MEGA65/mega65-r3-expansion-board/bridge-board-bom.md

Digikey cart for parts for 5 units

# 	PRODUCT DETAILS 	QUANTITY 	AVAILABILITY 	UNIT PRICE 	EXTENDED PRICE
1
	
‎450-1661-ND‎
‎2-1825027-0‎
SWITCH TACTILE SPST-NO 0.05A 24V
	5 	
Immediate
	0.40000 	AU$2.00
2
	
‎CF14JT10K0CT-ND‎
‎CF14JT10K0‎
RES 10K OHM 5% 1/4W AXIAL
	100 	
Immediate
	0.02570 	AU$2.57
3
	
‎4985-2044-2X06G00RA-ND‎
‎2044-2X06G00RA‎
PCB SOCKET, DOUBLE ROW, 12 PIN,
	10 	
Immediate
	1.29200 	AU$12.92
4
	
‎296-9137-1-ND‎
‎SN74CBTLV3257DR‎
IC MUX/DEMUX 4 X 1:2 16-SOIC
	10 	
Immediate
	0.64100 	AU$6.41
5
	
‎4985-2044-2X17G00SA-ND‎
‎2044-2X17G00SA‎
PCB SOCKET, DOUBLE ROW, 24 PIN,
	10 	
Immediate
	1.85600 	AU$18.56
6
	
‎2223-SSK02-FPH-254-A4-ND‎
‎SSK02-FPH-254-A4‎
2.54MM FEMALE HEADER 1X4PIN, Y T
	10 	
Immediate
	0.40000 	AU$4.00
7
	
‎2223-SSK02-FPH-254-A8-ND‎
‎SSK02-FPH-254-A8‎
2.54MM FEMALE HEADER 1X8PIN, Y T
	10 	
Immediate
	0.50700 	AU$5.07
8
	
‎4985-2047-2X05G00S3U-ND‎
‎2047-2X05G00S3U‎
PCB SOCKET, DOUBLE ROW, 10 PIN,
	5 	
Immediate
	2.16000 	AU$10.80
9
	
‎2057-PH1RB-20-UA-ND‎
‎PH1RB-20-UA‎
CONN HEADER R/A 20POS 2.54MM
	10 	
Immediate
	0.66800 	AU$6.68
10
	
‎2648-SC0918CT-ND‎
‎SC0918‎
RASPBERRY PI PICO W RP2040
	5 	
Immediate
	8.86000 	AU$44.30
11
	
‎732-3818-1-ND‎
‎693063020911‎
CONN SD CARD R/A SMD
	5 	
Immediate
	5.18000 	AU$25.90
