MEGA65/mega65-r3-expansion-board/expansion_connector_board/footprints/2-1825027-0.step

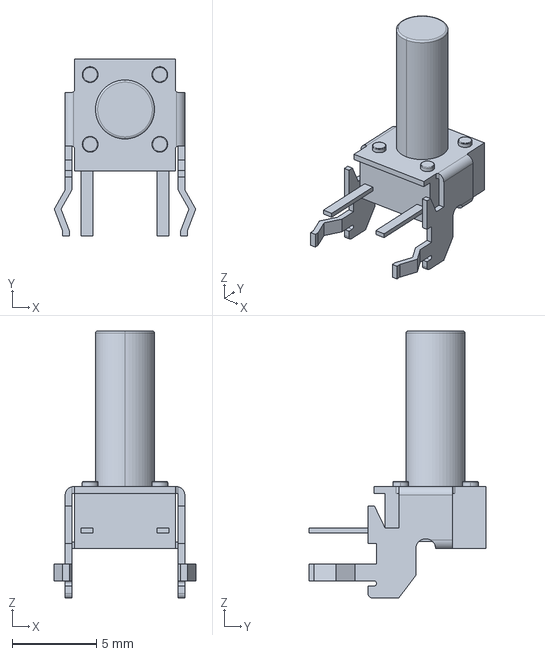
[picture p1: CAD file, 2026-07-13]
expansion_connector_board/footprints/2-1825027-0.step
8.41 x 10.5 x 15.9 mm
