MEGA65/mega65-r3-expansion-board/expansion_connector_board/footprints/10067847-001RLF.step

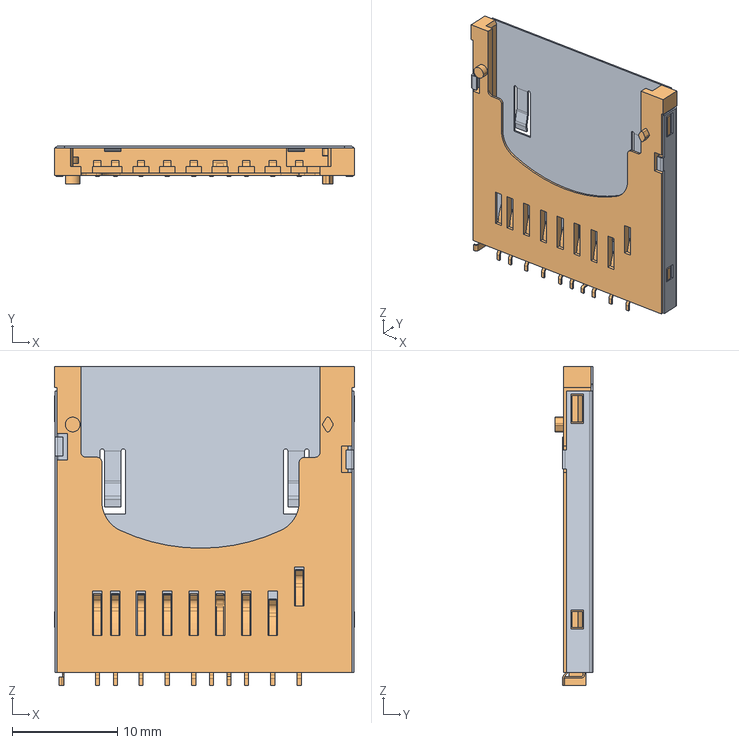
[picture p2: CAD file, 2026-07-13]
expansion_connector_board/footprints/10067847-001RLF.step
28.4 x 3.60 x 30.3 mm
PRT0003
PRT0005
