MEGA65/mega65-r3-expansion-board/(threads)

Thread 10 (2023-12-15):

Corrections to revC layout

gardners, 2023-12-15:
Move H10 10mm right.
Move H7 1mm right.
Move H9 0.25mm up and right.

Closed 2024-03-03.

Thread 11 (2023-12-15):

74LS595s are missing 5V marking on silkscreen

gardners, 2023-12-15:

Closed 2024-03-03.

Thread 12 (2024-03-03):

J6 is next to wrong power connector on expansion board

gardners, 2024-03-03:
... probably easier to move it on the bridge board. Whichever board requires a respin can have the correction.

Thread 14 (2024-03-09):

PMOD connector board is still a bit tight on revE

gardners, 2024-03-09:
Confirm estimated difference and fix. Probably another 0.5mm further apart between the two PMOD pairs. But that's just an estimate.
The boards _do_ fit together, it's just hard to put it all together.
