MEGA65/mega65-r3-expansion-board/jtag_base_board/jtag_base_board.kicad_pcb

## KiCad design jtag_base_board/jtag_base_board.kicad_pcb (2026-10-13)

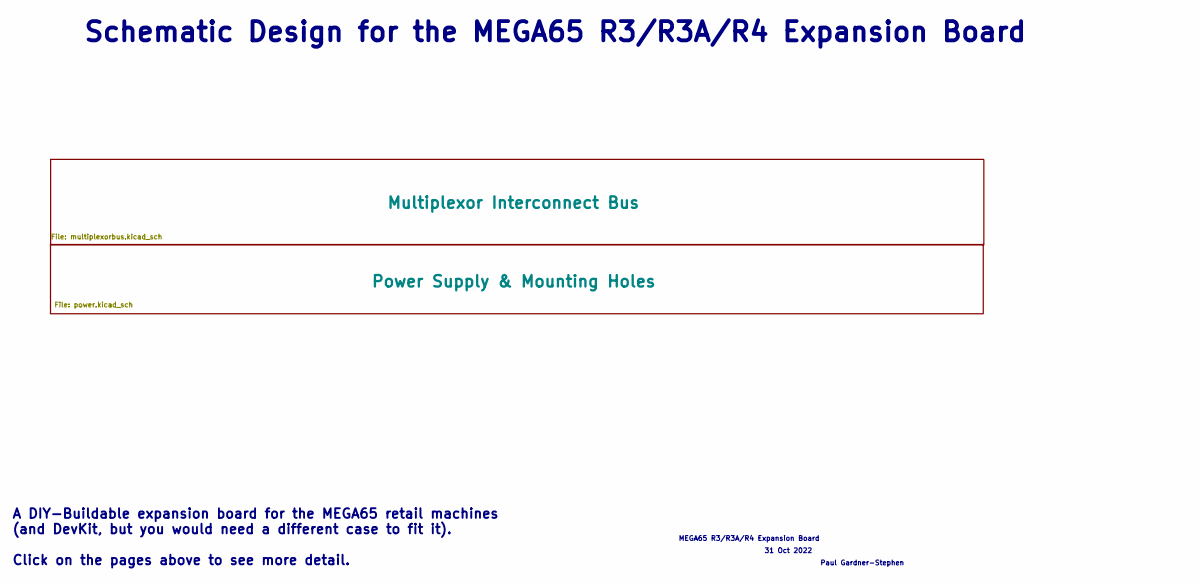
[picture p3: schematic jtag_base_board.kicad_sch]

Notes on the sheet:
Paul Gardner-Stephen
A DIY-Buildable expansion board for the MEGA65 retail machines (and DevKit, but you would need a different case to fit it). Click on the pages above to see more detail.
31 Oct 2022
MEGA65 R3/R3A/R4 Expansion Board
Schematic Design for the MEGA65 R3/R3A/R4 Expansion Board

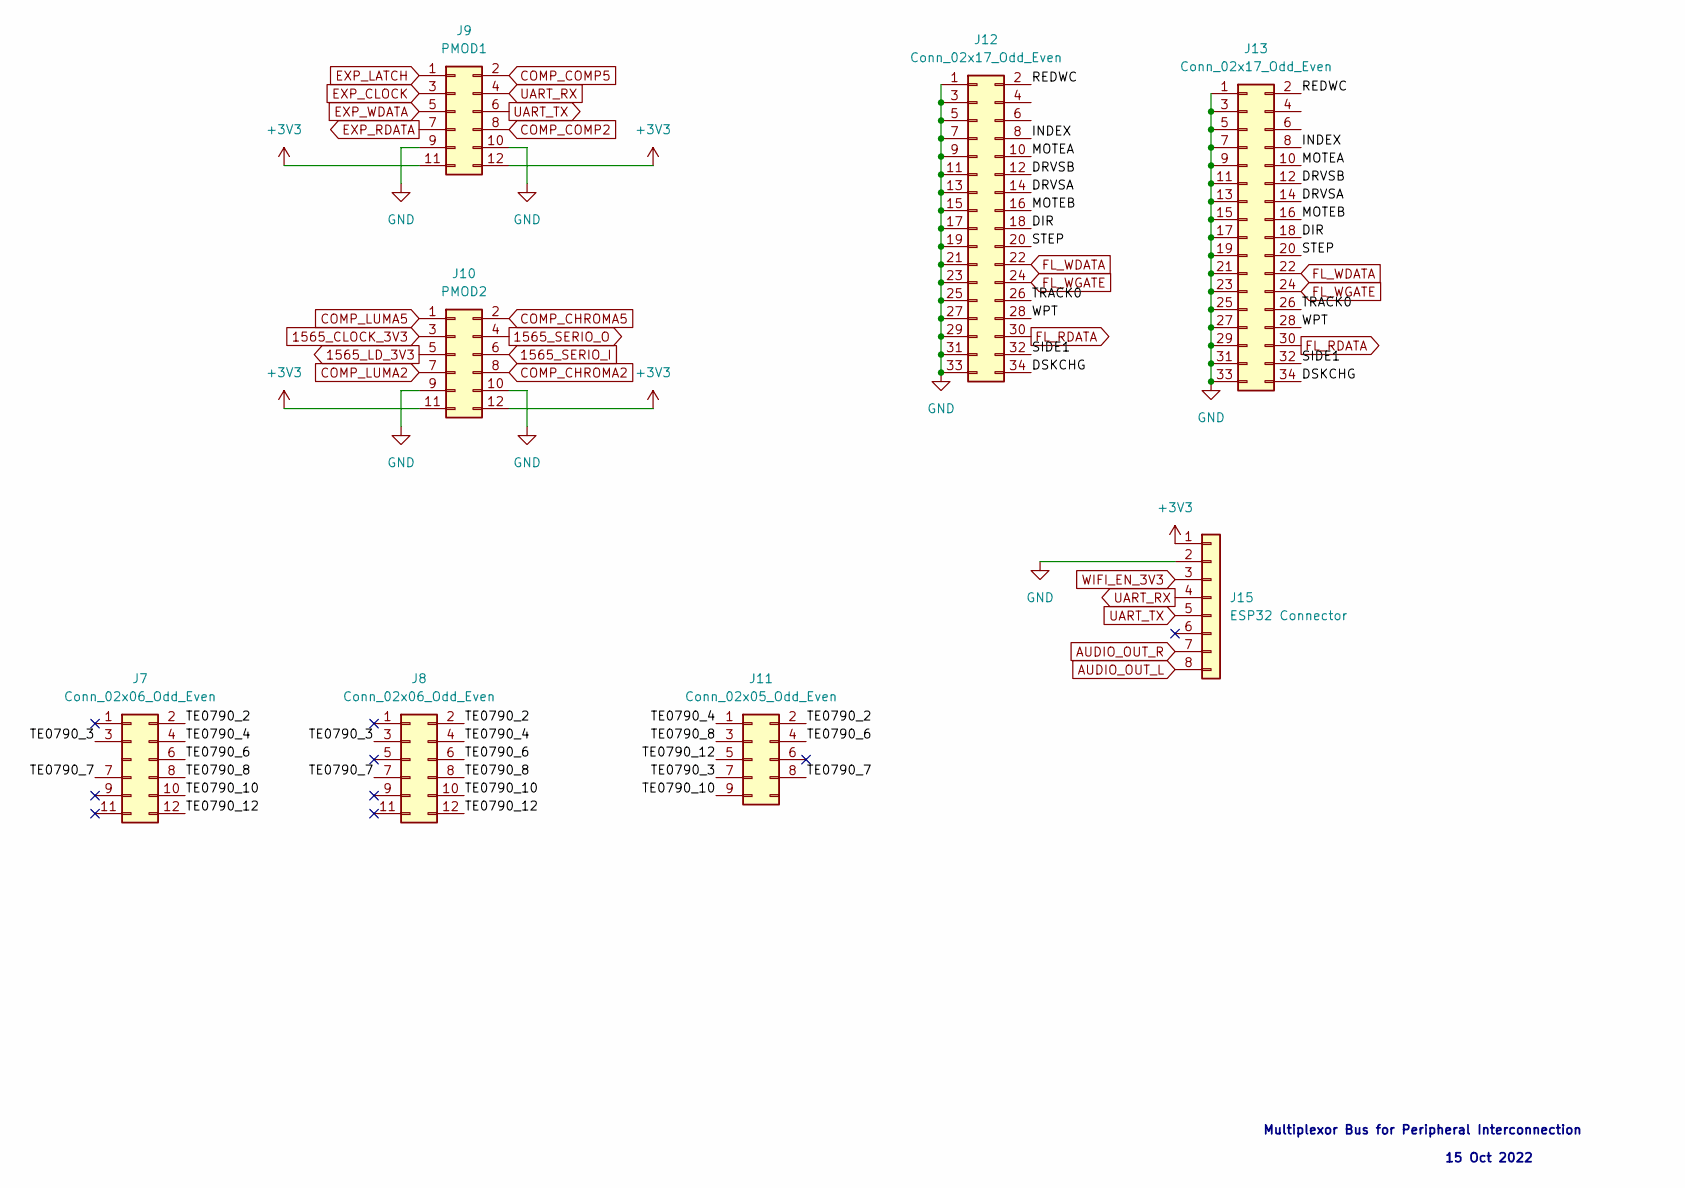
[picture p4: schematic multiplexorbus.kicad_sch]

Parts:
J7, J8: Conn_02x06_Odd_Even; PinHeader_2x06_P2.54mm_Vertical
J9: PMOD1; PinHeader_2x06_P2.54mm_Vertical
J10: PMOD2; PinHeader_2x06_P2.54mm_Vertical
J11: Conn_02x05_Odd_Even; PinHeader_2x05_P2.54mm_Vertical
J12, J13: Conn_02x17_Odd_Even; PinHeader_2x17_P2.54mm_Vertical
J15: ESP32 Connector; PinHeader_1x08_P2.54mm_Vertical

Connections:
1565_CLOCK_3V3: J10.3
1565_LD_3V3: J10.5
1565_SERIO_I: J10.6
1565_SERIO_O: J10.4
+3V3: J9.11, J9.12, J10.11, J10.12, J15.1
/Multiplexor Interconnect Bus/DIR: J12.18, J13.18
/Multiplexor Interconnect Bus/DRVSA: J12.14, J13.14
/Multiplexor Interconnect Bus/DRVSB: J12.12, J13.12
/Multiplexor Interconnect Bus/DSKCHG: J12.34, J13.34
/Multiplexor Interconnect Bus/INDEX: J12.8, J13.8
/Multiplexor Interconnect Bus/MOTEA: J12.10, J13.10
/Multiplexor Interconnect Bus/MOTEB: J12.16, J13.16
/Multiplexor Interconnect Bus/REDWC: J12.2, J13.2
/Multiplexor Interconnect Bus/SIDE1: J12.32, J13.32
/Multiplexor Interconnect Bus/STEP: J12.20, J13.20
/Multiplexor Interconnect Bus/TE0790_2: J7.2, J8.2, J11.2
/Multiplexor Interconnect Bus/TE0790_3: J7.3, J8.3, J11.7
/Multiplexor Interconnect Bus/TE0790_4: J7.4, J8.4, J11.1
/Multiplexor Interconnect Bus/TE0790_6: J7.6, J8.6, J11.4
/Multiplexor Interconnect Bus/TE0790_7: J7.7, J8.7, J11.8
/Multiplexor Interconnect Bus/TE0790_8: J7.8, J8.8, J11.3
/Multiplexor Interconnect Bus/TE0790_10: J7.10, J8.10, J11.9
/Multiplexor Interconnect Bus/TE0790_12: J7.12, J8.12, J11.5
/Multiplexor Interconnect Bus/TRACK0: J12.26, J13.26
/Multiplexor Interconnect Bus/WPT: J12.28, J13.28
AUDIO_OUT_L: J15.8
AUDIO_OUT_R: J15.7
COMP_CHROMA2: J10.8
COMP_CHROMA5: J10.2
COMP_COMP2: J9.8
COMP_COMP5: J9.2
COMP_LUMA2: J10.7
COMP_LUMA5: J10.1
EXP_CLOCK: J9.3
EXP_LATCH: J9.1
EXP_RDATA: J9.7
EXP_WDATA: J9.5
FL_RDATA: J12.30, J13.30
FL_WDATA: J12.22, J13.22
FL_WGATE: J12.24, J13.24
GND: J9.9, J9.10, J10.9, J10.10, J12.1, J12.3, J12.5, J12.7, J12.9, J12.11, J12.13, J12.15, J12.17, J12.19, J12.21, J12.23, J12.25, J12.27, J12.29, J12.31, J12.33, J13.1, J13.3, J13.5, J13.7, J13.9, J13.11, J13.13, J13.15, J13.17, J13.19, J13.21, J13.23, J13.25, J13.27, J13.29, J13.31, J13.33, J15.2; also elsewhere on the board
UART_RX: J9.4, J15.4
UART_TX: J9.6, J15.5
WIFI_EN_3V3: J15.3

Notes on the sheet:
Multiplexor Bus for Peripheral Interconnection
15 Oct 2022

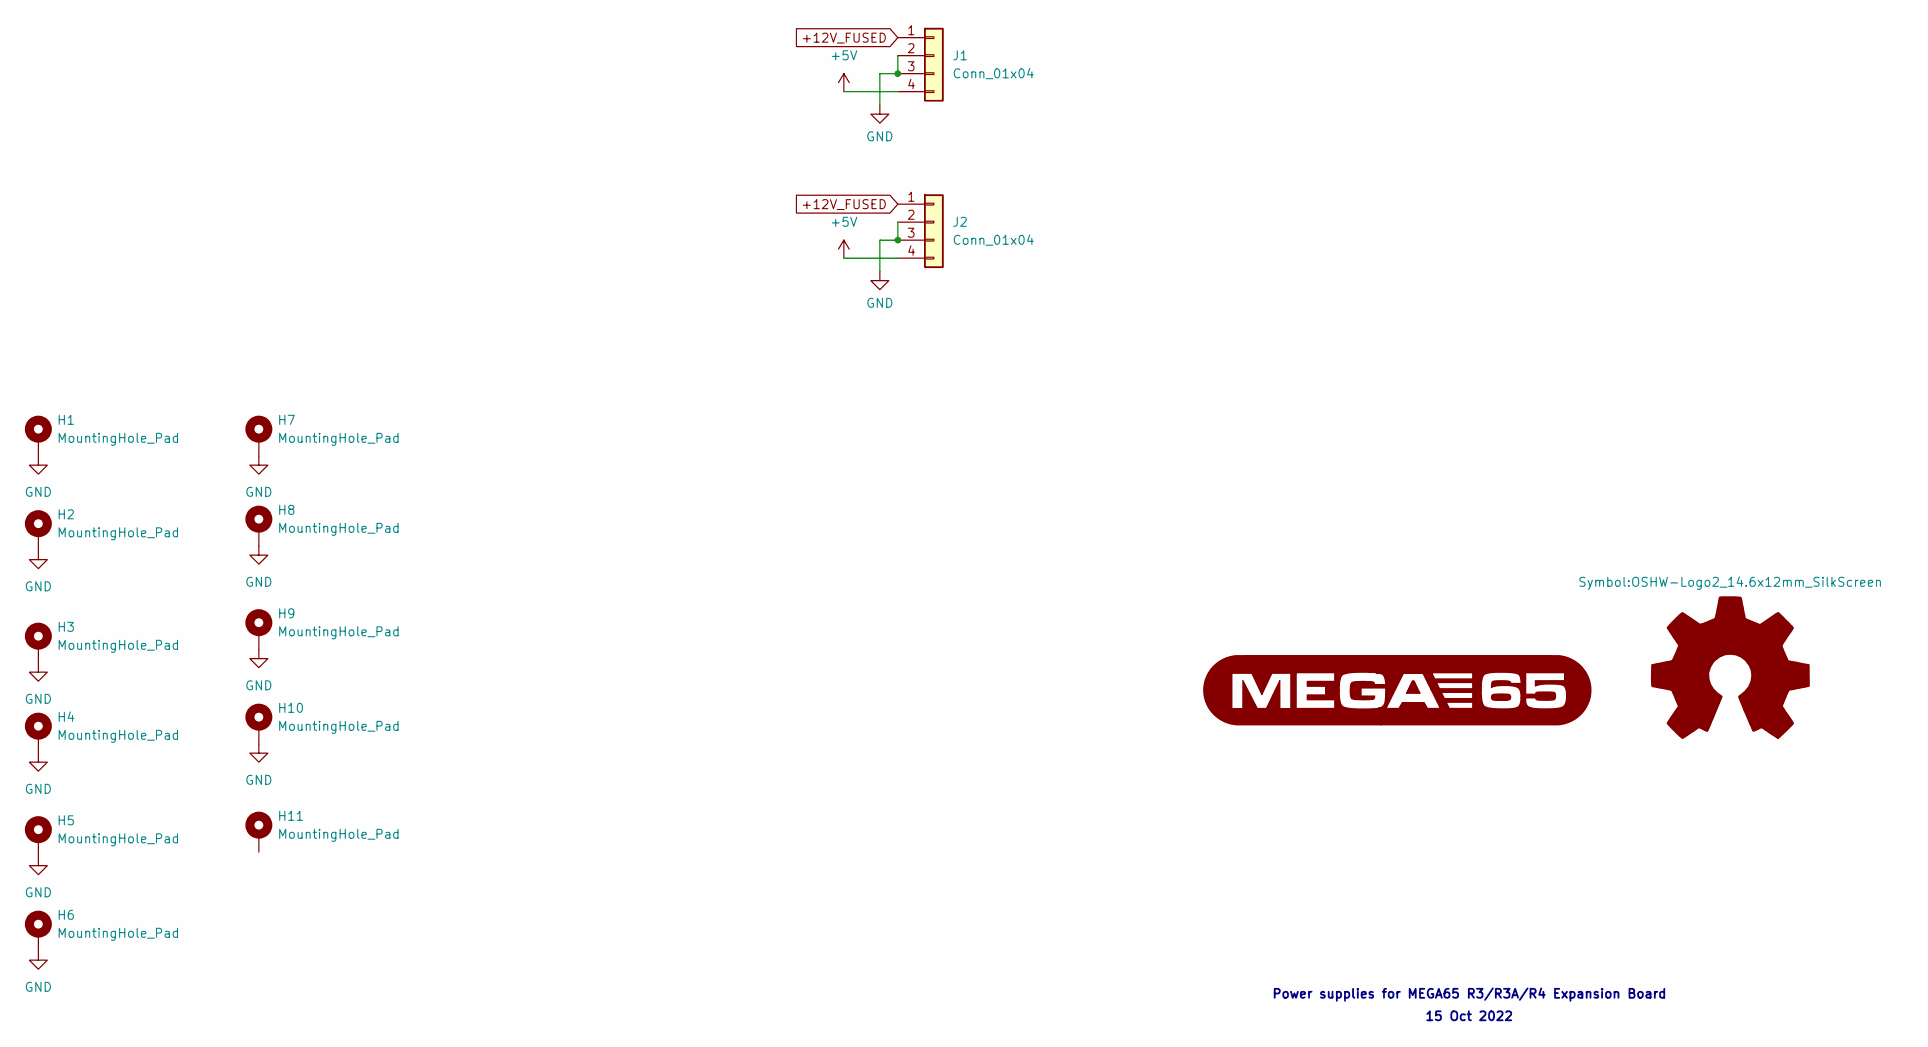
[picture p5: schematic power.kicad_sch]

Parts:
H1, H2, H3, H4, H5, H6, H7, H8, H9, H10, H11: MountingHole_Pad; MountingHole_3.2mm_M3_DIN965_Pad
J1, J2: Conn_01x04; FloppyPower
LOGO1: Logo_Open_Hardware_Large; OSHW-Logo2_14.6x12mm_SilkScreen

Connections:
+5V: J1.4, J2.4
+12V_FUSED: J1.1, J2.1
GND: H1.1 (1_1), H2.1 (1_1), H3.1 (1_1), H4.1 (1_1), H5.1 (1_1), H6.1 (1_1), H7.1 (1_1), H8.1 (1_1), H9.1 (1_1), H10.1 (1_1), J1.2, J1.3, J2.2, J2.3; also elsewhere on the board

Notes on the sheet:
Power supplies for MEGA65 R3/R3A/R4 Expansion Board
15 Oct 2022

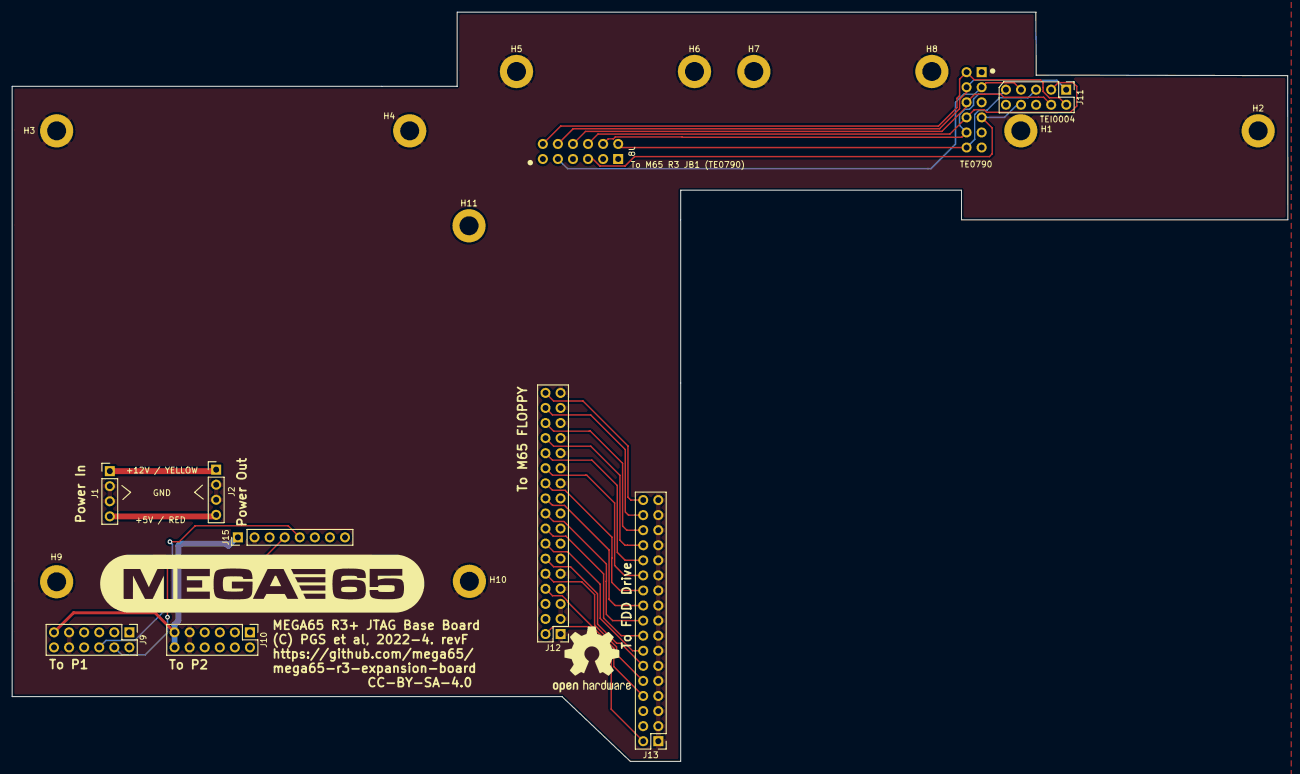
[picture p6: board jtag_base_board.kicad_pcb from above]

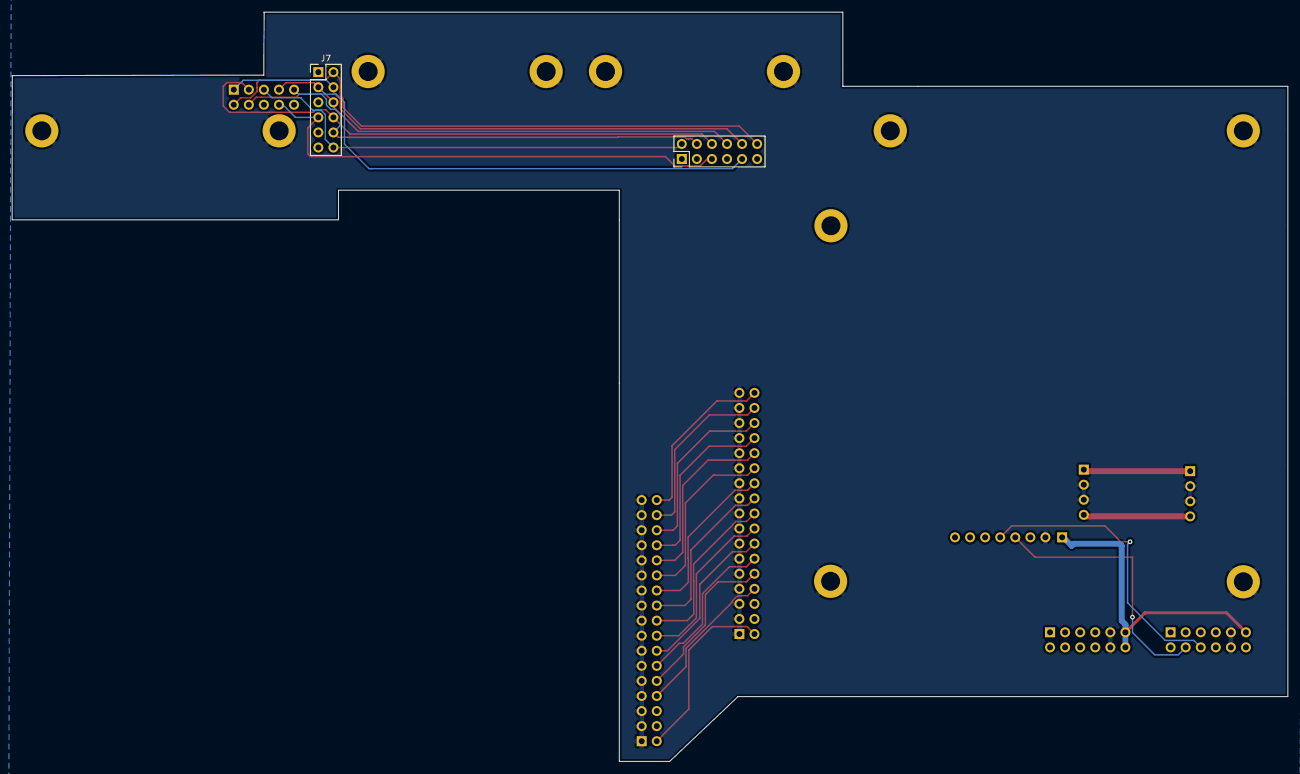
[picture p7: board jtag_base_board.kicad_pcb from below]

Board: 2 copper layers, 215.0 x 126.3 mm, 22 parts (2 on the bottom side), 29 nets.
