MEGA65/mega65-r3-expansion-board/expansion_connector_board/expansion_connector_board.kicad_pcb

## KiCad design expansion_connector_board/expansion_connector_board.kicad_pcb (2026-07-16)

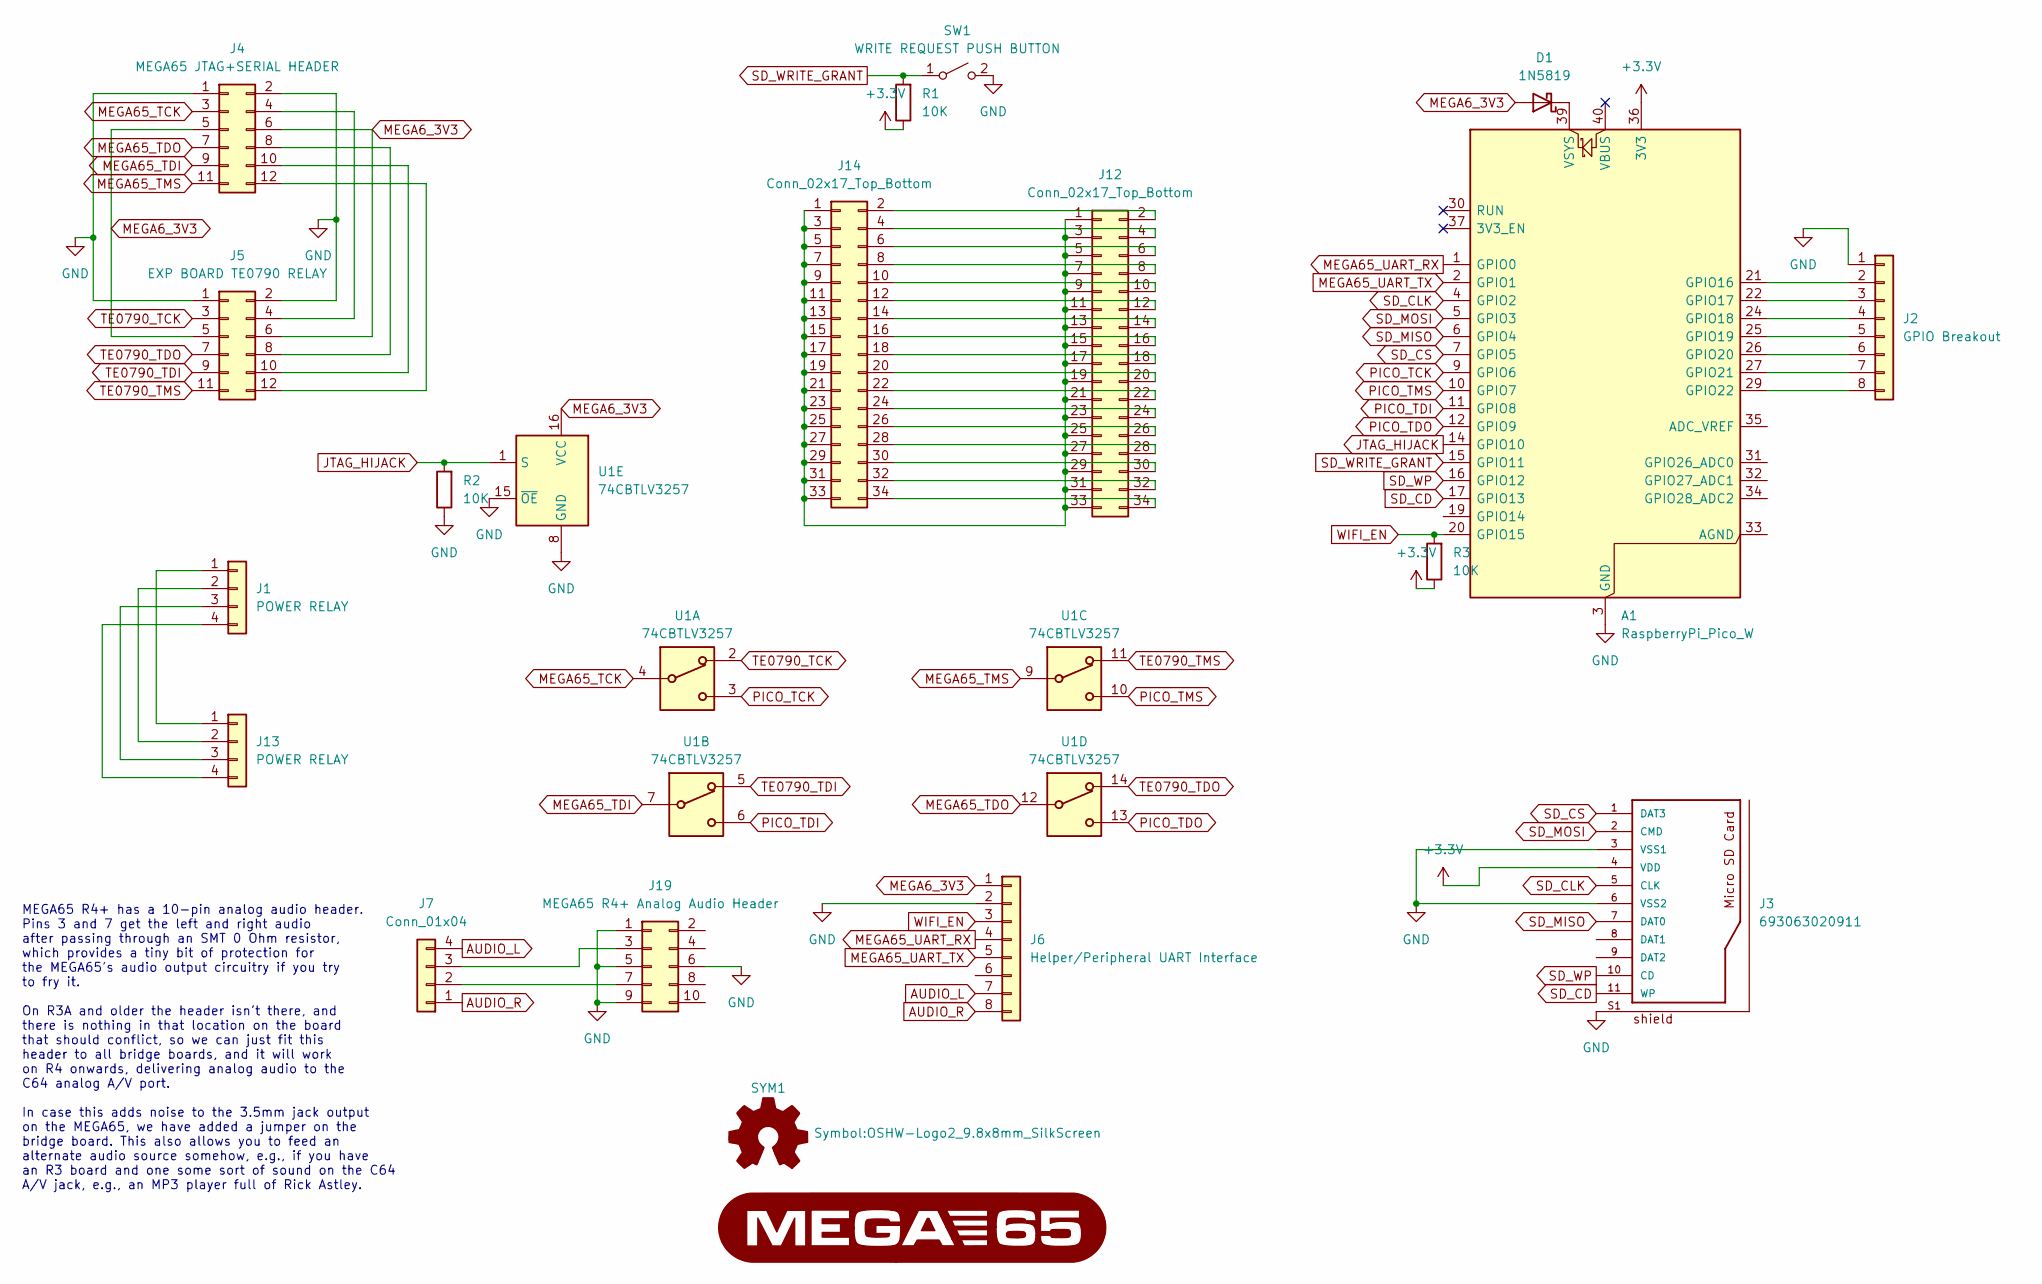
[picture p8: schematic expansion_connector_board.kicad_sch]

Parts:
A1: RaspberryPi_Pico_W; RaspberryPi_Pico_W_SMD_HandSolder
D1: 1N5819; D_DO-41_SOD81_P10.16mm_Horizontal
G1: LOGO; MEGA65-logo
J1, J13: POWER RELAY; PinHeader_1x04_P2.54mm_Vertical
J2: GPIO Breakout; PinHeader_1x08_P2.54mm_Vertical
J3: 693063020911
J4: MEGA65 JTAG+SERIAL HEADER; PinHeader_2x06_P2.54mm_Vertical
J5: EXP BOARD TE0790 RELAY; PinHeader_2x06_P2.54mm_Vertical
J6: Helper/Peripheral UART Interface; PinHeader_1x08_P2.54mm_Vertical
J7: Conn_01x04; PinHeader_1x04_P2.54mm_Vertical
J12, J14: Conn_02x17_Top_Bottom; PinHeader_2x17_P2.54mm_Vertical
J19: MEGA65 R4+ Analog Audio Header; PinHeader_2x05_P2.54mm_Vertical
R1, R2, R3: 10K; R_Axial_DIN0207_L6.3mm_D2.5mm_P10.16mm_Horizontal
SW1: WRITE REQUEST PUSH BUTTON; TE_2-1825027-0
SYM1: Logo_Open_Hardware_Small; OSHW-Logo2_9.8x8mm_SilkScreen
U1: 74CBTLV3257; SOIC-16_3.9x9.9mm_P1.27mm

Connections:
+3.3V: A1.36 (3V3), J3.4 (VDD), R1.1, R3.1
AUDIO_L: J6.7, J7.4
AUDIO_R: J6.8, J7.1
GND: A1.3 (GND), A1.8 (GND), A1.13 (GND), A1.18 (GND), A1.23 (GND), A1.28 (GND), A1.38 (GND), J2.1, J3.3 (VSS1), J3.6 (VSS2), J3.S1, J3.S2, J3.S3, J3.S4, J4.1, J4.2, J5.1, J5.2, J6.2, J19.1, J19.5, J19.6, J19.9, R2.1, SW1.2 (B), U1.8 (GND), U1.15 (~OE)
JTAG_HIJACK: A1.14 (GPIO10), R2.2, U1.1 (S)
MEGA6_3V3: D1.2 (A), J4.5, J4.6, J5.5, J5.6, J6.1, U1.16 (VCC)
MEGA65_TCK: J4.3, U1.4
MEGA65_TDI: J4.9, U1.7
MEGA65_TDO: J4.7, U1.12
MEGA65_TMS: J4.11, U1.9
MEGA65_UART_RX: A1.1 (GPIO0), J6.4
MEGA65_UART_TX: A1.2 (GPIO1), J6.5
unnamed: A1.21 (GPIO16), J2.2
unnamed: A1.22 (GPIO17), J2.3
unnamed: A1.24 (GPIO18), J2.4
unnamed: A1.25 (GPIO19), J2.5
unnamed: A1.26 (GPIO20), J2.6
unnamed: A1.27 (GPIO21), J2.7
unnamed: A1.29 (GPIO22), J2.8
unnamed: A1.39 (VSYS), D1.1 (K)
unnamed: J1.1, J13.1
unnamed: J1.2, J13.2
unnamed: J1.3, J13.3
unnamed: J1.4, J13.4
unnamed: J4.4, J5.4
unnamed: J4.8, J5.8
unnamed: J4.10, J5.10
unnamed: J4.12, J5.12
unnamed: J12.1, J12.3, J12.5, J12.7, J12.9, J12.11, J12.13, J12.15, J12.17, J12.19, J12.21, J12.23, J12.25, J12.27, J12.29, J12.31, J12.33, J14.1, J14.3, J14.5, J14.7, J14.9, J14.11, J14.13, J14.15, J14.17, J14.19, J14.21, J14.23, J14.25, J14.27, J14.29, J14.31, J14.33
unnamed: J12.2, J14.2
unnamed: J12.4, J14.4
unnamed: J12.6, J14.6
unnamed: J12.8, J14.8
unnamed: J12.10, J14.10
unnamed: J12.12, J14.12
unnamed: J12.14, J14.14
unnamed: J12.16, J14.16
unnamed: J12.18, J14.18
unnamed: J12.20, J14.20
unnamed: J12.22, J14.22
unnamed: J12.24, J14.24
unnamed: J12.26, J14.26
unnamed: J12.28, J14.28
unnamed: J12.30, J14.30
unnamed: J12.32, J14.32
unnamed: J12.34, J14.34
unnamed: J7.3, J19.3
unnamed: J7.2, J19.7
PICO_TCK: A1.9 (GPIO6), U1.3
PICO_TDI: A1.11 (GPIO8), U1.6
PICO_TDO: A1.12 (GPIO9), U1.13
PICO_TMS: A1.10 (GPIO7), U1.10
SD_CD: A1.17 (GPIO13), J3.11 (WP)
SD_CLK: A1.4 (GPIO2), J3.5 (CLK)
SD_CS: A1.7 (GPIO5), J3.1 (DAT3)
SD_MISO: A1.6 (GPIO4), J3.7 (DAT0)
SD_MOSI: A1.5 (GPIO3), J3.2 (CMD)
SD_WP: A1.16 (GPIO12), J3.10 (CD)
SD_WRITE_GRANT: A1.15 (GPIO11), R1.2, SW1.1 (A)
TE0790_TCK: J5.3, U1.2
TE0790_TDI: J5.9, U1.5
TE0790_TDO: J5.7, U1.14
TE0790_TMS: J5.11, U1.11
WIFI_EN: A1.20 (GPIO15), J6.3, R3.2

Notes on the sheet:
MEGA65 R4+ has a 10-pin analog audio header. Pins 3 and 7 get the left and right audio after passing through an SMT 0 Ohm resistor, which provides a tiny bit of protection for the MEGA65's audio output circuitry if you try to fry it. On R3A and older the header isn't there, and there is nothing in 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

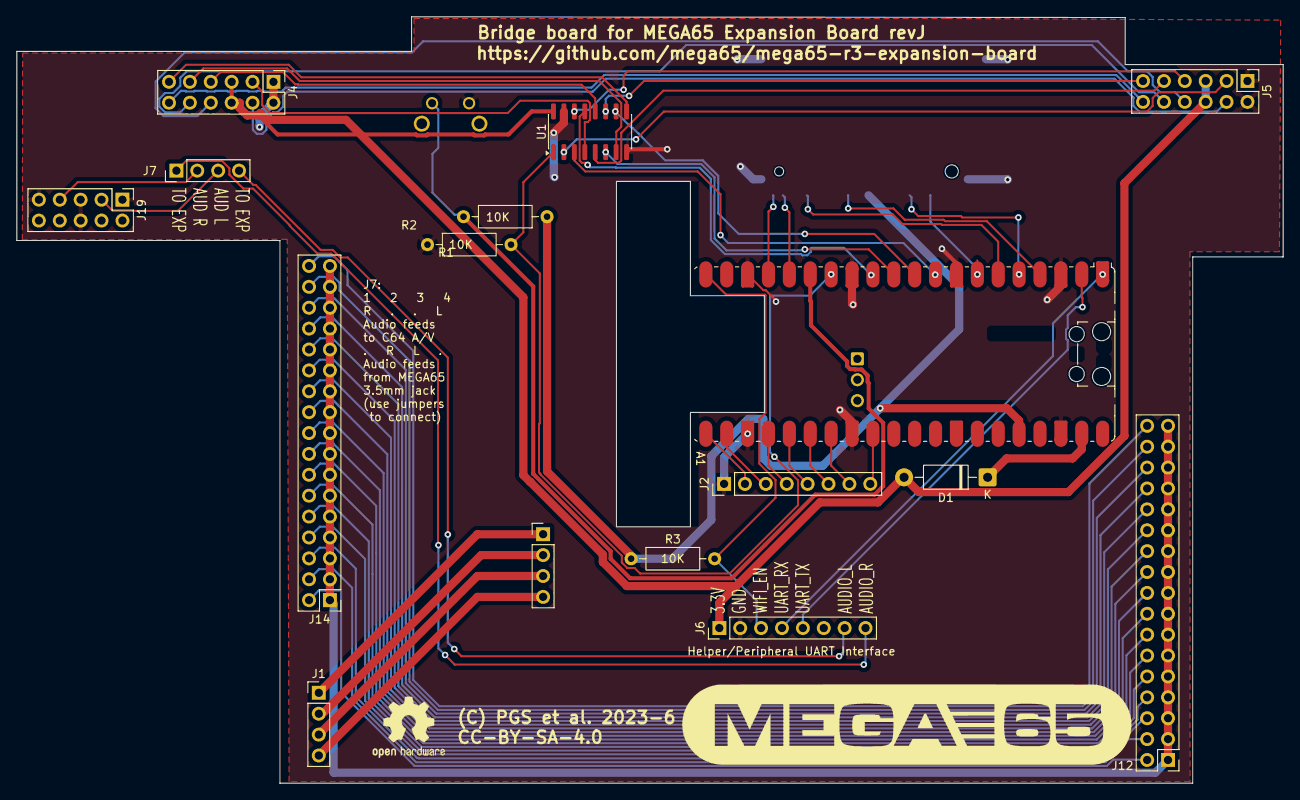
[picture p9: board expansion_connector_board.kicad_pcb from above]

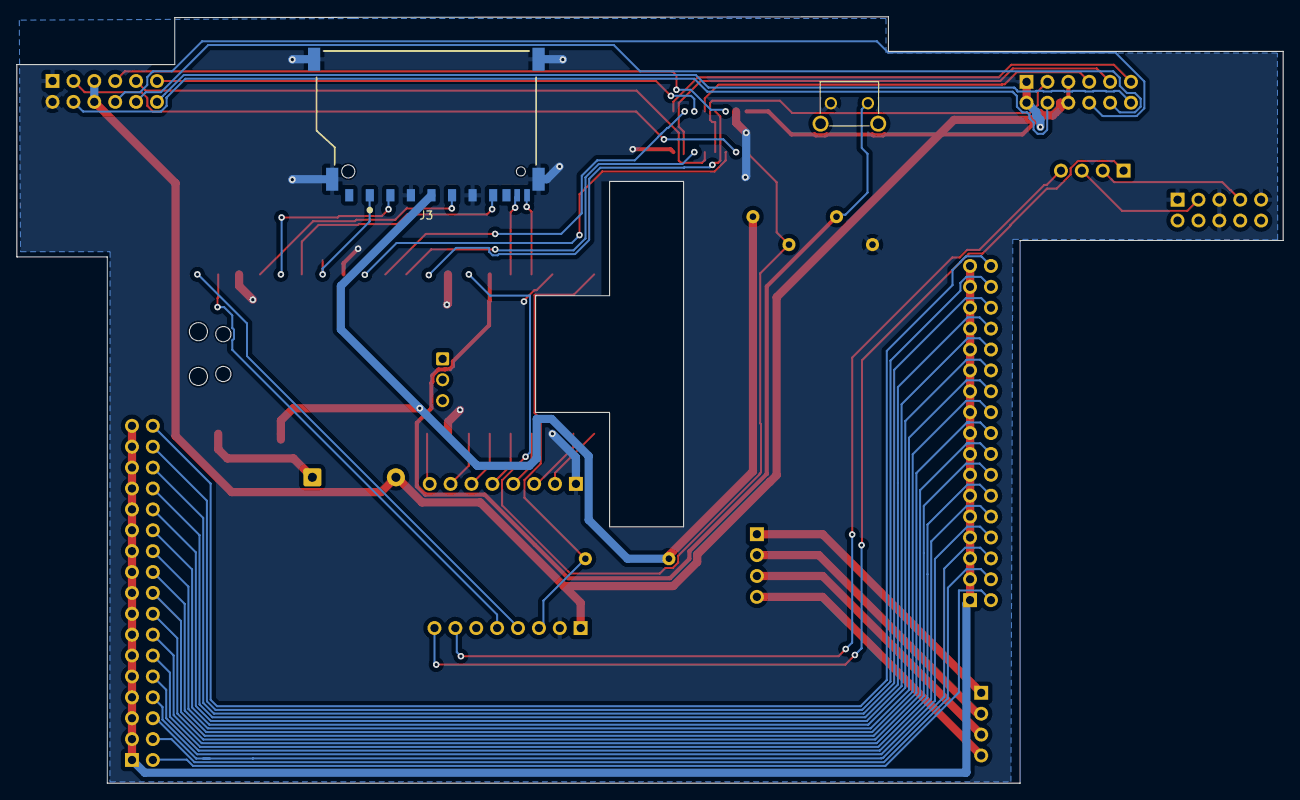
[picture p10: board expansion_connector_board.kicad_pcb from below]

Board: 2 copper layers, 154.0 x 93.2 mm, 20 parts (2 on the bottom side), 64 nets.
