MEGA65/mega65-r3-expansion-board/mega65-r3-expansion-board.kicad.kicad_pcb

## KiCad design mega65-r3-expansion-board.kicad.kicad_pcb (2026-07-13)

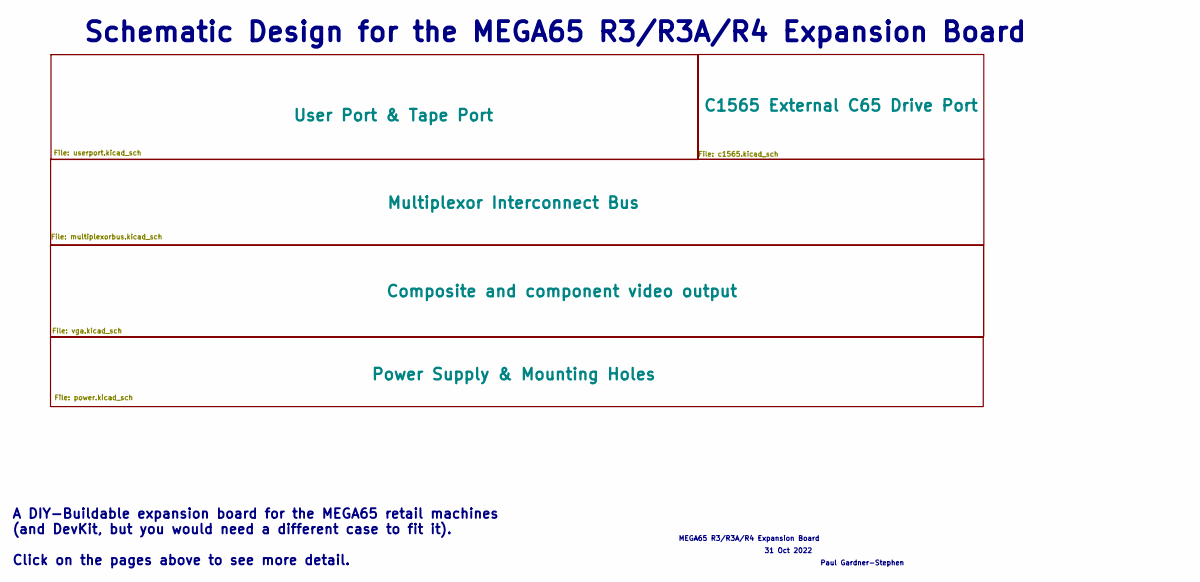
[picture p11: schematic mega65-r3-expansion-board.kicad.kicad_sch]

Notes on the sheet:
Paul Gardner-Stephen
A DIY-Buildable expansion board for the MEGA65 retail machines (and DevKit, but you would need a different case to fit it). Click on the pages above to see more detail.
31 Oct 2022
MEGA65 R3/R3A/R4 Expansion Board
Schematic Design for the MEGA65 R3/R3A/R4 Expansion Board

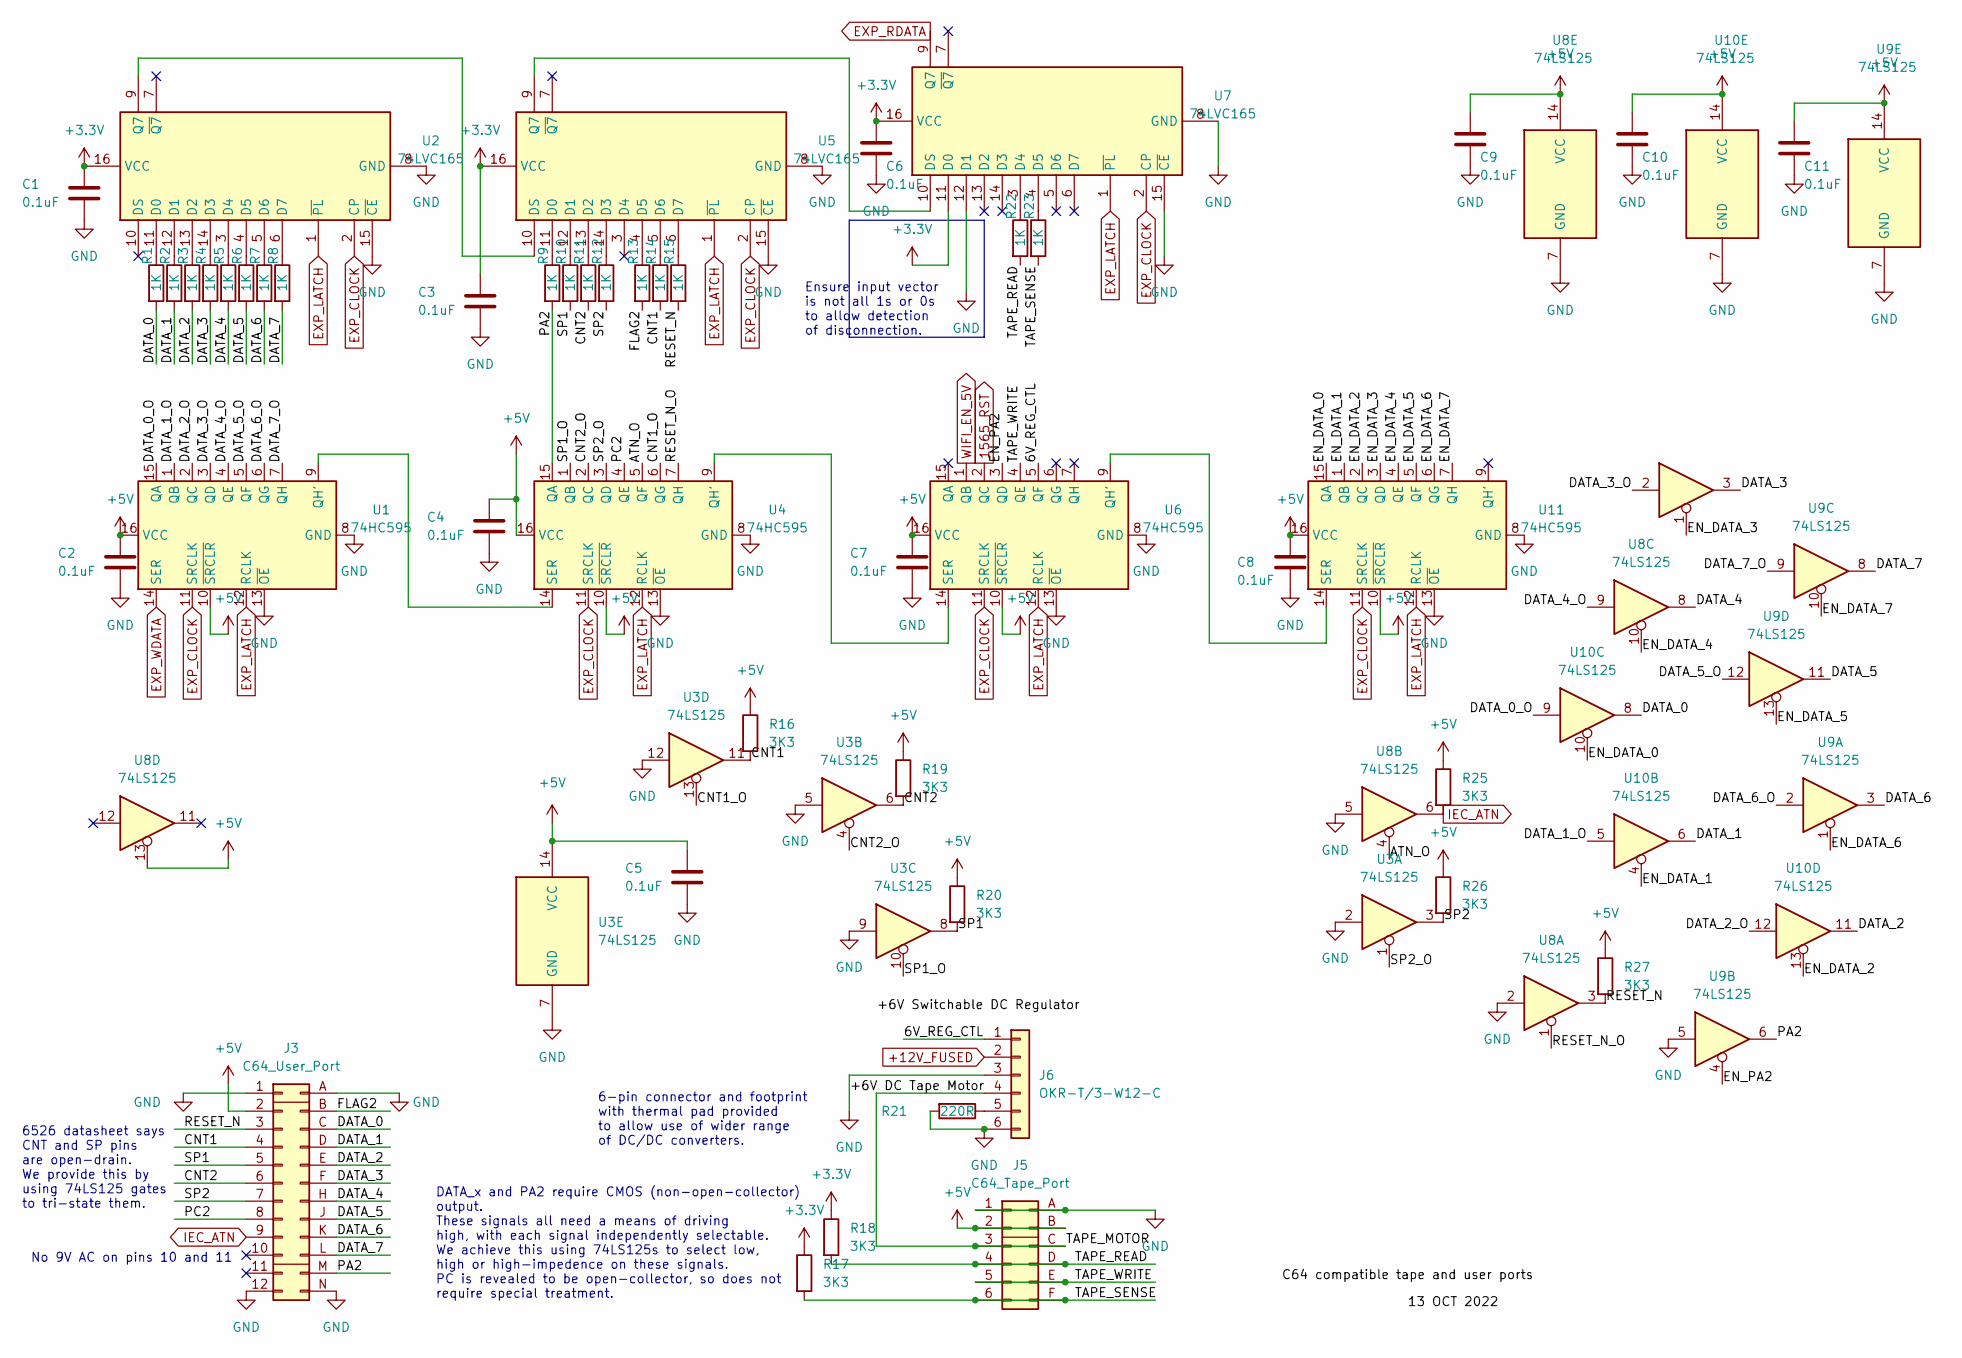
[picture p12: schematic userport.kicad_sch]

Parts:
C1, C2, C3, C4, C5, C6, C7, C8, C9, C10, C11: 0.1uF; C_Disc_D5.0mm_W2.5mm_P5.00mm
J3: C64_User_Port; C64-User-Port-Male
J5: C64_Tape_Port; C64-Cassette-Port-Male
J6: OKR-T/3-W12-C; TO-220-FP-5
R1, R2, R3, R4, R5, R6, R7, R8, R9, R10, R11, R12, R13, R14, R15, R22, R23: 1K; Labeled Resistor
R16, R17, R18, R19, R20, R25, R26, R27: 3K3; Labeled Resistor
R21: 220R; Labeled Resistor
U1, U4, U6, U11: 74HC595; DIP-16_LS_Family
U2, U5, U7: 74LVC165; DIP-16_LVC_Family
U3, U8, U9, U10: 74LS125; DIP-14_74LS06

Connections:
1565_RST: U6.2 (QC); also elsewhere on the board
+3V3: C1.1, C3.1, C6.1, R17.1, R18.1, U2.16 (VCC), U5.16 (VCC), U7.11 (D0), U7.16 (VCC); also elsewhere on the board
+5V: C2.1, C4.1, C5.1, C7.1, C8.1, C9.1, C10.1, C11.1, J3.2, J5.2, J5.B, R16.1, R19.1, R20.1, R25.1, R26.1, R27.1, U1.10 (~SRCLR), U1.16 (VCC), U3.14 (VCC), U4.10 (~SRCLR), U4.16 (VCC), U6.10 (~SRCLR), U6.16 (VCC), U8.13, U8.14 (VCC), U9.14 (VCC), U10.14 (VCC), U11.10 (~SRCLR), U11.16 (VCC); also elsewhere on the board
+12V_FUSED: J6.2; also elsewhere on the board
/User Port & Tape Port/6V_REG_CTL: J6.1, U6.5 (QF)
/User Port & Tape Port/ATN_O: U4.5 (QF), U8.4
/User Port & Tape Port/CNT1: J3.4, R14.2, R16.2, U3.11
/User Port & Tape Port/CNT1_O: U3.13, U4.6 (QG)
/User Port & Tape Port/CNT2: J3.6, R11.2, R19.2, U3.6
/User Port & Tape Port/CNT2_O: U3.4, U4.2 (QC)
/User Port & Tape Port/DATA_0: J3.C, R1.2, U10.8
/User Port & Tape Port/DATA_0_O: U1.15 (QA), U10.9
/User Port & Tape Port/DATA_1: J3.D, R2.2, U10.6
/User Port & Tape Port/DATA_1_O: U1.1 (QB), U10.5
/User Port & Tape Port/DATA_2: J3.E, R3.2, U10.11
/User Port & Tape Port/DATA_2_O: U1.2 (QC), U10.12
/User Port & Tape Port/DATA_3: J3.F, R4.2, U10.3
/User Port & Tape Port/DATA_3_O: U1.3 (QD), U10.2
/User Port & Tape Port/DATA_4: J3.H, R5.2, U8.8
/User Port & Tape Port/DATA_4_O: U1.4 (QE), U8.9
/User Port & Tape Port/DATA_5: J3.J, R6.2, U9.11
/User Port & Tape Port/DATA_5_O: U1.5 (QF), U9.12
/User Port & Tape Port/DATA_6: J3.K, R7.2, U9.3
/User Port & Tape Port/DATA_6_O: U1.6 (QG), U9.2
/User Port & Tape Port/DATA_7: J3.L, R8.2, U9.8
/User Port & Tape Port/DATA_7_O: U1.7 (QH), U9.9
/User Port & Tape Port/EN_DATA_0: U10.10, U11.15 (QA)
/User Port & Tape Port/EN_DATA_1: U10.4, U11.1 (QB)
/User Port & Tape Port/EN_DATA_2: U10.13, U11.2 (QC)
/User Port & Tape Port/EN_DATA_3: U10.1, U11.3 (QD)
/User Port & Tape Port/EN_DATA_4: U8.10, U11.4 (QE)
/User Port & Tape Port/EN_DATA_5: U9.13, U11.5 (QF)
/User Port & Tape Port/EN_DATA_6: U9.1, U11.6 (QG)
/User Port & Tape Port/EN_DATA_7: U9.10, U11.7 (QH)
/User Port & Tape Port/EN_PA2: U6.3 (QD), U9.4
/User Port & Tape Port/FLAG2: J3.B, R13.2
/User Port & Tape Port/PA2: J3.M, R9.2, U4.15 (QA), U9.6
/User Port & Tape Port/PC2: J3.8, U4.4 (QE)
/User Port & Tape Port/RESET_N: J3.3, R15.2, R27.2, U8.3
/User Port & Tape Port/RESET_N_O: U4.7 (QH), U8.1
/User Port & Tape Port/SP1: J3.5, R10.2, R20.2, U3.8
/User Port & Tape Port/SP1_O: U3.10, U4.1 (QB)
/User Port & Tape Port/SP2: J3.7, R12.2, R26.2, U3.3
/User Port & Tape Port/SP2_O: U3.1, U4.3 (QD)
/User Port & Tape Port/TAPE_MOTOR: J5.3, J5.C, J6.4
/User Port & Tape Port/TAPE_READ: J5.4, J5.D, R18.2, R22.2
/User Port & Tape Port/TAPE_SENSE: J5.6, J5.F, R17.2, R23.2
/User Port & Tape Port/TAPE_WRITE: J5.5, J5.E, U6.4 (QE)
EXP_CLOCK: U1.11 (SRCLK), U2.2 (CP), U4.11 (SRCLK), U5.2 (CP), U6.11 (SRCLK), U7.2 (CP), U11.11 (SRCLK); also elsewhere on the board
EXP_LATCH: U1.12 (RCLK), U2.1 (~PL), U4.12 (RCLK), U5.1 (~PL), U6.12 (RCLK), U7.1 (~PL), U11.12 (RCLK); also elsewhere on the board
EXP_RDATA: U7.9 (Q7); also elsewhere on the board
EXP_WDATA: U1.14 (SER); also elsewhere on the board
GND: C1.2, C2.2, C3.2, C4.2, C5.2, C6.2, C7.2, C8.2, C9.2, C10.2, C11.2, J3.1, J3.12, J3.A, J3.N, J5.1, J5.A, J6.3, J6.6, R21.2, U1.8 (GND), U1.13 (~OE), U2.8 (GND), U2.15 (~CE), U3.2, U3.5, U3.7 (GND), U3.9, U3.12, U4.8 (GND), U4.13 (~OE), U5.8 (GND), U5.15 (~CE), U6.8 (GND), U6.13 (~OE), U7.8 (GND), U7.12 (D1), U7.15 (~CE), U8.2, U8.5, U8.7 (GND), U9.5, U9.7 (GND), U10.7 (GND), U11.8 (GND), U11.13 (~OE); also elsewhere on the board
IEC_ATN: J3.9, R25.2, U8.6
unnamed: J6.5, R21.1
unnamed: U1.9 (QH'), U4.14 (SER)
unnamed: R1.1, U2.11 (D0)
unnamed: R2.1, U2.12 (D1)
unnamed: R3.1, U2.13 (D2)
unnamed: R4.1, U2.14 (D3)
unnamed: R5.1, U2.3 (D4)
unnamed: R6.1, U2.4 (D5)
unnamed: R7.1, U2.5 (D6)
unnamed: R8.1, U2.6 (D7)
unnamed: U2.9 (Q7), U5.10 (DS)
unnamed: U4.9 (QH'), U6.14 (SER)
unnamed: R9.1, U5.11 (D0)
unnamed: R10.1, U5.12 (D1)
unnamed: R11.1, U5.13 (D2)
unnamed: R12.1, U5.14 (D3)
unnamed: R13.1, U5.4 (D5)
unnamed: R14.1, U5.5 (D6)
unnamed: R15.1, U5.6 (D7)
unnamed: U5.9 (Q7), U7.10 (DS)
unnamed: R22.1, U7.3 (D4)
unnamed: R23.1, U7.4 (D5)
unnamed: U6.9 (QH'), U11.14 (SER)
WIFI_EN_5V: U6.1 (QB); also elsewhere on the board

Notes on the sheet:
No 9V AC on pins 10 and 11
6526 datasheet says CNT and SP pins are open-drain. We provide this by using 74LS125 gates to tri-state them.
Ensure input vector is not all 1s or 0s to allow detection of disconnection.
6-pin connector and footprint with thermal pad provided to allow use of wider range of DC/DC converters.
DATA_x and PA2 require CMOS (non-open-collector) output. These signals all need a means of driving high, with each signal independently selectable. We achieve this using 74LS125s to select low, high or high-impedence on these signals. PC is revealed to be open-collector, so does not require special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
