MEGA65/mega65-r3-expansion-board/mega65-r3-expansion-board.kicad.kicad_pcb

## KiCad design mega65-r3-expansion-board.kicad.kicad_pcb (continued)

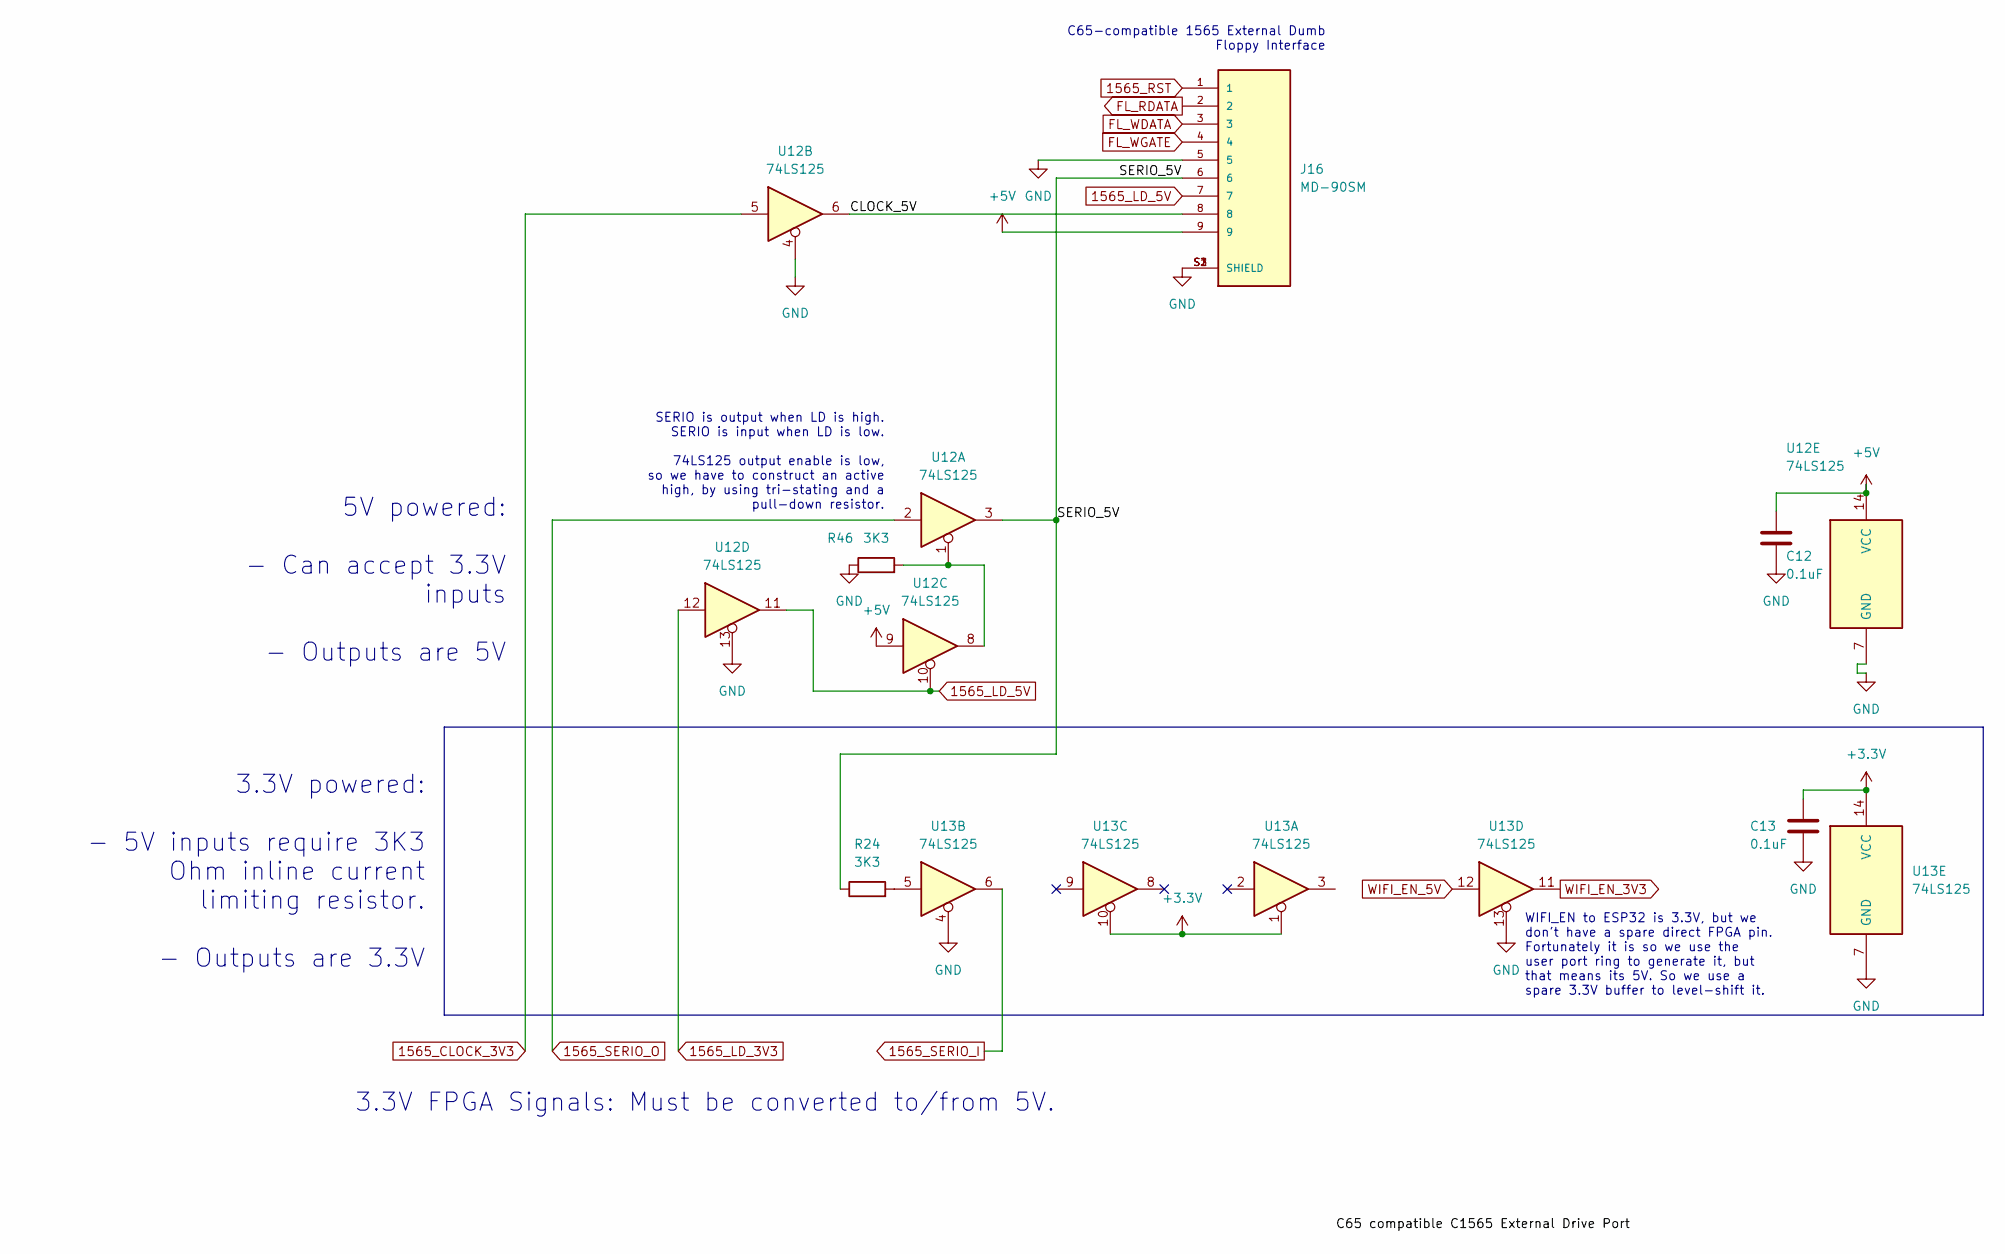
[picture p13: schematic c1565.kicad_sch]

Parts:
C12, C13: 0.1uF; C_Disc_D5.0mm_W2.5mm_P5.00mm
J16: MD-90SM; CUI_MD-90SM; PARTREV 02/18/2022
R24, R46: 3K3; Labeled Resistor
U12: 74LS125; DIP-14_W7.62mm
U13: 74LS125; DIP-14_74LS06

Connections:
1565_CLOCK_3V3: U12.5; also elsewhere on the board
1565_LD_3V3: U12.12; also elsewhere on the board
1565_LD_5V: J16.7, U12.10, U12.11
1565_RST: J16.1; also elsewhere on the board
1565_SERIO_I: U13.6; also elsewhere on the board
1565_SERIO_O: U12.2; also elsewhere on the board
+3V3: C13.1, U13.1, U13.10, U13.14 (VCC); also elsewhere on the board
+5V: C12.1, J16.9, U12.9, U12.14 (VCC); also elsewhere on the board
/C1565 External C65 Drive Port/CLOCK_5V: J16.8, U12.6
/C1565 External C65 Drive Port/SERIO_5V: J16.6, R24.1, U12.3
FL_RDATA: J16.2; also elsewhere on the board
FL_WDATA: J16.3; also elsewhere on the board
FL_WGATE: J16.4; also elsewhere on the board
GND: C12.2, C13.2, J16.5, J16.S1 (SHIELD), J16.S2 (SHIELD), J16.S3 (SHIELD), R46.1, U12.4, U12.7 (GND), U12.13, U13.4, U13.7 (GND), U13.13; also elsewhere on the board
unnamed: R24.2, U13.5
unnamed: R46.2, U12.1, U12.8
WIFI_EN_3V3: U13.11; also elsewhere on the board
WIFI_EN_5V: U13.12; also elsewhere on the board

Notes on the sheet:
5V powered: - Can accept 3.3V inputs - Outputs are 5V
3.3V powered: - 5V inputs require 3K3 Ohm inline current limiting resistor. - Outputs are 3.3V
C65-compatible 1565 External Dumb Floppy Interface
SERIO is output when LD is high. SERIO is input when LD is low. 74LS125 output enable is low, so we have to construct an active high, by using tri-stating and a pull-down resistor.
3.3V FPGA Signals: Must be converted to/from 5V.
WIFI_EN to ESP32 is 3.3V, but we don't have a spare direct FPGA pin. Fortunately it is so we use the user port ring to generate it, but that means its 5V. So we use a spare 3.3V buffer to level-shift it.

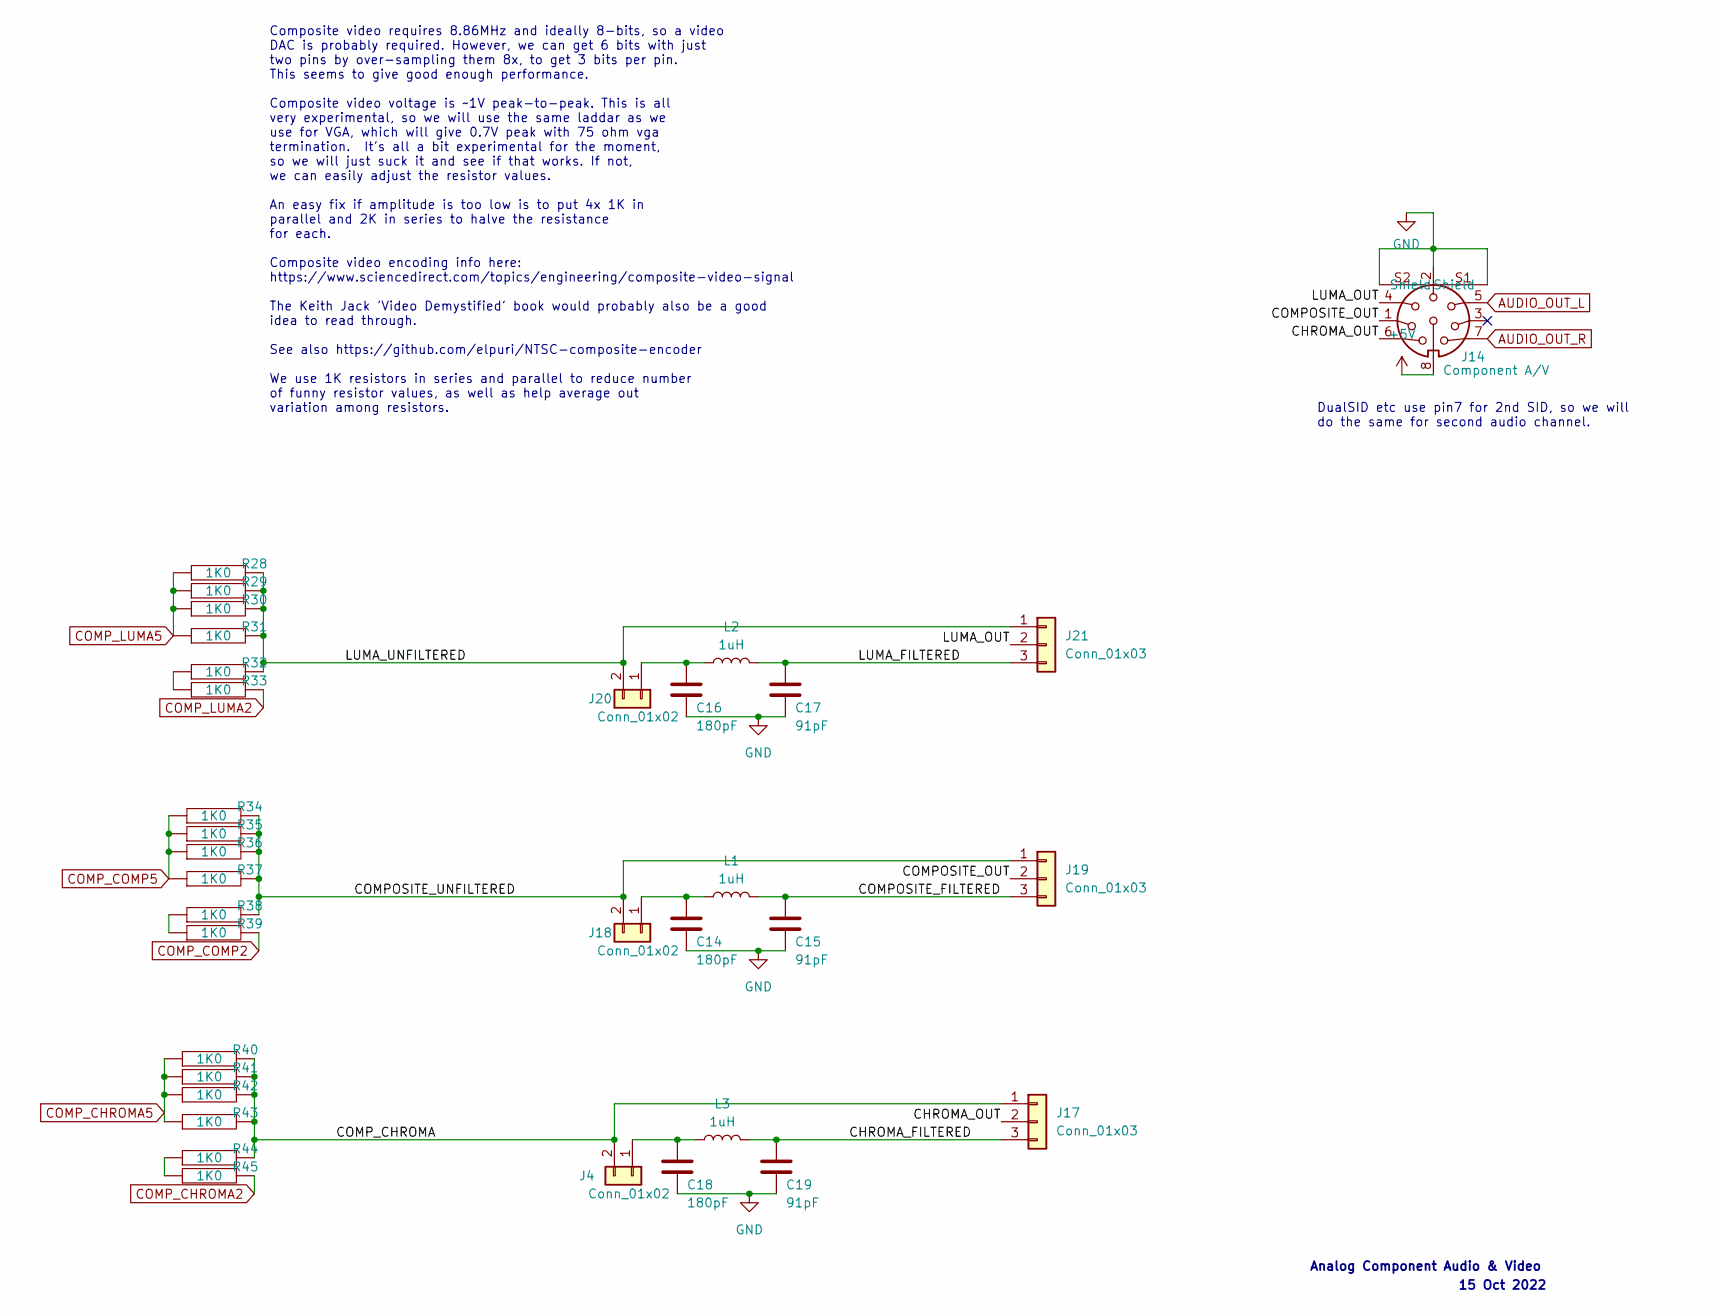
[picture p14: schematic vga.kicad_sch]

Parts:
C14, C16, C18: 180pF; C_Disc_D5.0mm_W2.5mm_P5.00mm
C15, C17, C19: 91pF; C_Disc_D5.0mm_W2.5mm_P5.00mm
J4, J18, J20: Conn_01x02; PinSocket_1x02_P2.54mm_Vertical
J14: Component A/V; CUI_SDF-80J
J17, J19, J21: Conn_01x03; PinSocket_1x03_P2.54mm_Vertical
L1, L2, L3: 1uH; L_Axial_L6.6mm_D2.7mm_P2.54mm_Vertical_Vishay_IM-2
R28, R29, R30, R31, R32, R33, R34, R35, R36, R37, R38, R39, R40, R41, R42, R43, R44, R45: 1K0; Labeled Resistor

Connections:
+5V: J14.8; also elsewhere on the board
/Composite and component video output/CHROMA_FILTERED: C19.1, J17.3, L3.2
/Composite and component video output/CHROMA_OUT: J14.6, J17.2
/Composite and component video output/COMPOSITE_FILTERED: C15.1, J19.3, L1.2
/Composite and component video output/COMPOSITE_OUT: J14.1, J19.2
/Composite and component video output/COMPOSITE_UNFILTERED: J18.2, J19.1, R34.2, R35.2, R36.2, R37.2, R38.2
/Composite and component video output/COMP_CHROMA: J4.2, J17.1, R40.2, R41.2, R42.2, R43.2, R44.2
/Composite and component video output/LUMA_FILTERED: C17.1, J21.3, L2.2
/Composite and component video output/LUMA_OUT: J14.4, J21.2
/Composite and component video output/LUMA_UNFILTERED: J20.2, J21.1, R28.2, R29.2, R30.2, R31.2, R32.2
AUDIO_OUT_L: J14.5; also elsewhere on the board
AUDIO_OUT_R: J14.3; also elsewhere on the board
COMP_CHROMA2: R45.2; also elsewhere on the board
COMP_CHROMA5: R40.1, R41.1, R42.1, R43.1; also elsewhere on the board
COMP_COMP2: R39.2; also elsewhere on the board
COMP_COMP5: R34.1, R35.1, R36.1, R37.1; also elsewhere on the board
COMP_LUMA2: R33.2; also elsewhere on the board
COMP_LUMA5: R28.1, R29.1, R30.1, R31.1; also elsewhere on the board
GND: C14.2, C15.2, C16.2, C17.2, C18.2, C19.2, J14.2, J14.S1 (Shield), J14.S2 (Shield); also elsewhere on the board
unnamed: C18.1, J4.1, L3.1
unnamed: C14.1, J18.1, L1.1
unnamed: C16.1, J20.1, L2.1
unnamed: R32.1, R33.1
unnamed: R38.1, R39.1
unnamed: R44.1, R45.1

Notes on the sheet:
15 Oct 2022
Composite video requires 8.86MHz and ideally 8-bits, so a video DAC is probably required. However, we can get 6 bits with just two pins by over-sampling them 8x, to get 3 bits per pin. This seems to give good enough performance. Composite video voltage is ~1V peak-to-peak. This is all very experime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
DualSID etc use pin7 for 2nd SID, so we will do the same for second audio channel.
Analog Component Audio & Video

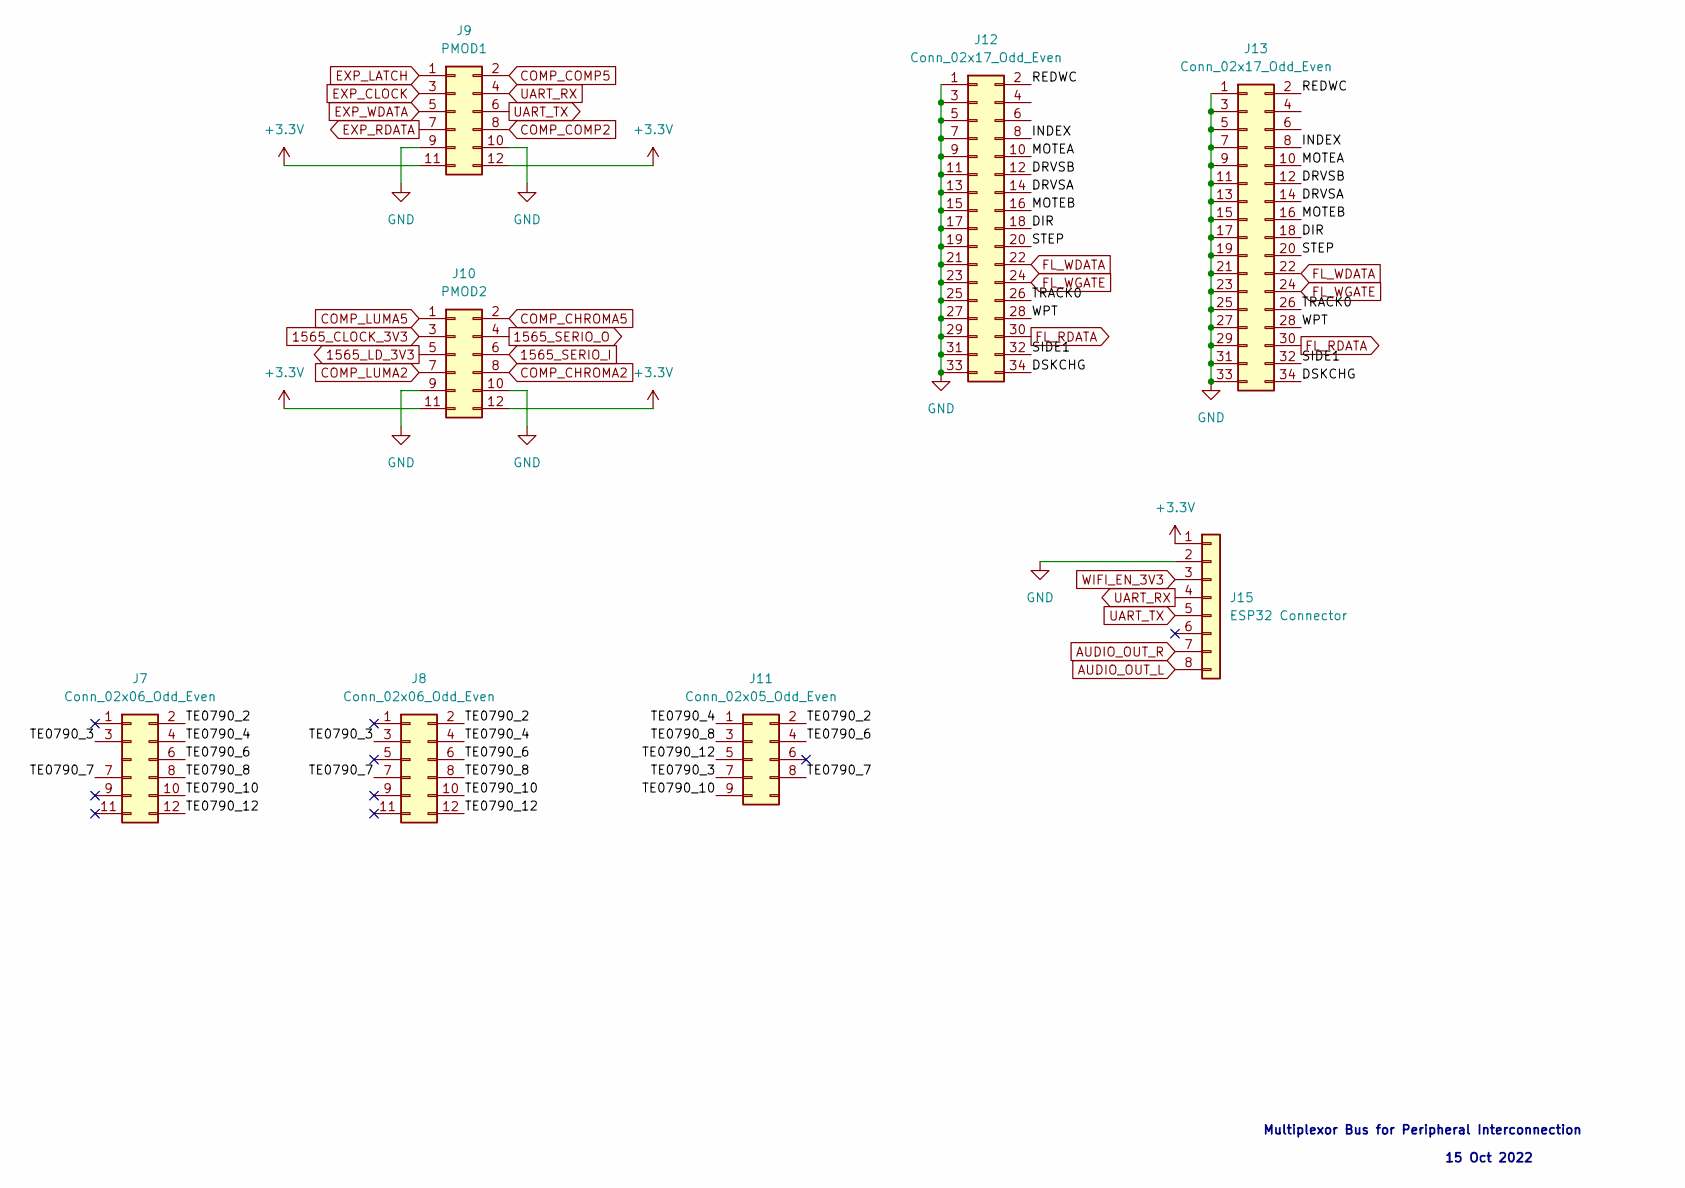
[picture p15: schematic multiplexorbus.kicad_sch]

Parts:
J7, J8: Conn_02x06_Odd_Even; PinHeader_2x06_P2.54mm_Vertical
J9: PMOD1; PinHeader_2x06_P2.54mm_Vertical
J10: PMOD2; PinHeader_2x06_P2.54mm_Vertical
J11: Conn_02x05_Odd_Even; PinHeader_2x05_P2.54mm_Vertical
J12, J13: Conn_02x17_Odd_Even; PinHeader_2x17_P2.54mm_Vertical
J15: ESP32 Connector; PinHeader_1x08_P2.54mm_Vertical

Connections:
1565_CLOCK_3V3: J10.3; also elsewhere on the board
1565_LD_3V3: J10.5; also elsewhere on the board
1565_SERIO_I: J10.6; also elsewhere on the board
1565_SERIO_O: J10.4; also elsewhere on the board
+3V3: J9.11, J9.12, J10.11, J10.12, J15.1; also elsewhere on the board
/Multiplexor Interconnect Bus/DIR: J12.18, J13.18
/Multiplexor Interconnect Bus/DRVSA: J12.14, J13.14
/Multiplexor Interconnect Bus/DRVSB: J12.12, J13.12
/Multiplexor Interconnect Bus/DSKCHG: J12.34, J13.34
/Multiplexor Interconnect Bus/INDEX: J12.8, J13.8
/Multiplexor Interconnect Bus/MOTEA: J12.10, J13.10
/Multiplexor Interconnect Bus/MOTEB: J12.16, J13.16
/Multiplexor Interconnect Bus/REDWC: J12.2, J13.2
/Multiplexor Interconnect Bus/SIDE1: J12.32, J13.32
/Multiplexor Interconnect Bus/STEP: J12.20, J13.20
/Multiplexor Interconnect Bus/TE0790_2: J7.2, J8.2, J11.2
/Multiplexor Interconnect Bus/TE0790_3: J7.3, J8.3, J11.7
/Multiplexor Interconnect Bus/TE0790_4: J7.4, J8.4, J11.1
/Multiplexor Interconnect Bus/TE0790_6: J7.6, J8.6, J11.4
/Multiplexor Interconnect Bus/TE0790_7: J7.7, J8.7, J11.8
/Multiplexor Interconnect Bus/TE0790_8: J7.8, J8.8, J11.3
/Multiplexor Interconnect Bus/TE0790_10: J7.10, J8.10, J11.9
/Multiplexor Interconnect Bus/TE0790_12: J7.12, J8.12, J11.5
/Multiplexor Interconnect Bus/TRACK0: J12.26, J13.26
/Multiplexor Interconnect Bus/WPT: J12.28, J13.28
AUDIO_OUT_L: J15.8; also elsewhere on the board
AUDIO_OUT_R: J15.7; also elsewhere on the board
COMP_CHROMA2: J10.8; also elsewhere on the board
COMP_CHROMA5: J10.2; also elsewhere on the board
COMP_COMP2: J9.8; also elsewhere on the board
COMP_COMP5: J9.2; also elsewhere on the board
COMP_LUMA2: J10.7; also elsewhere on the board
COMP_LUMA5: J10.1; also elsewhere on the board
EXP_CLOCK: J9.3; also elsewhere on the board
EXP_LATCH: J9.1; also elsewhere on the board
EXP_RDATA: J9.7; also elsewhere on the board
EXP_WDATA: J9.5; also elsewhere on the board
FL_RDATA: J12.30, J13.30; also elsewhere on the board
FL_WDATA: J12.22, J13.22; also elsewhere on the board
FL_WGATE: J12.24, J13.24; also elsewhere on the board
GND: J9.9, J9.10, J10.9, J10.10, J12.1, J12.3, J12.5, J12.7, J12.9, J12.11, J12.13, J12.15, J12.17, J12.19, J12.21, J12.23, J12.25, J12.27, J12.29, J12.31, J12.33, J13.1, J13.3, J13.5, J13.7, J13.9, J13.11, J13.13, J13.15, J13.17, J13.19, J13.21, J13.23, J13.25, J13.27, J13.29, J13.31, J13.33, J15.2; also elsewhere on the board
UART_RX: J9.4, J15.4
UART_TX: J9.6, J15.5
WIFI_EN_3V3: J15.3; also elsewhere on the board

Notes on the sheet:
Multiplexor Bus for Peripheral Interconnection
15 Oct 2022


Parts:
H1, H2, H3, H4, H5, H6, H7, H8, H9, H10, H11: MountingHole_Pad; MountingHole_3.2mm_M3_DIN965_Pad
J1, J2: Conn_01x04; FloppyPower
LOGO1: Logo_Open_Hardware_Large; OSHW-Logo2_14.6x12mm_SilkScreen

Connections:
+5V: J1.4, J2.4; also elsewhere on the board
+12V_FUSED: J1.1, J2.1; also elsewhere on the board
GND: H1.1, H2.1, H3.1, H4.1, H5.1, H6.1, H7.1, H8.1, H9.1, H10.1, J1.2, J1.3, J2.2, J2.3; also elsewhere on the board

Notes on the sheet:
Power supplies for MEGA65 R3/R3A/R4 Expansion Board
15 Oct 2022

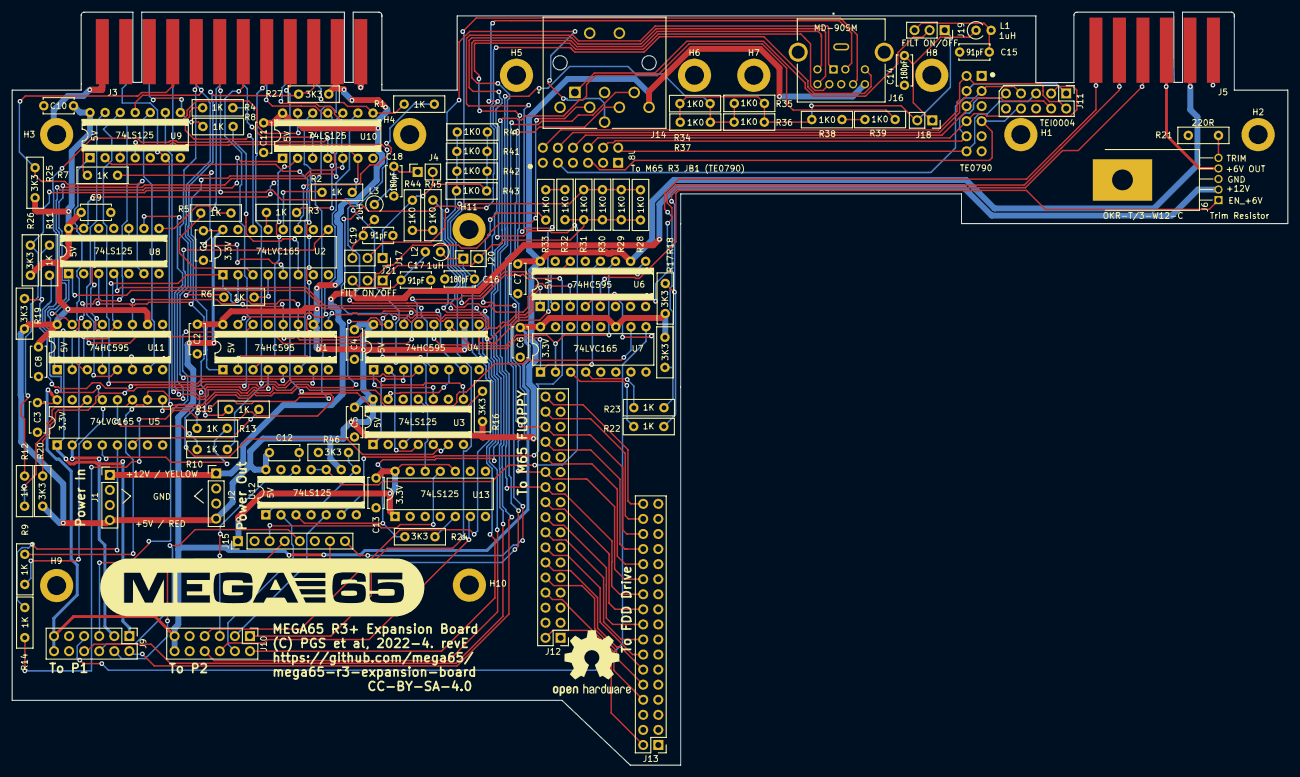
[picture p16: board mega65-r3-expansion-board.kicad.kicad_pcb from above]

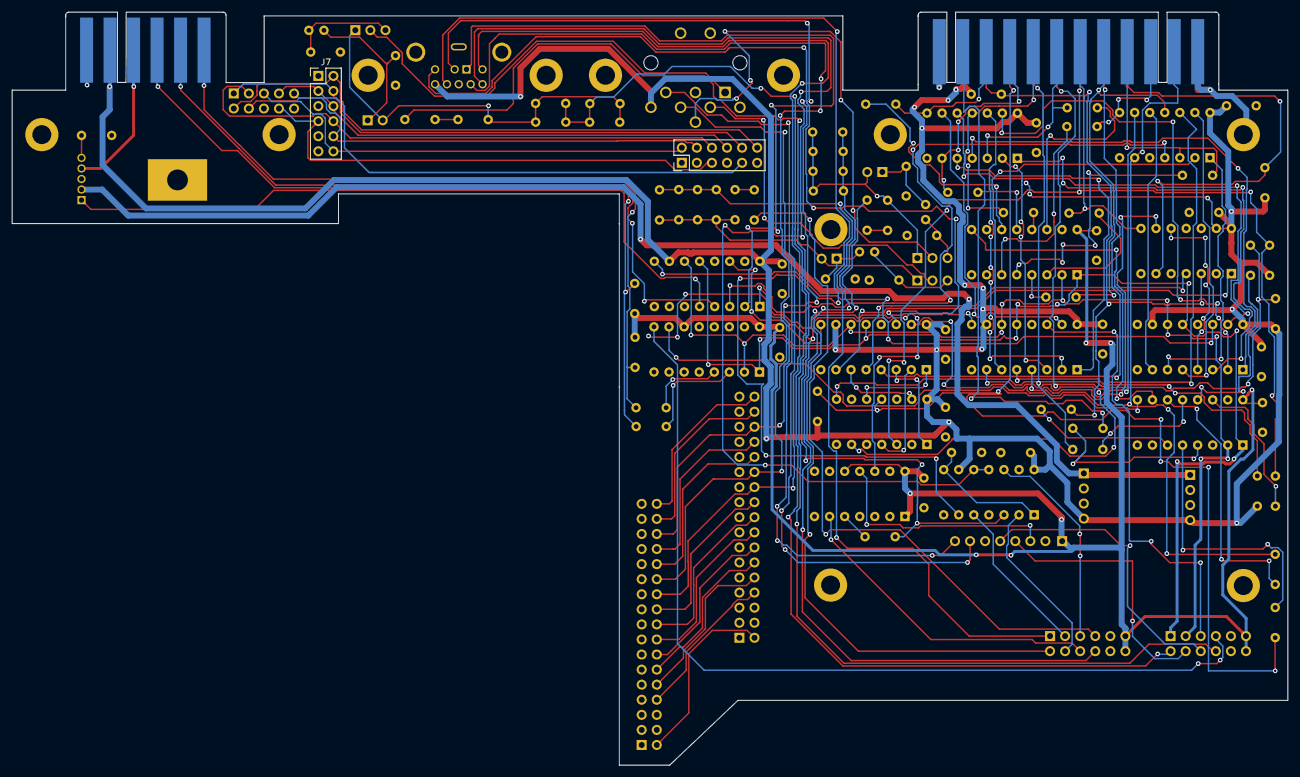
[picture p17: board mega65-r3-expansion-board.kicad.kicad_pcb from below]

Board: 4 copper layers, 215.0 x 126.9 mm, 114 parts (2 on the bottom side), 136 nets.
