MEGA65/mega65-r3-expansion-board/external_drive_board/external_drive_board.kicad_pcb

## KiCad design external_drive_board/external_drive_board.kicad_pcb (2024-03-29)

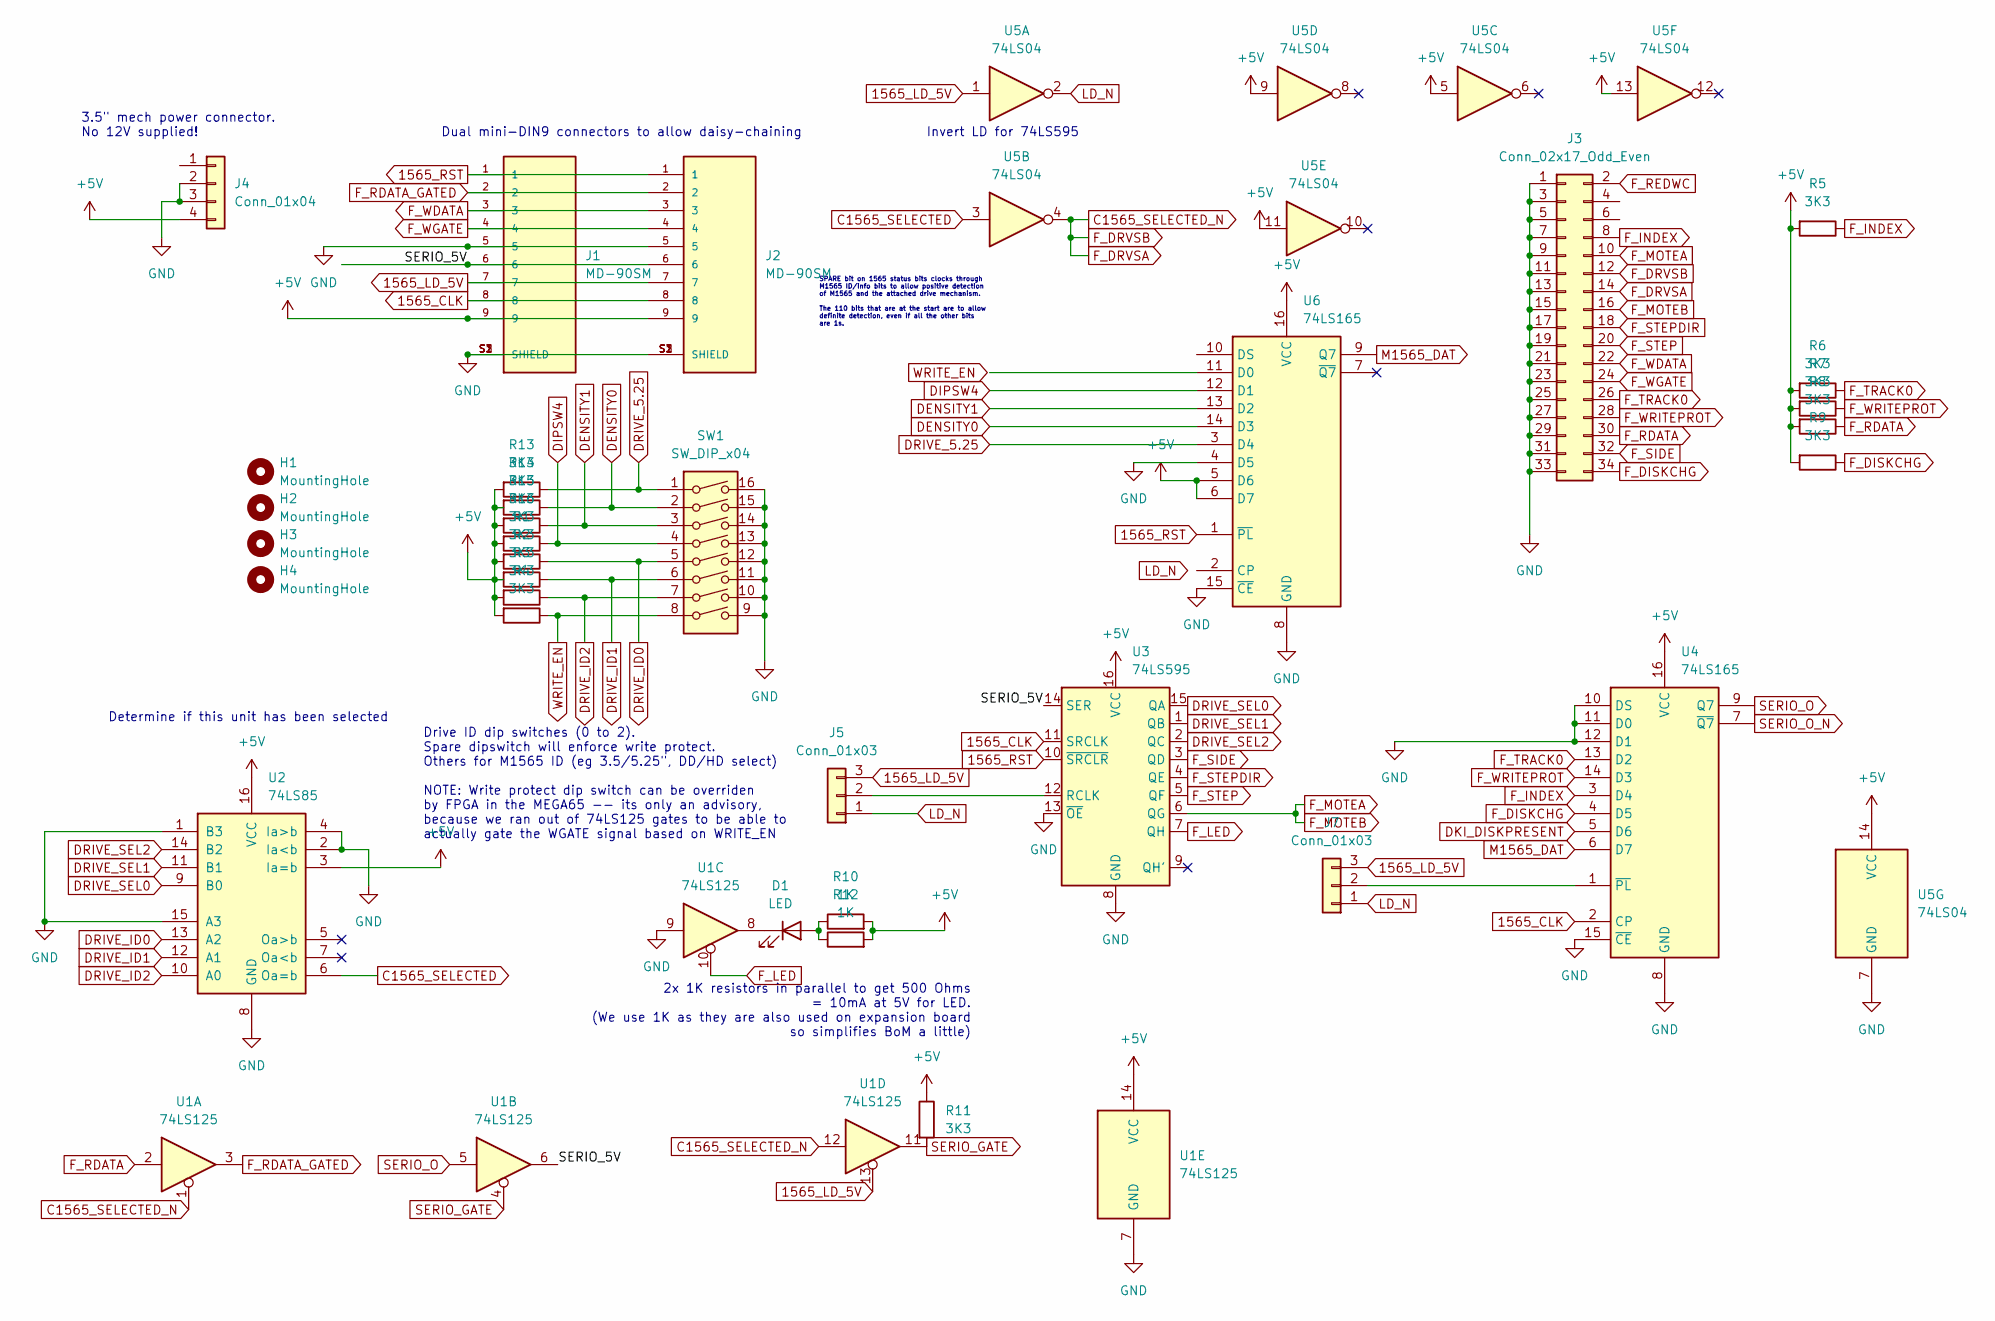
[picture p18: schematic external_drive_board.kicad_sch]

Parts:
D1: LED; LED_D5.0mm
H1, H2, H3, H4: MountingHole; MountingHole_3mm_Pad
J1, J2: MD-90SM; CUI_MD-90SM; PARTREV 02/18/2022
J3: Conn_02x17_Odd_Even; PinHeader_2x17_P2.54mm_Vertical
J4: Conn_01x04; PinHeader_1x04_P2.54mm_Vertical
J5, J7: Conn_01x03; PinHeader_1x03_P2.54mm_Vertical
R1, R2, R3, R4, R5, R6, R7, R8, R9, R11, R13, R14, R15, R16: 3K3; R_Axial_DIN0207_L6.3mm_D2.5mm_P7.62mm_Horizontal
R10, R12: 1K; R_Axial_DIN0207_L6.3mm_D2.5mm_P7.62mm_Horizontal
SW1: SW_DIP_x04; DIP-16_W7.62mm
U1: 74LS125; DIP-14_W7.62mm
U2: 74LS85; DIP-16_W7.62mm
U3: 74LS595; DIP-16_W7.62mm
U4, U6: 74LS165; DIP-16_W7.62mm
U5: 74LS04; DIP-14_W7.62mm

Connections:
1565_CLK: J1.8, J2.8, U3.11 (SRCLK), U4.2 (CP)
1565_LD_5V: J1.7, J2.7, J5.3, J7.3, U1.13, U5.1
1565_RST: J1.1, J2.1, U3.10 (~SRCLR), U6.1 (~PL)
+5V: J1.9, J2.9, J4.4, R1.2, R2.2, R3.2, R4.2, R5.2, R6.2, R7.2, R8.2, R9.2, R10.2, R11.1, R12.2, R13.2, R14.2, R15.2, R16.2, U1.14 (VCC), U2.3 (Ia=b), U2.16 (VCC), U3.16 (VCC), U4.16 (VCC), U5.5, U5.9, U5.11, U5.13, U5.14 (VCC), U6.5 (D6), U6.6 (D7), U6.16 (VCC)
/SERIO_5V: J1.6, J2.6, U1.6, U3.14 (SER)
C1565_SELECTED: U2.6 (Oa=b), U5.3
C1565_SELECTED_N: J3.12, J3.14, U1.1, U1.12, U5.4
DENSITY0: R14.1, SW1.2, U6.14 (D3)
DENSITY1: R15.1, SW1.3, U6.13 (D2)
DIPSW4: R16.1, SW1.4, U6.12 (D1)
DKI_DISKPRESENT: U4.5 (D6)
DRIVE_5.25: R13.1, SW1.1, U6.3 (D4)
DRIVE_ID0: R1.1, SW1.5, U2.13 (A2)
DRIVE_ID1: R2.1, SW1.6, U2.12 (A1)
DRIVE_ID2: R3.1, SW1.7, U2.10 (A0)
DRIVE_SEL0: U2.9 (B0), U3.15 (QA)
DRIVE_SEL1: U2.11 (B1), U3.1 (QB)
DRIVE_SEL2: U2.14 (B2), U3.2 (QC)
F_DISKCHG: J3.34, R9.1, U4.4 (D5)
F_INDEX: J3.8, R5.1, U4.3 (D4)
F_LED: U1.10, U3.7 (QH)
F_MOTEA: J3.10, J3.16, U3.6 (QG)
F_RDATA: J3.30, R8.1, U1.2
F_RDATA_GATED: J1.2, J2.2, U1.3
F_REDWC: J3.2
F_SIDE: J3.32, U3.3 (QD)
F_STEP: J3.20, U3.5 (QF)
F_STEPDIR: J3.18, U3.4 (QE)
F_TRACK0: J3.26, R6.1, U4.13 (D2)
F_WDATA: J1.3, J2.3, J3.22
F_WGATE: J1.4, J2.4, J3.24
F_WRITEPROT: J3.28, R7.1, U4.14 (D3)
GND: J1.5, J1.S1 (SHIELD), J1.S2 (SHIELD), J1.S3 (SHIELD), J2.5, J2.S1 (SHIELD), J2.S2 (SHIELD), J2.S3 (SHIELD), J3.1, J3.3, J3.5, J3.7, J3.9, J3.11, J3.13, J3.15, J3.17, J3.19, J3.21, J3.23, J3.25, J3.27, J3.29, J3.31, J3.33, J4.2, J4.3, SW1.9, SW1.10, SW1.11, SW1.12, SW1.13, SW1.14, SW1.15, SW1.16, U1.7 (GND), U1.9, U2.1 (B3), U2.2 (Ia<b), U2.4 (Ia>b), U2.8 (GND), U2.15 (A3), U3.8 (GND), U3.13 (~OE), U4.8 (GND), U4.10 (DS), U4.11 (D0), U4.12 (D1), U4.15 (~CE), U5.7 (GND), U6.4 (D5), U6.8 (GND), U6.15 (~CE)
LD_N: J5.1, J7.1, U5.2
M1565_DAT: U4.6 (D7), U6.9 (Q7)
unnamed: D1.2 (A), R10.1, R12.1
unnamed: D1.1 (K), U1.8
unnamed: J5.2, U3.12 (RCLK)
unnamed: J7.2, U4.1 (~PL)
SERIO_GATE: R11.2, U1.4, U1.11
SERIO_O: U1.5, U4.9 (Q7)
SERIO_O_N: U4.7 (~Q7)
WRITE_EN: R4.1, SW1.8

Notes on the sheet:
SPARE bit on 1565 status bits clocks through M1565 ID/info bits to allow positive detection of M1565 and the attached drive mechanism. The 110 bits that are at the start are to allow definite detection, even if all the other bits are 1s.
Invert LD for 74LS595
Determine if this unit has been selected
2x 1K resistors in parallel to get 500 Ohms = 10mA at 5V for LED. (We use 1K as they are also used on expansion board so simplifies BoM a little)
Dual mini-DIN9 connectors to allow daisy-chaining
Drive ID dip switches (0 to 2). Spare dipswitch will enforce write protect. Others for M1565 ID (eg 3.5/5.25", DD/HD select) NOTE: Write protect dip switch can be overriden by FPGA in the MEGA65 -- its only an advisory, because we ran out of 74LS125 gates to be able to actually gate the WGATE signa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
3.5" mech power connector. No 12V supplied!

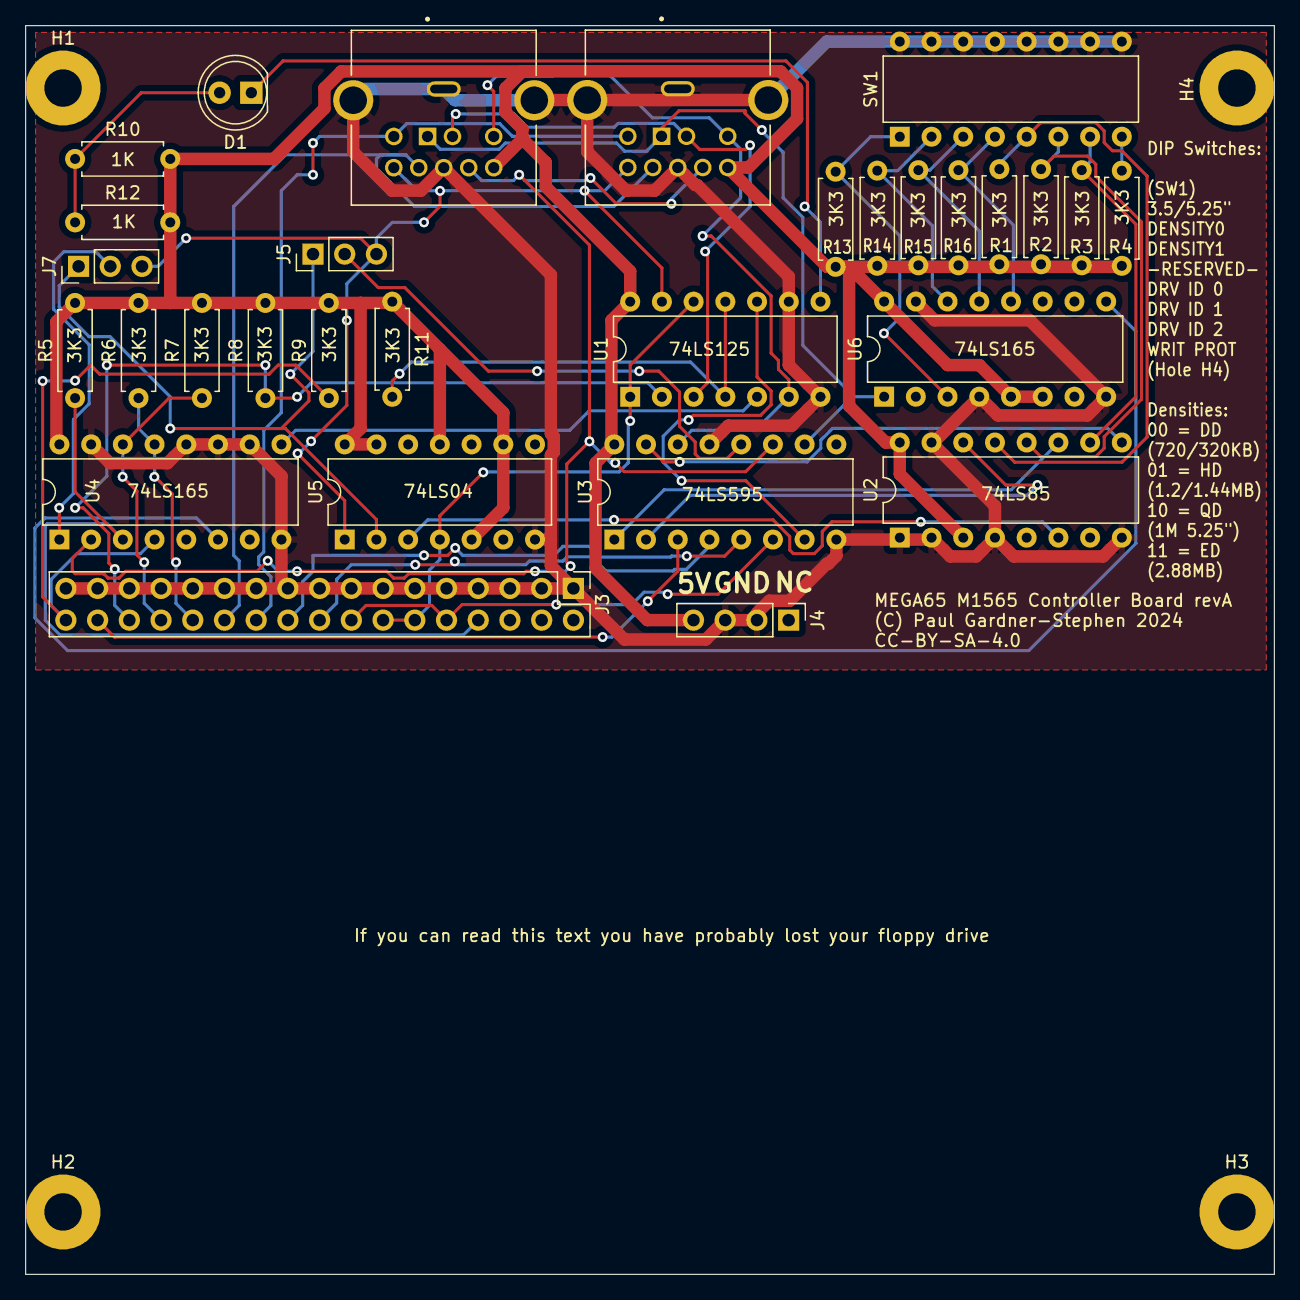
[picture p19: board external_drive_board.kicad_pcb from above]

Board: 2 copper layers, 100.0 x 100.0 mm, 34 parts (0 on the bottom side), 40 nets.
