MEGA65/mega65-r3-expansion-board/pmod_connector_board/pmod_connector_board.kicad_pcb

## KiCad design pmod_connector_board/pmod_connector_board.kicad_pcb (2024-01-23)

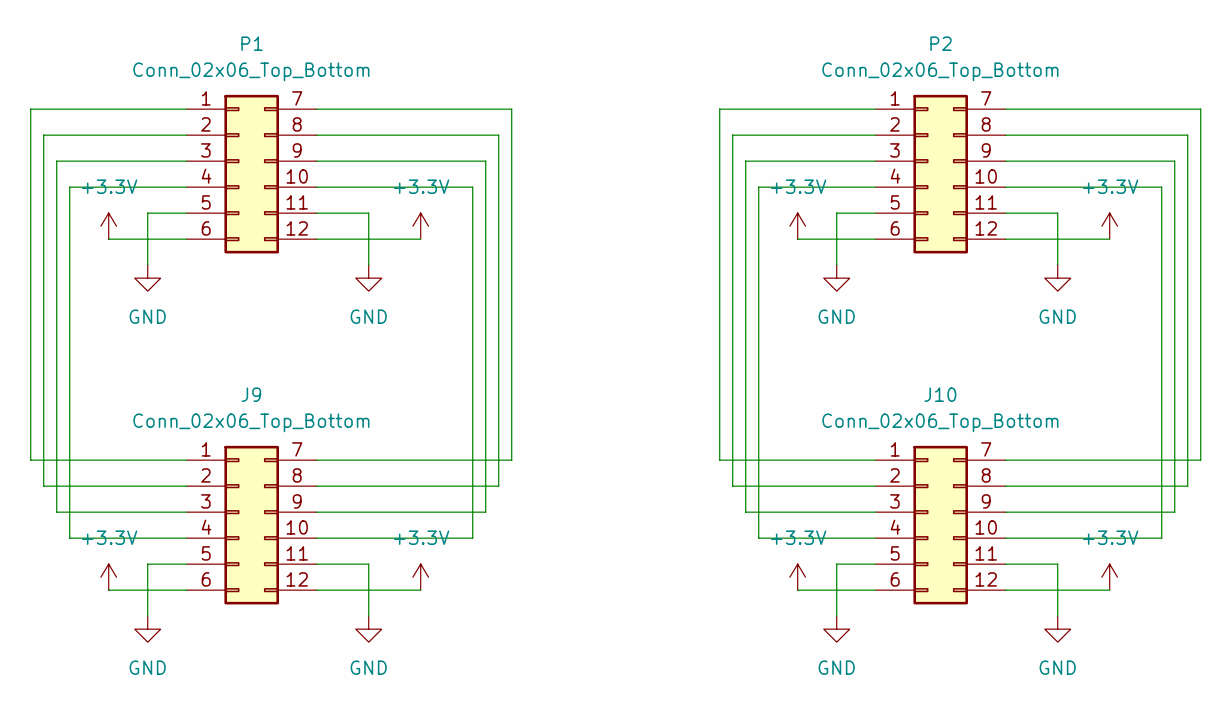
[picture p20: schematic pmod_connector_board.kicad_sch]

Parts:
J9, J10: Conn_02x06_Top_Bottom; PinHeader_2x06_P1.00mm_Vertical
P1, P2: Conn_02x06_Top_Bottom; PinHeader_2x06_P1.00mm_Vertical

Connections:
+3V3: J9.6, J9.12, J10.6, J10.12, P1.6, P1.12, P2.6, P2.12
GND: J9.5, J9.11, J10.5, J10.11, P1.5, P1.11, P2.5, P2.11
unnamed: J9.1, P1.1
unnamed: J9.2, P1.2
unnamed: J9.3, P1.3
unnamed: J9.4, P1.4
unnamed: J9.7, P1.7
unnamed: J9.8, P1.8
unnamed: J9.9, P1.9
unnamed: J9.10, P1.10
unnamed: J10.1, P2.1
unnamed: J10.2, P2.2
unnamed: J10.3, P2.3
unnamed: J10.4, P2.4
unnamed: J10.7, P2.7
unnamed: J10.8, P2.8
unnamed: J10.9, P2.9
unnamed: J10.10, P2.10
