MEGA65/mega65-r3-expansion-board/pmod_connector_board/pmod_connector_board.kicad_pcb

## KiCad design pmod_connector_board/pmod_connector_board.kicad_pcb (continued)

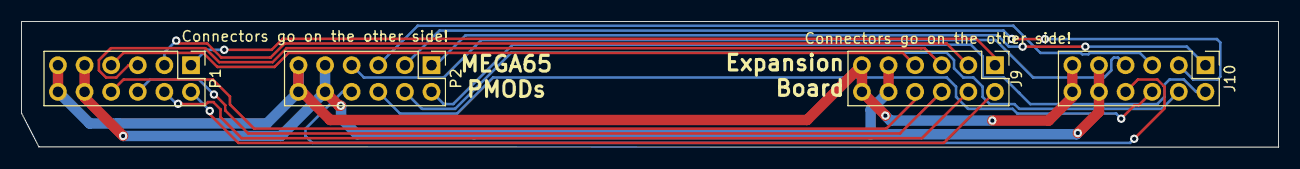
[picture p21: board pmod_connector_board.kicad_pcb from above]

Board: 2 copper layers, 120.0 x 12.0 mm, 4 parts (0 on the bottom side), 18 nets.
