MEGA65/mega65-r3-expansion-board/mega65cr-r1.kicad_pcb

## KiCad design mega65cr-r1.kicad_pcb (2022-10-17)

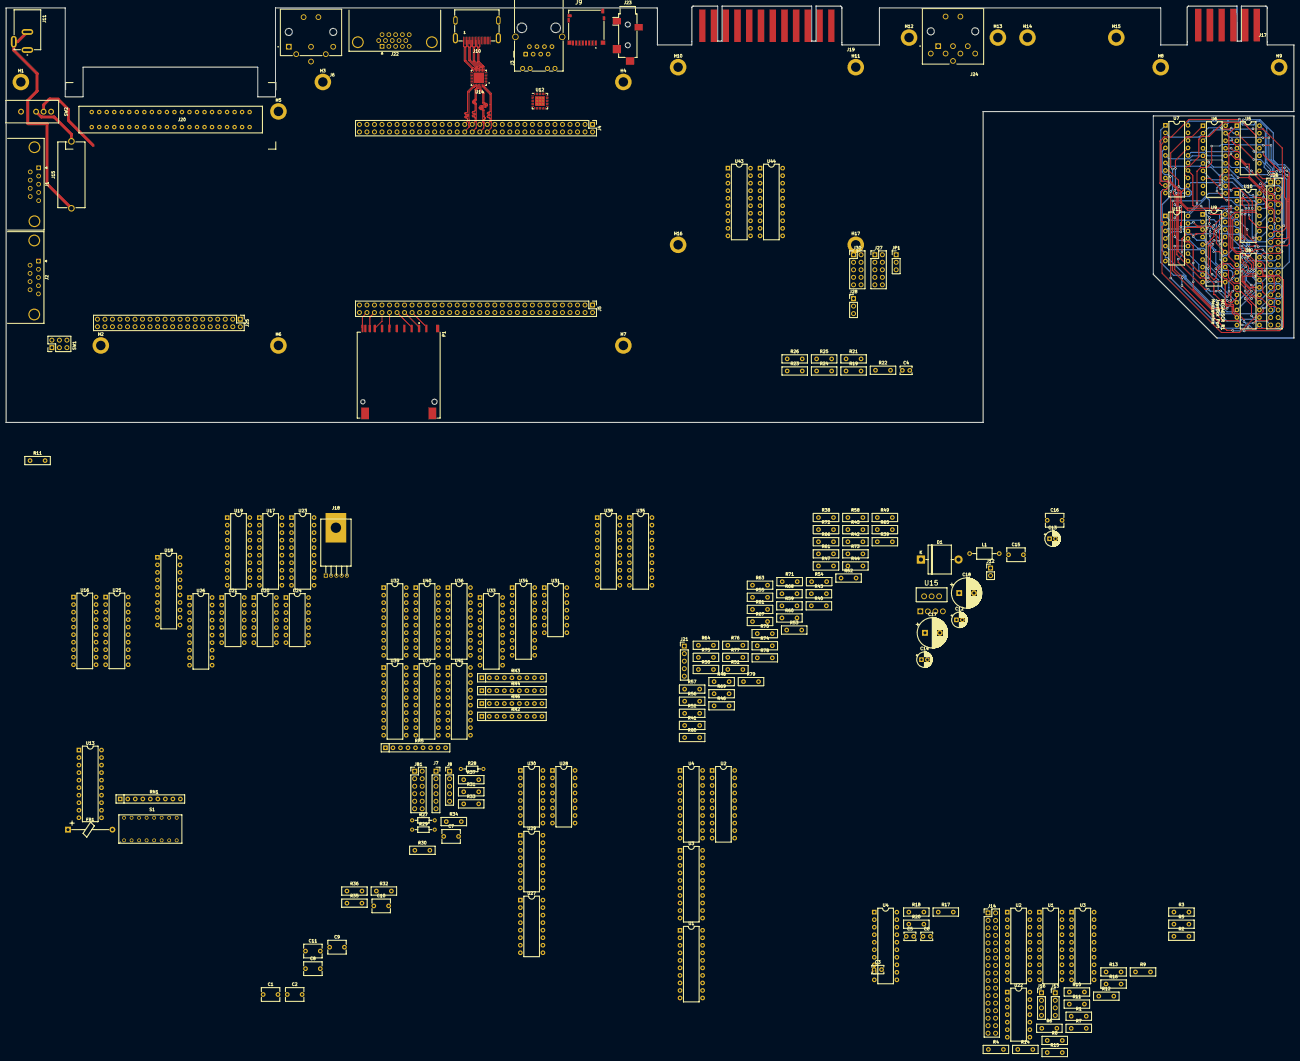
[picture p22: board mega65cr-r1.kicad_pcb from above]

Board: 4 copper layers, 435.0 x 140.6 mm, 208 parts (0 on the bottom side), 378 nets.

Parts:
C1, C7, C10, C11: 0.1uF; C_Disc_D6.0mm_W4.4mm_P5.00mm
C2: 0.01uF, eg K103Z15Y5VE5TH5; C_Disc_D6.0mm_W4.4mm_P5.00mm
C3, C4, C5, C6: 1.2nF; C_Disc_D3.8mm_W2.6mm_P2.50mm
C8: 1uF; C_Disc_D6.0mm_W4.4mm_P5.00mm
C9: 10uF; C_Disc_D6.0mm_W4.4mm_P5.00mm
C12, C13, C14: 15uF 50V; CP_Radial_D5.0mm_P2.00mm
C15: 0.47uF eg FG28X7R1H474KRT0; C_Disc_D6.0mm_W4.4mm_P5.00mm
C16: 100nF 50V; C_Disc_D6.0mm_W4.4mm_P5.00mm
C17, C18: 180uF 16V; CP_Radial_D10.0mm_P5.00mm
D1: 5V 40V 1N5825; D_5KP_P12.70mm_Horizontal
FB1: FerriteBead FT-3AMB4ARLY-PF; Ferrite_Bead_Axial_L10.0mm_D4.5mm_P15.00mm_Horizontal
H1, H2, H3, H4, H5, H6, H7, H8, H9, H10, H11, H12, H13, H14, H15, H16, H17: MountingHole_Pad; MountingHole_3.2mm_M3_DIN965_Pad
J1, J2: DB9_Male_MountingHoles; DSUB-9_Male_Horizontal_P2.77x2.84mm_EdgePinOffset7.70mm_Hou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
J3: Wuerth_7499010121A; RJ45_Wuerth_7499010121A_Horizontal
J4: QMTECH FPGA Module U4; PinHeader_2x32_P2.54mm_Vertical
J5: QMTECH FPGA Module U5; PinHeader_2x32_P2.54mm_Vertical
J6: SDF-60J for IEC 1541 serial port; CUI_SDF-60J
J7: QMTECH JTAG; PinSocket_1x06_P2.54mm_Vertical
J8: RTC; PinHeader_1x05_P2.54mm_Vertical
J9: 1140084168 microSD Card Slot; AMPHENOL_1140084168
J10: 685119134923
J11: CON-SOCJ-2155; GRAVITECH_CON-SOCJ-2155
J12: Header for power lead to QMTECH WUKONG FPGA board; PinHeader_1x02_P2.54mm_Vertical
J13, J16: Conn_01x04_Male; PinHeader_1x04_P2.54mm_Vertical
J14: Conn_02x17_Odd_Even; PinHeader_2x17_P2.54mm_Vertical
J15: 696101000002 Fuse Holder 20mm; 696101000002
J17: C64_Tape_Port; C64-Cassette-Port-Male
J18: BA60BC0WT; TO-220-FP-5
J19: C64_User_Port; C64-User-Port-Male
J20: C64_Expansion_Port; C64-Cart-Socket-Vertical
J21: Audio Header; PinHeader_1x05_P2.54mm_Vertical
J22: DB15_Female_HighDensity_MountingHoles; DSUB-15-HD_Female_Horizontal_P2.29x1.98mm_EdgePinOffset8.35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
J23: Audio Out; Jack_3.5mm_CUI_SJ-3524-SMT_Horizontal
J24: Component A/V; CUI_SDF-80J
J25: Joystick Ports Mezannine Lower; PinHeader_2x20_P2.54mm_Vertical
J26: Joystick Ports Mezannine Upper; PinHeader_2x20_P2.54mm_Vertical
J27: USB Blaster JTAG; PinHeader_2x05_P2.54mm_Vertical
J28: UART; PinHeader_1x03_P2.54mm_Vertical
J30: Keyboard JTAG header; PinHeader_2x05_P2.54mm_Vertical
JB1: TE0790-03 JTAG + UART; PinHeader_2x06_P2.54mm_Vertical
JP1: KBD JTAG EN; PinHeader_1x03_P2.54mm_Vertical
L1: 22uH, eg SC30R22KT; L_Axial_L5.0mm_D3.6mm_P10.00mm_Horizontal_Murata_BL01RN1A2A2
P1: Full-side CD Card Slot; YAMAICHI_FPS009-2405-0
R1, R2, R3, R4, R5, R6, R7, R8, R9, R10: 1K; R_Box_L8.4mm_W2.5mm_P5.08mm
R11, R11#2, R12, R13, R14, R15, R16, R17, R18, R19, R20, R21, R22, R23, R24, R25, R26, R30, R31, R32, R33, R34, R35, R37: 4K7; R_Box_L8.4mm_W2.5mm_P5.08mm
R27, R28: 220; R_Axial_DIN0204_L3.6mm_D1.6mm_P7.62mm_Horizontal
R29: 6.49K 1%; R_Axial_DIN0204_L3.6mm_D1.6mm_P7.62mm_Horizontal
R36: 12K4; R_Box_L8.4mm_W2.5mm_P5.08mm
R38, R44, R50, R56, R62, R68, R74: 510R; R_Box_L8.4mm_W2.5mm_P5.08mm
R39, R45, R51, R57, R63, R69, R75: 1K0; R_Box_L8.4mm_W2.5mm_P5.08mm
R40, R46, R52, R58, R64, R70, R76: 2K0; R_Box_L8.4mm_W2.5mm_P5.08mm
R41, R47, R53, R59, R65, R71, R77: 4K0; R_Box_L8.4mm_W2.5mm_P5.08mm
R42, R48, R54, R60, R66, R72, R78: 8K0; R_Box_L8.4mm_W2.5mm_P5.08mm
R43, R49, R55, R61, R67, R73, R79: 16K0; R_Box_L8.4mm_W2.5mm_P5.08mm
R80, R81: 49R9; R_Box_L8.4mm_W2.5mm_P5.08mm
RN1, RN3, RN4, RN5, RN6: 3.3K x 8; R_Array_SIP9
RN2: 4609X-AP1-332LF 3.3Kx8; R_Array_SIP9
S1: 418117270908
SW1: Reset Button; SPUJ191500
SW2: SW_SPDT_with_shield; T103J1AVBE2
U1, U1#2, U4, U4#2, U9: 74LS373; DIP-20_W7.62mm
U2, U2#2, U3, U3#2, U6, U7, U13, U16, U17, U23, U32, U33, U34, U38, U39, U43: 74LVC374; DIP-20_W7.62mm
U5, U10, U11, U22: 74LS06N; DIP-14_W7.62mm
U8, U18, U19, U25, U26, U35, U36, U37, U40, U41, U44: 74LS374; DIP-20_W7.62mm
U12: DP83826; QFN-32-1EP_5x5mm_P0.5mm_EP3.3x3.3mm_ThermalVias
U14: PTN3363BSMP; QFN50P500X500X85-33N
U15: LM2678T-5.0; TO127P457X1016X2052-7P
U20, U21, U24: 74LS125; DIP-14_W7.62mm
U27, U28: 74LS138; DIP-16_W7.62mm
U29, U30: 74LS137; DIP-16_W7.62mm
U31: 74LS04; DIP-14_W7.62mm

Connections:
+3V3: FB1.1, J4.3, J4.4, J8.1, J25.2, J26.2, J27.4, J30.4, JB1.6, JP1.1 (A), P1.4 (VDD), R27.1, R28.1, R30.2, R31.2, RN1.1 (common), U2.20 (VCC), U2#2.20 (VCC), U3.20 (VCC), U3#2.20 (VCC), U6.20 (VCC), U7.20 (VCC), U13.20 (VCC), U16.20 (VCC), U17.20 (VCC), U23.20 (VCC), U29.16 (VCC), U32.20 (VCC), U33.20 (VCC), U34.20 (VCC), U38.20 (VCC), U39.20 (VCC), U43.20 (VCC)
+5V: C17.1, C18.1, J1.7, J2.7, J10.18 (+5VPOWER), J13.4, J16.4, J17.2, J17.B, J19.2, J20.2, J20.3, J21.3, J24.8, J25.1, J26.1, L1.2, R11.2, R11#2.2, R17.1, R18.1, R19.1, R20.1, R21.1, R22.1, R23.1, R24.1, R25.1, R26.1, RN2.1 (common), RN3.1 (common), RN4.1 (common), RN5.1 (common), RN6.1 (common), U1.20 (VCC), U1#2.20 (VCC), U4.20 (VCC), U4#2.20 (VCC), U5.14 (VCC), U8.20 (VCC), U9.20 (VCC), U10.14 (VCC), U11.14 (VCC), U14.1 (VDD), U14.18 (VDD), U15.6 (FB), U18.20 (VCC), U19.20 (VCC), U22.14 (VCC), U25.20 (VCC), U26.20 (VCC), U27.6 (E3), U27.16 (VCC), U28.16 (VCC), U29.6 (E3), U31.14 (VCC), U35.20 (VCC), U36.20 (VCC), U37.20 (VCC), U40.20 (VCC), U41.20 (VCC), U44.20 (VCC)
+12V_FUSED: C12.1, C13.1, C14.1, C15.1, J13.1, J16.1, J18.2, SW2.2 (B), U15.2 (VIN), U15.7 (SS)
/Cartridge Port/A0: J20.Y, RN6.9 (R8), U34.3 (D0), U37.19 (O7)
/Cartridge Port/A1: J20.X, RN6.8 (R7), U34.4 (D1), U37.16 (O6)
/Cartridge Port/A2: J20.W, RN6.7 (R6), U34.7 (D2), U37.15 (O5)
/Cartridge Port/A3: J20.V, RN6.6 (R5), U34.8 (D3), U37.12 (O4)
/Cartridge Port/A4: J20.U, RN6.5 (R4), U34.13 (D4), U37.9 (O3)
/Cartridge Port/A5: J20.T, RN6.4 (R3), U34.14 (D5), U37.6 (O2)
/Cartridge Port/A6: J20.S, RN6.3 (R2), U34.17 (D6), U37.5 (O1)
/Cartridge Port/A7: J20.R, RN6.2 (R1), U34.18 (D7), U37.2 (O0)
/Cartridge Port/A8: J20.P, RN5.9 (R8), U39.3 (D0), U41.19 (O7)
/Cartridge Port/A9: J20.N, RN5.8 (R7), U39.4 (D1), U41.16 (O6)
/Cartridge Port/A10: J20.M, RN5.7 (R6), U39.7 (D2), U41.15 (O5)
/Cartridge Port/A11: J20.L, RN5.6 (R5), U39.8 (D3), U41.12 (O4)
/Cartridge Port/A12: J20.K, RN5.5 (R4), U39.13 (D4), U41.9 (O3)
/Cartridge Port/A13: J20.J, RN5.4 (R3), U39.14 (D5), U41.6 (O2)
/Cartridge Port/A14: J20.H, RN5.3 (R2), U39.17 (D6), U41.5 (O1)
/Cartridge Port/A15: J20.F, RN5.2 (R1), U39.18 (D7), U41.2 (O0)
/Cartridge Port/BA: J20.12, U32.18 (D7), U35.19 (O7)
/Cartridge Port/D0: J20.21, RN3.2 (R1), U33.3 (D0), U36.2 (O0)
/Cartridge Port/D1: J20.20, RN3.3 (R2), U33.4 (D1), U36.5 (O1)
/Cartridge Port/D2: J20.19, RN3.4 (R3), U33.7 (D2), U36.6 (O2)
/Cartridge Port/D3: J20.18, RN3.5 (R4), U33.8 (D3), U36.9 (O3)
/Cartridge Port/D4: J20.17, RN3.6 (R5), U33.13 (D4), U36.12 (O4)
/Cartridge Port/D5: J20.16, RN3.7 (R6), U33.14 (D5), U36.15 (O5)
/Cartridge Port/D6: J20.15, RN3.8 (R7), U33.17 (D6), U36.16 (O6)
/Cartridge Port/D7: J20.14, RN3.9 (R8), U33.18 (D7), U36.19 (O7)
/Cartridge Port/DMA_N: J20.13, RN4.5 (R4), U32.13 (D4)
/Cartridge Port/DOTCLOCK: J20.6, U31.2, U38.7 (D2)
/Cartridge Port/EXROM_N: J20.9, RN2.4 (R3), U38.14 (D5), U40.15 (O5)
/Cartridge Port/GAME_N: J20.8, RN2.5 (R4), U38.13 (D4), U40.12 (O4)
/Cartridge Port/IO1_N: J20.7, RN2.6 (R5), U38.8 (D3), U40.9 (O3)
/Cartridge Port/IO2_N: J20.10, RN2.3 (R2), U38.17 (D6), U40.16 (O6)
/Cartridge Port/IRQ_N: J20.4, RN2.9 (R8), RN4.8 (R7), U32.4 (D1)
/Cartridge Port/PHI2: J20.E, U38.18 (D7), U40.19 (O7)
/Cartridge Port/RESET_N: J20.C, RN4.9 (R8), U32.3 (D0)
/Cartridge Port/ROMH_N: J20.B, U32.17 (D6), U35.16 (O6)
/Cartridge Port/ROML_N: J20.11, RN2.2 (R1), U32.14 (D5), U35.15 (O5)
/Cartridge Port/R_W: J20.5, RN2.8 (R7), RN4.6 (R5), U32.8 (D3)
/FPGA Module/VCCO_12_13: J5.3, J5.4
/FPGA Module/VIN: J4.63, J4.64, J5.63, J5.64
/IEC & 3.5" Drives/DIR: J14.18, U1.9 (O3), U1#2.9 (O3)
/IEC & 3.5" Drives/DISKCHG: J14.34, R10.1, R15.1
/IEC & 3.5" Drives/DRVSA: J14.14, U1.6 (O2), U1#2.6 (O2)
/IEC & 3.5" Drives/DRVSB: J14.12, U4.15 (O5), U4#2.15 (O5)
/IEC & 3.5" Drives/INDEX: J14.8, R6.1, R12.2
/IEC & 3.5" Drives/MOTEA: J14.10, U1.5 (O1), U1#2.5 (O1)
/IEC & 3.5" Drives/RDATA: J14.30, R9.1, R16.1
/IEC & 3.5" Drives/REDWC: J14.2, U1.2 (O0), U1#2.2 (O0)
/IEC & 3.5" Drives/SER_ATN_OUT: U4.12 (O4), U4#2.12 (O4), U22.9
/IEC & 3.5" Drives/SER_CLK: J6.4, R3.1, U22.4
/IEC & 3.5" Drives/SER_CLK_OUT: U4.6 (O2), U4#2.6 (O2), U22.3
/IEC & 3.5" Drives/SER_DATA: J6.5, R4.1, U22.12
/IEC & 3.5" Drives/SER_DATA_OUT: U4.9 (O3), U4#2.9 (O3), U22.13
/IEC & 3.5" Drives/SER_RESET: J6.6, R1.1, U22.6
/IEC & 3.5" Drives/SER_RESET_OUT: U4.2 (O0), U4#2.2 (O0), U22.5
/IEC & 3.5" Drives/SER_SEQ_OUT: U4.5 (O1), U4#2.5 (O1)
/IEC & 3.5" Drives/SER_SRQ: J6.1, R2.1, U22.10
/IEC & 3.5" Drives/SIDE1: J14.32, U1.19 (O7), U1#2.19 (O7)
/IEC & 3.5" Drives/STEP: J14.20, U1.12 (O4), U1#2.12 (O4)
/IEC & 3.5" Drives/TRCK0: J14.26, R7.1, R13.1
/IEC & 3.5" Drives/WDATA: J14.22, U1.15 (O5), U1#2.15 (O5)
/IEC & 3.5" Drives/WGATE: J14.24, U1.16 (O6), U1#2.16 (O6)
/IEC & 3.5" Drives/WPROT: J14.28, R8.1, R14.1
/Joystick Ports/JA_AX: C3.2, J1.9, J25.15
/Joystick Ports/JA_AY: C5.2, J1.5, J25.17
/Joystick Ports/JA_DOWN: J1.2, J25.9, R19.2
/Joystick Ports/JA_FIRE: J1.6, J25.7, R20.2
/Joystick Ports/JA_LEFT: J1.3, J25.11, R18.2
/Joystick Ports/JA_RIGHT: J1.4, J25.13, R17.2
/Joystick Ports/JA_UP: J1.1, J25.5, R21.2
/Joystick Ports/JB_AX: C4.2, J2.9, J25.31
/Joystick Ports/JB_AY: C6.2, J2.5, J25.33
/Joystick Ports/JB_DOWN: J2.2, J25.25, R24.2
/Joystick Ports/JB_FIRE: J2.6, J25.23, R25.2
/Joystick Ports/JB_LEFT: J2.3, J25.27, R23.2
/Joystick Ports/JB_RIGHT: J2.4, J25.29, R22.2
/Joystick Ports/JB_UP: J2.1, J25.21, R26.2
/Joystick Ports/M_JA_AX: J26.15, U5.4, U6.4 (D1)
/Joystick Ports/M_JA_AY: J26.17, U5.2, U6.3 (D0)
/Joystick Ports/M_JA_DOWN: J26.9, U6.13 (D4), U10.10
/Joystick Ports/M_JA_FIRE: J26.7, U6.14 (D5), U10.12
/Joystick Ports/M_JA_LEFT: J26.11, U6.8 (D3), U10.8
/Joystick Ports/M_JA_RIGHT: J26.13, U6.7 (D2), U10.6
/Joystick Ports/M_JA_UP: J26.5, U6.17 (D6), U10.2
/Joystick Ports/M_JB_AX: J26.31, U7.4 (D1), U10.4
/Joystick Ports/M_JB_AY: J26.33, U7.3 (D0), U11.2
/Joystick Ports/M_JB_DOWN: J26.25, U7.13 (D4), U11.10
/Joystick Ports/M_JB_FIRE: J26.23, U7.14 (D5), U11.12
/Joystick Ports/M_JB_LEFT: J26.27, U7.8 (D3), U11.8
/Joystick Ports/M_JB_RIGHT: J26.29, U7.7 (D2), U11.6
/Joystick Ports/M_JB_UP: J26.21, U7.17 (D6), U11.4
/Joystick Ports/M_MUX_DI0: J26.6, U6.2 (O0), U7.2 (O0)
/Joystick Ports/M_MUX_DI1: J26.8, U6.5 (O1), U7.5 (O1)
/Joystick Ports/M_MUX_DI2: J26.10, U6.6 (O2), U7.6 (O2)
/Joystick Ports/M_MUX_DI3: J26.12, U7.9 (O3)
/Joystick Ports/M_MUX_DI4: J26.20, U6.12 (O4), U7.12 (O4)
/Joystick Ports/M_MUX_DI5: J26.18, U6.15 (O5), U7.15 (O5)
/Joystick Ports/M_MUX_DI6: J26.16, U6.16 (O6), U7.16 (O6)
/Joystick Ports/M_MUX_DI7: J26.14, U6.19 (O7)
/Joystick Ports/M_MUX_DO0: J26.22, U8.3 (D0), U9.3 (D0)
/Joystick Ports/M_MUX_DO1: J26.24, U8.4 (D1), U9.4 (D1)
/Joystick Ports/M_MUX_DO2: J26.26, U8.7 (D2), U9.7 (D2)
/Joystick Ports/M_MUX_DO3: J26.28, U8.8 (D3), U9.8 (D3)
/Joystick Ports/M_MUX_DO4: J26.30, U8.14 (D5), U9.13 (D4)
/Joystick Ports/M_MUX_DO5: J26.32, U8.13 (D4), U9.14 (D5)
/Joystick Ports/M_MUX_DO6: J26.34, U8.17 (D6), U9.17 (D6)
/Joystick Ports/M_MUX_DO7: J26.36, U8.18 (D7), U9.18 (D7)
/Joystick Ports/M_MUX_SEL_2: J26.38, U6.11 (Cp), U8.11 (Cp)
/Joystick Ports/M_MUX_SEL_2_N: J26.40, U6.1 (OE)
/Joystick Ports/M_MUX_SEL_3: J26.37, U7.11 (Cp), U9.11 (LE)
/Joystick Ports/M_MUX_SEL_3_N: J26.39, U7.1 (OE)
/Joystick Ports/M_RESET_BTN: J26.19, U6.18 (D7)
/Joystick Ports/RESET_BTN: J25.19, R11.1, R11#2.1, SW1.3 (C), SW1.6 (C)
/MEGA65 Peripherals, DVI, Eth, microSD/CK+: J10.10 (TMDSCLOCK+), U14.10 (OUT_D4-)
/MEGA65 Peripherals, DVI, Eth, microSD/CK-: J10.12 (TMDSCLOCK-), U14.9 (OUT_D4+)
/MEGA65 Peripherals, DVI, Eth, microSD/D0+: J10.7 (TMDSDATA0+), U14.12 (OUT_D3-)
/MEGA65 Peripherals, DVI, Eth, microSD/D0-: J10.9 (TMDSDATA0-), U14.11 (OUT_D3+)
/MEGA65 Peripherals, DVI, Eth, microSD/D1+: J10.4 (TMDSDATA1+), U14.14 (OUT_D2-)
/MEGA65 Peripherals, DVI, Eth, microSD/D1-: J10.6 (TMDSDATA1-), U14.13 (OUT_D2+)
/MEGA65 Peripherals, DVI, Eth, microSD/D2+: J10.1 (TMDSDATA2+), U14.16 (OUT_D1-)
/MEGA65 Peripherals, DVI, Eth, microSD/D2-: J10.3 (TMDSDATA2-), U14.15 (OUT_D1+)
/MEGA65 Peripherals, DVI, Eth, microSD/DIP1: RN1.2 (R1), S1.A1, U13.3 (D0)
/MEGA65 Peripherals, DVI, Eth, microSD/DIP2: RN1.3 (R2), S1.A2, U13.4 (D1)
/MEGA65 Peripherals, DVI, Eth, microSD/DIP3: RN1.4 (R3), S1.A3, U13.7 (D2)
/MEGA65 Peripherals, DVI, Eth, microSD/DIP4: RN1.5 (R4), S1.A4, U13.8 (D3)
/MEGA65 Peripherals, DVI, Eth, microSD/DIP5: RN1.6 (R5), S1.A5, U13.13 (D4)
/MEGA65 Peripherals, DVI, Eth, microSD/DIP6: RN1.7 (R6), S1.A6, U13.14 (D5)
/MEGA65 Peripherals, DVI, Eth, microSD/DIP7: RN1.8 (R7), S1.A7, U13.17 (D6)
/MEGA65 Peripherals, DVI, Eth, microSD/DIP8: RN1.9 (R8), S1.A8, U13.18 (D7)
/MEGA65 Peripherals, DVI, Eth, microSD/ETH_RX_N: J3.6 (RD-), U12.4 (RXN)
/MEGA65 Peripherals, DVI, Eth, microSD/ETH_RX_P: J3.4 (RD+), U12.5 (RXP)
/MEGA65 Peripherals, DVI, Eth, microSD/ETH_TX_N: J3.3 (TD-), U12.6 (TXN)
/MEGA65 Peripherals, DVI, Eth, microSD/ETH_TX_P: J3.1 (TD+), U12.7 (TXP)
/MEGA65 Peripherals, DVI, Eth, microSD/HPD_B: J10.19 (HOTPLUGDETECT/HEAC-), U14.21 (HPD_B)
/MEGA65 Peripherals, DVI, Eth, microSD/SCL_B: J10.15 (SCL), U14.19 (SCL_SINK)
/MEGA65 Peripherals, DVI, Eth, microSD/SDA_B: J10.16 (SDA), U14.20 (SDA_SINK)
/Power Supply & Mounting Holes/VBAT: J11.2, J11.3, J15.1
/User Port/6V_REG_CTL: J18.1, U17.7 (D2), U19.6 (O2)
/User Port/CNT1: J19.4, U16.7 (D2), U18.6 (O2)
/User Port/CNT2: J19.6, U16.13 (D4), U18.12 (O4)
/User Port/DATA_0: J19.C, U21.3, U23.3 (D0)
/User Port/DATA_0_O: U21.2, U26.2 (O0)
/User Port/DATA_1: J19.D, U21.6, U23.4 (D1)
/User Port/DATA_1_O: U21.5, U26.5 (O1)
/User Port/DATA_2: J19.E, U21.8, U23.7 (D2)
/User Port/DATA_2_O: U21.9, U26.6 (O2)
/User Port/DATA_3: J19.F, U21.11, U23.8 (D3)
/User Port/DATA_3_O: U21.12, U26.9 (O3)
/User Port/DATA_4: J19.H, U23.13 (D4), U24.3
/User Port/DATA_4_O: U24.2, U26.12 (O4)
/User Port/DATA_5: J19.J, U23.14 (D5), U24.6
/User Port/DATA_5_O: U24.5, U26.15 (O5)
/User Port/DATA_6: J19.K, U23.17 (D6), U24.8
/User Port/DATA_6_O: U24.9, U26.16 (O6)
/User Port/DATA_7: J19.L, U23.18 (D7), U24.11
/User Port/DATA_7_O: U24.12, U26.19 (O7)
/User Port/EN_DATA_0: U21.1, U25.2 (O0)
/User Port/EN_DATA_1: U21.4, U25.5 (O1)
/User Port/EN_DATA_2: U21.10, U25.6 (O2)
/User Port/EN_DATA_3: U21.13, U25.9 (O3)
/User Port/EN_DATA_4: U24.1, U25.12 (O4)
/User Port/EN_DATA_5: U24.4, U25.15 (O5)
/User Port/EN_DATA_6: U24.10, U25.16 (O6)
/User Port/EN_DATA_7: U24.13, U25.19 (O7)
/User Port/EN_PA2: U19.19 (O7), U20.4
/User Port/EN_RESET_N: U18.5 (O1), U20.1
/User Port/FLAG2: J19.B, U16.18 (D7), U18.19 (O7)
/User Port/PA2: J19.M, U17.17 (D6), U20.6
/User Port/PA2_O: U19.16 (O6), U20.5
/User Port/PC2: J19.8, U16.17 (D6), U18.16 (O6)
/User Port/RESET_N: J19.3, U16.3 (D0), U20.3
/User Port/RESET_N_O: U18.2 (O0), U20.2
/User Port/SP1: J19.5, U16.8 (D3), U18.9 (O3)
/User Port/SP2: J19.7, U16.14 (D5), U18.15 (O5)
/User Port/TAPE_READ: J17.4, J17.D, U17.3 (D0)
/User Port/TAPE_SENSE: J17.6, J17.F, U17.4 (D1)
/User Port/TAPE_WRITE: J17.5, J17.E, U19.9 (O3)
/VGA, C64 AV & C64 Keyboard/COMP_CHROMA: J24.6, R56.2, R57.2, R58.2, R59.2, R60.2
/VGA, C64 AV & C64 Keyboard/COMP_LUMA: J24.1, J24.4, R50.2, R51.2, R52.2, R53.2, R54.2
/VGA, C64 AV & C64 Keyboard/VGA_B: J22.3, R74.2, R75.2, R76.2, R77.2, R78.2
/VGA, C64 AV & C64 Keyboard/VGA_G: J22.2, R68.2, R69.2, R70.2, R71.2, R72.2
/VGA, C64 AV & C64 Keyboard/VGA_R: J22.1, R62.2, R63.2, R64.2, R65.2, R66.2
AUDIO_L: J21.2, J23.T, J24.3, R38.2, R39.2, R40.2, R41.2, R42.2
AUDIO_L0: J5.29, R43.1
AUDIO_L1: J5.27, R42.1
AUDIO_L2: J5.25, R41.1
AUDIO_L3: J5.23, R40.1
AUDIO_L4: J5.21, R39.1
AUDIO_L5: J5.19, R38.1
AUDIO_R: J21.4, J23.R, R44.2, R45.2, R46.2, R47.2, R48.2
AUDIO_R0: J5.17, R49.1
AUDIO_R1: J5.15, R48.1
AUDIO_R2: J5.13, R47.1
AUDIO_R3: J5.11, R46.1
AUDIO_R4: J5.9, R45.1
AUDIO_R5: J5.7, R44.1
COMP_CHROMA0: J5.18, R61.1
COMP_CHROMA1: J5.16, R60.1
COMP_CHROMA2: J5.14, R59.1
COMP_CHROMA3: J5.12, R58.1
COMP_CHROMA4: J5.10, R57.1
COMP_CHROMA5: J5.8, R56.1
COMP_LUMA0: J5.30, R55.1
COMP_LUMA1: J5.28, R54.1
COMP_LUMA2: J5.26, R53.1
COMP_LUMA3: J5.24, R52.1
COMP_LUMA4: J5.22, R51.1
COMP_LUMA5: J5.20, R50.1
DOTCLOCK_O: J4.60, U31.1
ETH_CLKIN: J4.24, U12.9 (XI/CLKIN)
ETH_COL_DETECT: J4.18, U12.28 (COL/~MII_MODE4)
ETH_LED_GREEN: J3.9, U12.31 (LED1/~100_SEL)
ETH_LED_YELLOW: J3.11, U12.30 (LED0/~AUTO_NEG_EN)
ETH_MDC: J4.22, U12.12 (MDC)
ETH_MDIO: J4.20, U12.11 (MDIO)
ETH_POWERDOWN: U12.21 (~INT), U19.12 (O4)
ETH_RESET: U12.32 (~RST), U19.15 (O5)
ETH_RX_CLK: J4.14, U12.19 (RX_CLK)
ETH_RX_D0: J4.21, U12.16 (RXD0/~HF_DX/_FULL_DX)
ETH_RX_D1: J4.23, U12.15 (RXD1/~PHY_ADD2)
ETH_RX_DV: J4.25, U12.18 (RX_DV/~MII_MODE10)
ETH_RX_ER: J4.16, U12.20 (RX_ER/~MII_ISOL_EN)
ETH_TX_CLK: J4.19, U12.22 (TX_CLK)
ETH_TX_D0: J4.13, U12.24 (TXD0)
ETH_TX_D1: J4.15, U12.25 (TXD1)
ETH_TX_EN: J4.17, U12.23 (TX_EN)
GND: C1.2, C2.2, C3.1, C4.1, C5.1, C6.1, C7.2, C8.2, C9.2, C10.2, C11.2, C12.2, C13.2, C14.2, C15.2, C17.2, C18.2, D1.2 (A), H1.1, H2.1, H3.1, H4.1, H5.1, H6.1, H7.1, H8.1, H9.1, H10.1, H11.1, H12.1, H13.1, H14.1, H15.1, H16.1, H17.1, J1.0 (PAD), J1.8, J2.0 (PAD), J2.8, J3.8, J3.SH, J4.1, J4.2, J4.5, J4.6, J4.61, J4.62, J5.1, J5.2, J5.5, J5.6, J5.61, J5.62, J6.2, J6.S1 (SHIELD), J6.S2 (SHIELD), J7.2, J8.5, J9.6 (SUPPLY_VOLTAGE_GROUND), J9.10 (CD_SWITCH2), J9.S1 (SHIELD), J9.S2 (SHIELD), J9.S3 (SHIELD), J9.S4 (SHIELD), J10.2 (TMDSDATA2SHIELD), J10.5 (TMDSDATA1SHIELD), J10.8 (TMDSDATA0SHIELD), J10.11 (TMDSCLOCKSHIELD), J10.17 (DDC/CECGROUND), J10.SHELL, J10.SHELL1, J10.SHELL2, J10.SHELL3, J13.2, J13.3, J14.1, J14.3, J14.5, J14.7, J14.9, J14.11, J14.13, J14.15, J14.17, J14.19, J14.21, J14.23, J14.25, J14.27, J14.29, J14.31, J14.33, J16.2, J16.3, J18.3, J18.6, J19.1, J19.12, J19.A, J19.N, J20.1, J20.22, J20.A, J20.Z, J21.1, J21.5, J22.0, J22.5, J22.6, J22.7, J22.8, J22.10, J23.S, J24.2, J24.S1 (Shield), J24.S2 (Shield), J25.3, J25.4, J26.3, J26.4, J27.2, J27.10, J28.1, J30.2, J30.10, JB1.1, JB1.2, JP1.3 (B), P1.3 (VSS1), P1.6 (VSS2), P1.11 (COM), R29.2, R32.2, R33.2, R34.2, R35.2, R36.1, S1.1, S1.2, S1.3, S1.4, S1.5, S1.6, S1.7, S1.8, SW1.2 (B), SW1.5 (B), SW2.SH (SHIELD), U1.1 (OE), U1.10 (GND), U1#2.1 (OE), U1#2.10 (GND), U2.10 (GND), U2#2.10 (GND), U3.10 (GND), U3#2.10 (GND), U4.1 (OE), U4.10 (GND), U4#2.1 (OE), U4#2.10 (GND), U5.5, U5.7 (GND), U5.9, U5.11, U5.13, U6.10 (GND), U7.10 (GND), U8.1 (OE), U8.10 (GND), U9.1 (OE), U9.10 (GND), U10.7 (GND), U11.7 (GND), U12.1 (ENHANCED/~BASIC), U12.33 (GND/Thermal_Pad), U13.10 (GND), U14.33 (GND), U15.4 (GND), U16.10 (GND), U17.10 (GND), U18.1 (OE), U18.10 (GND), U19.1 (OE), U19.10 (GND), U20.10, U20.13, U22.1, U22.7 (GND), U23.10 (GND), U25.1 (OE), U25.10 (GND), U26.1 (OE), U26.10 (GND), U27.4 (E1), U27.8 (GND), U28.4 (E1), U28.5 (E2), U28.8 (GND), U29.4 (E1), U29.8 (GND), U30.4 (E1), U30.5 (E2), U30.8 (GND), U31.3, U31.5, U31.9, U31.11, U31.13, U32.10 (GND), U33.10 (GND), U34.10 (GND), U35.1 (OE), U35.10 (GND), U36.1 (OE), U36.10 (GND), U37.1 (OE), U37.10 (GND), U38.10 (GND), U39.10 (GND), U40.1 (OE), U40.10 (GND), U41.1 (OE), U41.10 (GND), U43.10 (GND), U44.1 (OE), U44.10 (GND)
HDMI_CK+: J4.29, U14.31 (IN_D4-)
HDMI_CK-: J4.30, U14.32 (IN_D4+)
HDMI_D0+: J4.31, U14.29 (IN_D3-)
HDMI_D0-: J4.32, U14.30 (IN_D3+)
HDMI_D1+: J4.33, U14.27 (IN_D2-)
HDMI_D1-: J4.34, U14.28 (IN_D2+)
HDMI_D2+: J4.35, U14.25 (IN_D1-)
HDMI_D2-: J4.36, U14.26 (IN_D1+)
HDMI_HIZ_EN: U14.24 (HIZ_EN), U19.2 (O0)
HDMI_HPD: J4.26, U14.5 (HPD_SOURCE)
HDMI_OE_N: U14.17 (/OE), U19.5 (O1)
HDMI_SCL: J4.27, U14.7 (SCL_SOURCE)
HDMI_SDA: J4.28, U14.6 (SDA_SOURCE)
IEC_ATN: J6.3, J19.9, R5.1, U22.8
JTAG_TCK: J7.3, J27.1, JB1.4
JTAG_TDI: J7.5, J27.9, JB1.10
JTAG_TDO: J7.4, J27.3, JB1.8
JTAG_TMS: J7.6, J27.5, JB1.12
MUX_A0: J5.47, U27.1 (A0), U28.1 (A0), U29.1 (A0), U30.1 (A0)
MUX_A1: J5.49, U27.2 (A1), U28.2 (A1), U29.2 (A1), U30.2 (A1)
MUX_A2: J5.51, U27.3 (A2), U28.3 (A2), U29.3 (A2), U30.3 (A2)
MUX_A3: J5.53, U27.5 (E2), U28.6 (E3), U29.5 (E2), U30.6 (E3)
MUX_DI0: J5.31, J25.6, U2.2 (O0), U2#2.2 (O0), U3.2 (O0), U3#2.2 (O0), U13.2 (O0), U16.2 (O0), U17.2 (O0), U23.2 (O0), U32.2 (O0), U33.2 (O0), U34.2 (O0), U38.2 (O0), U39.2 (O0), U43.2 (O0)
MUX_DI1: J5.33, J25.8, U2.5 (O1), U2#2.5 (O1), U3.5 (O1), U3#2.5 (O1), U13.5 (O1), U17.5 (O1), U23.5 (O1), U32.5 (O1), U33.5 (O1), U34.5 (O1), U38.5 (O1), U39.5 (O1), U43.5 (O1)
MUX_DI2: J5.35, J25.10, U2.6 (O2), U2#2.6 (O2), U3.6 (O2), U3#2.6 (O2), U13.6 (O2), U16.6 (O2), U17.6 (O2), U23.6 (O2), U32.6 (O2), U33.6 (O2), U34.6 (O2), U38.6 (O2), U39.6 (O2), U43.6 (O2)
MUX_DI3: J5.37, J25.12, U2.9 (O3), U2#2.9 (O3), U3.9 (O3), U3#2.9 (O3), U13.9 (O3), U16.9 (O3), U17.9 (O3), U23.9 (O3), U32.9 (O3), U33.9 (O3), U34.9 (O3), U38.9 (O3), U39.9 (O3), U43.9 (O3)
MUX_DI4: J5.39, J25.20, U2.12 (O4), U2#2.12 (O4), U3.12 (O4), U3#2.12 (O4), U13.12 (O4), U16.12 (O4), U17.12 (O4), U23.12 (O4), U32.12 (O4), U33.12 (O4), U34.12 (O4), U38.12 (O4), U39.12 (O4), U43.12 (O4)
MUX_DI5: J5.41, J25.18, U13.15 (O5), U16.15 (O5), U17.15 (O5), U23.15 (O5), U32.15 (O5), U33.15 (O5), U34.15 (O5), U38.15 (O5), U39.15 (O5), U43.15 (O5)
MUX_DI6: J5.43, J25.16, U13.16 (O6), U16.16 (O6), U17.16 (O6), U23.16 (O6), U32.16 (O6), U33.16 (O6), U34.16 (O6), U38.16 (O6), U39.16 (O6), U43.16 (O6)
MUX_DI7: J5.45, J25.14, U13.19 (O7), U16.19 (O7), U23.19 (O7), U32.19 (O7), U33.19 (O7), U34.19 (O7), U38.19 (O7), U39.19 (O7), U43.19 (O7)
MUX_DO0: J5.32, J25.22, U1.3 (D0), U1#2.3 (D0), U4.3 (D0), U4#2.3 (D0), U18.3 (D0), U19.3 (D0), U25.3 (D0), U26.3 (D0), U35.3 (D0), U36.3 (D0), U37.3 (D0), U40.3 (D0), U41.3 (D0), U44.3 (D0)
MUX_DO1: J5.34, J25.24, U1.4 (D1), U1#2.4 (D1), U4.4 (D1), U4#2.4 (D1), U18.4 (D1), U19.4 (D1), U25.4 (D1), U26.4 (D1), U35.4 (D1), U36.4 (D1), U37.4 (D1), U40.4 (D1), U41.4 (D1), U44.4 (D1)
MUX_DO2: J5.36, J25.26, U1.7 (D2), U1#2.7 (D2), U4.7 (D2), U4#2.7 (D2), U18.7 (D2), U19.7 (D2), U25.7 (D2), U26.7 (D2), U35.7 (D2), U36.7 (D2), U37.7 (D2), U40.7 (D2), U41.7 (D2), U44.7 (D2)
MUX_DO3: J5.38, J25.28, U1.8 (D3), U1#2.8 (D3), U4.8 (D3), U4#2.8 (D3), U18.8 (D3), U19.8 (D3), U25.8 (D3), U26.8 (D3), U35.8 (D3), U36.8 (D3), U37.8 (D3), U40.8 (D3), U41.8 (D3), U44.8 (D3)
MUX_DO4: J5.40, J25.30, U1.13 (D4), U1#2.13 (D4), U4.13 (D4), U4#2.13 (D4), U18.13 (D4), U19.13 (D4), U25.13 (D4), U26.13 (D4), U35.13 (D4), U36.13 (D4), U37.13 (D4), U40.13 (D4), U41.13 (D4), U44.13 (D4)
MUX_DO5: J5.42, J25.32, U1.14 (D5), U1#2.14 (D5), U4.14 (D5), U4#2.14 (D5), U18.14 (D5), U19.14 (D5), U25.14 (D5), U26.14 (D5), U35.14 (D5), U36.14 (D5), U37.14 (D5), U40.14 (D5), U41.14 (D5), U44.14 (D5)
MUX_DO6: J5.44, J25.34, U1.17 (D6), U1#2.17 (D6), U18.17 (D6), U19.17 (D6), U25.17 (D6), U26.17 (D6), U35.17 (D6), U36.17 (D6), U37.17 (D6), U40.17 (D6), U41.17 (D6), U44.17 (D6)
MUX_DO7: J5.46, J25.36, U1.18 (D7), U1#2.18 (D7), U18.18 (D7), U19.18 (D7), U25.18 (D7), U26.18 (D7), U35.18 (D7), U36.18 (D7), U37.18 (D7), U40.18 (D7), U41.18 (D7), U44.18 (D7)
MUX_LATCH_0: U1.11 (LE), U1#2.11 (LE), U2.11 (Cp), U2#2.11 (Cp)
MUX_LATCH_0_N: U2.1 (OE), U2#2.1 (OE)
MUX_LATCH_1: U3.11 (Cp), U3#2.11 (Cp), U4.11 (LE), U4#2.11 (LE)
MUX_LATCH_1_N: U3.1 (OE), U3#2.1 (OE)
MUX_SEL_2: J25.38, U27.13 (O2)
MUX_SEL_2_N: J25.40, U29.13 (O2)
MUX_SEL_3: J25.37, U27.12 (O3)
MUX_SEL_3_N: J25.39, U29.12 (O3)
MUX_SEL_4: U17.11 (Cp), U19.11 (Cp), U27.11 (O4)
MUX_SEL_4_N: U17.1 (OE), U29.11 (O4)
MUX_SEL_5: U16.11 (Cp), U18.11 (Cp), U27.10 (O5)
MUX_SEL_5_N: U16.1 (OE), U29.10 (O5)
MUX_SEL_6: U23.11 (Cp), U26.11 (Cp), U27.9 (O6)
MUX_SEL_6_N: U23.1 (OE), U29.9 (O6)
MUX_SEL_7: U25.11 (Cp), U27.7 (O7)
MUX_SEL_8: U13.11 (Cp), U28.15 (O0)
MUX_SEL_8_N: U13.1 (OE), U30.15 (O0)
MUX_SEL_9: U28.14 (O1), U33.11 (Cp), U36.11 (Cp)
MUX_SEL_9_N: U30.14 (O1), U33.1 (OE)
MUX_SEL_10: U28.13 (O2), U38.11 (Cp), U40.11 (Cp)
MUX_SEL_10_N: U30.13 (O2), U38.1 (OE)
MUX_SEL_11: U28.12 (O3), U34.11 (Cp), U37.11 (Cp)
MUX_SEL_11_N: U30.12 (O3), U34.1 (OE)
MUX_SEL_12: U28.11 (O4), U39.11 (Cp), U41.11 (Cp)
MUX_SEL_12_N: U30.11 (O4), U39.1 (OE)
MUX_SEL_13: U28.10 (O5), U32.11 (Cp), U35.11 (Cp)
MUX_SEL_13_N: U30.10 (O5), U32.1 (OE)
MUX_SEL_14: U28.9 (O6), U43.11 (Cp), U44.11 (Cp)
MUX_SEL_14_N: U30.9 (O6), U43.1 (OE)
NMI_N: J20.D, RN4.7 (R6), U32.7 (D2)
unnamed: C1.1, U12.2 (CEXT)
unnamed: C2.1, C7.1, C8.1, C9.1, FB1.2, U12.3 (VDDA3V3), U12.17 (VDDIO)
unnamed: C10.1, J3.2 (TCT)
unnamed: C11.1, J3.5 (RCT)
unnamed: C16.1, U15.3 (BOOST)
unnamed: C16.2, D1.1 (K), L1.1, U15.1 (SW)
unnamed: J3.10, R27.2
unnamed: J3.12, R28.2
unnamed: J9.4 (SUPPLY_VOLTAGE), R37.2
unnamed: J17.1, J17.A
unnamed: J17.3, J17.C, J18.4
unnamed: J22.13, R80.1
unnamed: J22.14, R81.1
unnamed: R1.2, U3.3 (D0), U3#2.3 (D0)
unnamed: R2.2, U3.4 (D1), U3#2.4 (D1)
unnamed: R3.2, U3.7 (D2), U3#2.7 (D2)
unnamed: R4.2, U3.8 (D3), U3#2.8 (D3)
unnamed: R5.2, U3.13 (D4), U3#2.13 (D4)
unnamed: R6.2, U2.3 (D0), U2#2.3 (D0)
unnamed: R7.2, U2.4 (D1), U2#2.4 (D1)
unnamed: R8.2, U2.7 (D2), U2#2.7 (D2)
unnamed: R9.2, U2.8 (D3), U2#2.8 (D3)
unnamed: R10.2, U2.13 (D4), U2#2.13 (D4)
unnamed: R29.1, U12.10 (RBIAS)
unnamed: R32.1, U14.8 (EQ0)
unnamed: R33.1, U14.2 (EQ1)
unnamed: R34.1, U14.22 (DDC_EN)
unnamed: R35.1, U14.3 (DDET)
unnamed: R36.2, U14.4 (REXT)
unnamed: J15.2, SW2.3 (C)
unnamed: U5.1, U8.2 (O0)
unnamed: U5.3, U8.5 (O1)
unnamed: U8.16 (O6), U10.1
unnamed: U9.5 (O1), U10.3
unnamed: U8.6 (O2), U10.5
unnamed: U8.9 (O3), U10.9
unnamed: U8.12 (O4), U10.11
unnamed: U8.15 (O5), U10.13
unnamed: U9.2 (O0), U11.1
unnamed: U9.16 (O6), U11.3
unnamed: U9.6 (O2), U11.5
unnamed: U9.9 (O3), U11.9
unnamed: U9.12 (O4), U11.11
unnamed: U9.15 (O5), U11.13
SDCARD_CD_SW: P1.10 (CD_SWITCH), R31.1, U17.13 (D4)
SDCARD_CLK: J5.56, P1.5 (CLK)
SDCARD_CMD: J5.54, P1.2 (CMD)
SDCARD_D0: J5.58, P1.7 (DAT0)
SDCARD_D1: J5.60, P1.8 (DAT1)
SDCARD_D2: J5.50, P1.9 (DAT2)
SDCARD_D3: J5.52, P1.1 (DAT3/CD)
SDCARD_WP_SW: P1.13 (WP_SWITCH), R30.1, U17.8 (D3)
UART_RX: J4.38, J28.3, JB1.3
UART_TX: J4.40, J28.2, JB1.7
VGA_B0: J4.54, R79.1
VGA_B1: J4.52, R78.1
VGA_B2: J4.50, R77.1
VGA_B3: J4.48, R76.1
VGA_B4: J4.46, R75.1
VGA_B5: J4.44, R74.1
VGA_G0: J4.59, R73.1
VGA_G1: J4.57, R72.1
VGA_G2: J4.55, R71.1
VGA_G3: J4.53, R70.1
VGA_G4: J4.51, R69.1
VGA_G5: J4.49, R68.1
VGA_HSYNC: J4.56, R80.2
VGA_R0: J4.47, R67.1
VGA_R1: J4.45, R66.1
VGA_R2: J4.43, R65.1
VGA_R3: J4.41, R64.1
VGA_R4: J4.39, R63.1
VGA_R5: J4.37, R62.1
VGA_VSYNC: J4.58, R81.2
microSD_CD_Switch: J9.9 (CD_SWITCH1), R37.1, U17.14 (D5)
microSD_CLK: J4.10, J9.5 (CLOCK)
microSD_CMD: J4.12, J9.3 (COMMAND/RESPONSE)
microSD_D0: J4.7, J9.7 (DATA_LINE[BIT_0])
microSD_D1: J4.9, J9.8 (DATA_LINE[BIT_1])
microSD_D2: J4.11, J9.1 (DATA_LINE[BIT_2])
microSD_D3: J4.8, J9.2 (CARD_DETECT/DATA_LINE[BIT_3])
