MEGA65/mega65-r3-expansion-board/(commit log)

2022-10-12 begin working on MEGA65CR (cost reduced) R1 schematic
    [mega65cr-r1.kicad_pcb, mega65cr-r1.kicad_sch]
2022-10-12 add IEC port connector and footprint
    [mega65cr-r1.kicad_sch]
2022-10-12 complete IEC and 34-pin floppy interface sheet
    [mega65cr-r1.kicad_pcb, mega65cr-r1.kicad_sch]
2022-10-12 refactor floppy circuits onto own sheet
    [floppy_interfaces.kicad_sch, mega65cr-r1.kicad_sch]
2022-10-12 add files to track local libraries
2022-10-12 add joystick sheet
    [floppy_interfaces.kicad_sch, joysticks.kicad_sch, mega65cr-r1.kicad_sch]
2022-10-12 fix footprints and update PCB
    [floppy_interfaces.kicad_sch, joysticks.kicad_sch, mega65cr-r1.kicad_sch]
2022-10-12 track fp-info-cache
2022-10-12 add stubs for missing sheets
    [fpga-wukong.kicad_sch, mega65cr-r1.kicad_sch, misc_ports.kicad_sch, power.kicad_sch]
2022-10-12 add sheets for expansion port, userport, VGA and multiplexor bus
    [expansionport.kicad_sch, mega65cr-r1.kicad_sch, multiplexorbus.kicad_sch, userport.kicad_sch, vga.kicad_sch]
2022-10-12 instantiate 3-8 decoders for MUX
    [mega65cr-r1.kicad_sch, multiplexorbus.kicad_sch]
2022-10-12 fix signal directions
    [floppy_interfaces.kicad_sch, joysticks.kicad_sch]
2022-10-12 select latches for mux
    [mega65cr-r1.kicad_sch, multiplexorbus.kicad_sch]
2022-10-13 rework floppy buffers to use mux bus
    [floppy_interfaces.kicad_sch, mega65cr-r1.kicad_sch, multiplexorbus.kicad_sch]
2022-10-13 add inverting mux to allow use of 74LVC374 as tristate buffer
    [floppy_interfaces.kicad_sch, joysticks.kicad_sch, mega65cr-r1.kicad_sch, multiplexorbus.kicad_sch]
2022-10-13 fix joystick input to use mux correctly
    [joysticks.kicad_sch, mega65cr-r1.kicad_sch]
2022-10-13 fix joystick outputs to use mux bus
    [joysticks.kicad_sch, mega65cr-r1.kicad_sch]
2022-10-13 reformat joystick sheet
    [joysticks.kicad_sch]
2022-10-13 add reset button
    [joysticks.kicad_sch, mega65cr-r1.kicad_sch, misc_ports.kicad_sch]
2022-10-13 add digital video connectors and JTAG/UART header
    [mega65cr-r1.kicad_sch, misc_ports.kicad_sch]
2022-10-13 add symbol and footprint for power connector
2022-10-13 add symbol and footprint for fuse
2022-10-13 finish implementing 5V power supply
    [mega65cr-r1.kicad_sch, power.kicad_sch]
2022-10-13 add header for +5V to QMTECH WUKONG FPGA board
    [mega65cr-r1.kicad_sch, power.kicad_sch]
2022-10-13 add notes for other ports
    [misc_ports.kicad_sch, userport.kicad_sch, vga.kicad_sch]
2022-10-14 begin implementing tape port. add symbols for C64 ports
    [joysticks.kicad_sch, mega65cr-r1.kicad_sch, multiplexorbus.kicad_sch, userport.kicad_sch]
2022-10-14 connect missing IEC outputs
    [floppy_interfaces.kicad_sch]
2022-10-14 add footprint to tape port
    [mega65cr-r1.kicad_sch]
2022-10-14 add no-connects to various unused pins
    [userport.kicad_sch]
2022-10-14 setup pins on userport, but not yet connected to mux bus
    [floppy_interfaces.kicad_sch, mega65cr-r1.kicad_sch, userport.kicad_sch]
2022-10-14 create footprint for userport edge connector
    [mega65cr-r1.kicad_sch, multiplexorbus.kicad_sch, userport.kicad_sch]
2022-10-14 reformat userport sheet
    [userport.kicad_sch]
2022-10-14 place expansion port and set footprint
    [expansionport.kicad_sch, mega65cr-r1.kicad_sch]
2022-10-14 work on expansion port
    [expansionport.kicad_sch, mega65cr-r1.kicad_sch]
2022-10-14 DOTCLOCK fed via 74LS04 to perform fast level conversion
    [expansionport.kicad_sch, mega65cr-r1.kicad_sch]
2022-10-14 add 8-way dipswitch bank
    [mega65cr-r1.kicad_sch, misc_ports.kicad_sch, multiplexorbus.kicad_sch]
2022-10-14 add footprint for dipswitch
2022-10-14 work on ethernet
    [mega65cr-r1.kicad_sch, misc_ports.kicad_sch]
2022-10-14 add footprint for ferrite bead, work on eth phy
    [mega65cr-r1.kicad_sch, misc_ports.kicad_sch]
2022-10-15 work on digital video output
    [mega65cr-r1.kicad_sch, misc_ports.kicad_sch]
2022-10-15 add RTC I2C header
    [mega65cr-r1.kicad_sch, misc_ports.kicad_sch]
2022-10-15 add microSD and full-sized SD card slots
    [mega65cr-r1.kicad_sch, misc_ports.kicad_sch]
2022-10-15 add new HDMI buffer chip and footprint
2022-10-15 switch to same HDMI helper chip as on MEGA65 R4 PCB
    [mega65cr-r1.kicad_sch, misc_ports.kicad_sch]
2022-10-15 hook up expansion port using MUX bus
    [expansionport.kicad_sch, mega65cr-r1.kicad_sch, multiplexorbus.kicad_sch]
2022-10-15 add VGA connector and resistor DACs
    [mega65cr-r1.kicad_sch, vga.kicad_sch]
2022-10-15 add resistor laddars for 3.5mm audio and component video outputs
    [mega65cr-r1.kicad_sch, vga.kicad_sch]
2022-10-15 add C64 A/V port
    [mega65cr-r1.kicad_sch, vga.kicad_sch]
2022-10-15 add 3.5mm audio jack
    [mega65cr-r1.kicad_sch, vga.kicad_sch]
2022-10-15 add reversable audio header, e.g., for internal speakers + amp
    [mega65cr-r1.kicad_sch, vga.kicad_sch]
2022-10-15 add connectors and FPGA pin descriptions for QMTECH K345T board
    [fpga-wukong.kicad_sch, mega65cr-r1.kicad_sch]
2022-10-15 plumb all direct FPGA signals.
    [fpga-wukong.kicad_sch, mega65cr-r1.kicad_sch, misc_ports.kicad_sch, userport.kicad_sch, vga.kicad_sch]
2022-10-15 beautify the schematics, especially the title-page
    [expansionport.kicad_sch, floppy_interfaces.kicad_sch, fpga-wukong.kicad_sch, joysticks.kicad_sch, mega65cr-r1.kicad_sch, misc_ports.kicad_sch, multiplexorbus.kicad_sch, power.kicad_sch]
2022-10-15 add all missing footprints
    [expansionport.kicad_sch, floppy_interfaces.kicad_sch, fpga-wukong.kicad_sch, joysticks.kicad_sch, mega65cr-r1.kicad_pcb, mega65cr-r1.kicad_sch, misc_ports.kicad_sch, multiplexorbus.kicad_sch]
2022-10-15 add mezannine for joystick ports to de-clutter board.
    [joysticks.kicad_sch, mega65cr-r1.kicad_pcb, mega65cr-r1.kicad_sch, misc_ports.kicad_sch, power.kicad_sch, userport.kicad_sch]
2022-10-16 start routing joystick mezzannine
    [joysticks.kicad_sch, mega65cr-r1.kicad_pcb, mega65cr-r1.kicad_sch]
2022-10-16 finish laying out joystick mezzannine PCB
    [joysticks.kicad_sch, mega65cr-r1.kicad_pcb]
2022-10-16 tweak mezzannine board dimensions
    [mega65cr-r1.kicad_pcb]
2022-10-16 replace 74LS373s with 74LS374s #5
    [expansionport.kicad_sch, mega65cr-r1.kicad_sch, multiplexorbus.kicad_sch, userport.kicad_sch]
2022-10-16 replace remaining 74LS373 with 74LS374s #5
    [expansionport.kicad_sch, floppy_interfaces.kicad_sch, joysticks.kicad_sch, mega65cr-r1.kicad_pcb, mega65cr-r1.kicad_sch, userport.kicad_sch]
2022-10-16 make R/W signals on cart port open-collector with pullup #6
    [expansionport.kicad_sch, floppy_interfaces.kicad_sch, joysticks.kicad_sch, mega65cr-r1.kicad_sch]
2022-10-16 fix resistor pack signal order #6
    [expansionport.kicad_sch]
2022-10-16 add missing power switch #7
    [expansionport.kicad_sch, mega65cr-r1.kicad_pcb, mega65cr-r1.kicad_sch, power.kicad_sch]
2022-10-16 correct position of power input and switch and cart port
    [mega65cr-r1.kicad_pcb]
2022-10-16 further fix cart port and power switch connections #2
    [mega65cr-r1.kicad_pcb, power.kicad_sch]
2022-10-16 correct port positions and cutouts #2
    [mega65cr-r1.kicad_pcb]
2022-10-17 add missing MEGA65 keyboard connector and keyboard JTAG header #10 #12
    [fpga-wukong.kicad_sch, mega65cr-r1.kicad_pcb, mega65cr-r1.kicad_sch, misc_ports.kicad_sch]
2022-10-17 add USB blaster JTAG and bare UART headers #11
    [mega65cr-r1.kicad_sch, misc_ports.kicad_sch]
2022-10-17 add C64 keyboard connector on MUX bus #9
    [mega65cr-r1.kicad_sch, multiplexorbus.kicad_sch, vga.kicad_sch]
2022-10-17 connect RESTORE key on C64 KBD to /NMI line on cart port #9
    [expansionport.kicad_sch]
2022-10-17 place some mounting holes and reset button #3
    [joysticks.kicad_sch, mega65cr-r1.kicad_pcb, mega65cr-r1.kicad_sch, misc_ports.kicad_sch, power.kicad_sch, vga.kicad_sch]
2022-10-17 add and position mounting holes #3
    [mega65cr-r1.kicad_pcb, mega65cr-r1.kicad_sch, power.kicad_sch]
2022-10-17 rearrange FPGA board connectors to detangle. Begin routing HDMI
    [fpga-wukong.kicad_sch, mega65cr-r1.kicad_pcb, misc_ports.kicad_sch]
2022-10-17 Replace HDMI connector #13
    [fpga-wukong.kicad_sch, mega65cr-r1.kicad_pcb, mega65cr-r1.kicad_sch, misc_ports.kicad_sch]
2022-10-17 route HDMI connector to HDMI helper chip #13
    [mega65cr-r1.kicad_pcb]
2022-10-18 route eth pairs, add GND planes
2022-10-18 fisish routing HDMI connector to helper chip
2022-10-18 finish routing VGA connector
    [fpga-wukong.kicad_sch, mega65cr-r1.kicad_sch, vga.kicad_sch]
2022-10-18 layout more of HDMI and ETH and surrounding areas
    [fpga-wukong.kicad_sch]
2022-10-18 route microSD card
    [fpga-wukong.kicad_sch]
2022-10-18 place power suppl
    [mega65cr-r1.kicad_sch, power.kicad_sch]
2022-10-18 show R values in symbols on silkscreen
2022-10-18 remove unneeded 12v trace
2022-10-18 route joystick ports and pullups etc
    [expansionport.kicad_sch, mega65cr-r1.kicad_sch, power.kicad_sch]
2022-10-18 add missing C64 keyboard footprint
    [mega65cr-r1.kicad_sch, vga.kicad_sch]
2022-10-18 route keyboard
    [vga.kicad_sch]
2022-10-18 add missing footprints
    [expansionport.kicad_sch, joysticks.kicad_sch, mega65cr-r1.kicad_sch, misc_ports.kicad_sch]
2022-10-19 route cart port to resistor packs
    [expansionport.kicad_sch]
2022-10-19 route part of cart port
    [expansionport.kicad_sch]
2022-10-19 begin routing mux bus
    [expansionport.kicad_sch]
2022-10-19 more cart and mux bus layout
    [expansionport.kicad_sch, multiplexorbus.kicad_sch]
2022-10-20 route IEC port. Remove duplicate footprints
    [expansionport.kicad_sch, floppy_interfaces.kicad_sch, mega65cr-r1.kicad_sch]
2022-10-20 renumber MUX registers to ease routing
    [floppy_interfaces.kicad_sch, joysticks.kicad_sch, misc_ports.kicad_sch, multiplexorbus.kicad_sch, vga.kicad_sch]
2022-10-21 route more cart port
    [expansionport.kicad_sch]
2022-10-21 route u4
    [floppy_interfaces.kicad_sch]
2022-10-21 more routing
    [expansionport.kicad_sch]
2022-10-21 plumb keyboard to MUX bus and fix RESTORE key label
    [vga.kicad_sch]
2022-10-21 add cut-outs for floppy cables #15
2022-10-21 de-overlap U3 from its neighbour
2022-10-21 route SD card resistors
2022-10-21 route hi MUX address lines
    [floppy_interfaces.kicad_sch, fpga-wukong.kicad_sch]
2022-10-21 place floppy components and remove redundant resistors
    [floppy_interfaces.kicad_sch, mega65cr-r1.kicad_sch]
2022-10-21 switch DIP8 to DIP4 using spare pins on floppy MUX R unit
    [floppy_interfaces.kicad_sch, fpga-wukong.kicad_sch, mega65cr-r1.kicad_sch, misc_ports.kicad_sch, multiplexorbus.kicad_sch]
2022-10-22 relocate pins to connect RTC I2C
    [floppy_interfaces.kicad_sch, fpga-wukong.kicad_sch, mega65cr-r1.kicad_sch, misc_ports.kicad_sch]
2022-10-22 fix Jtag enable for keyboard
    [misc_ports.kicad_sch]
2022-10-22 place and route JTAG and serial headers
    [mega65cr-r1.kicad_sch, misc_ports.kicad_sch]
2022-10-22 add symbol and footprint for mini-DIN8 for 1565
    [floppy_interfaces.kicad_sch, mega65cr-r1.kicad_sch, userport.kicad_sch]
2022-10-22 add 1565 interface #14
    [floppy_interfaces.kicad_sch, mega65cr-r1.kicad_sch]
2022-10-22 route 1565 and tape connectors #14
    [floppy_interfaces.kicad_sch, mega65cr-r1.kicad_sch, userport.kicad_sch]
2022-10-22 work on routing user port
    [floppy_interfaces.kicad_sch, userport.kicad_sch]
2022-10-22 only 2 more traces to route!
2022-10-22 add footprints to differentiate 3.3V from 5V ICs
    [expansionport.kicad_sch, floppy_interfaces.kicad_sch, joysticks.kicad_sch, mega65cr-r1.kicad_sch, userport.kicad_sch, vga.kicad_sch]
2022-10-23 try to fix B.silk, add VIN to +12V_FUSED jumper
    [fpga-wukong.kicad_sch, joysticks.kicad_sch, mega65cr-r1.kicad_sch, power.kicad_sch]
2022-10-23 Increase power trace width on joystick mezzannine #8
2022-10-23 fix design rule violations
    [joysticks.kicad_sch, mega65cr-r1.kicad_sch]
2022-10-23 fix many DRC warnings
    [floppy_interfaces.kicad_sch, joysticks.kicad_sch, mega65cr-r1.kicad_sch, misc_ports.kicad_sch, power.kicad_sch, vga.kicad_sch]
2022-10-23 re-do many labels and DRC fixes
    [expansionport.kicad_sch, floppy_interfaces.kicad_sch, joysticks.kicad_sch, mega65cr-r1.kicad_sch, multiplexorbus.kicad_sch, userport.kicad_sch, vga.kicad_sch]
2022-10-23 add improved DIP footprints for smaller packages
2022-10-23 finish solving DRC violations
    [joysticks.kicad_sch, mega65cr-r1.kicad_sch, power.kicad_sch]
2022-10-23 add logos and explanatory text
    [mega65cr-r1.kicad_sch, power.kicad_sch]
2022-10-23 begin writing utility to create merged BOM from PCB
2022-10-23 work on BOM generation
    [expansionport.kicad_sch, mega65cr-r1.kicad_sch, partsmap.csv, power.kicad_sch]
2022-10-23 find more parts from BOM
    [partsmap.csv]
2022-10-23 more BOM parts cataloging
    [mega65cr-r1.kicad_sch, multiplexorbus.kicad_sch, partsmap.csv]
2022-10-23 add power-bypass, fix DRC violation, U29 is 5V VCC
    [mega65cr-r1.kicad_sch, multiplexorbus.kicad_sch, power.kicad_sch]
2022-10-24 address #21 and #22
    [expansionport.kicad_sch, mega65cr-r1.kicad_sch]
2022-10-24 resolve all items in BoM
    [partsmap.csv]
2022-10-24 update schematic due to BoM requirements
    [mega65cr-r1.kicad_sch, power.kicad_sch]
2022-10-24 don't overwrite order items in per-supplier BoMs
    [partsmap.csv]
2022-10-26 consistenly call the board the MEGA65 CR R1, not MEGA65 R5
2022-10-26 begin renaming project to use as basis for r3 expansion board
2022-10-26 continue renaming project
    [mega65-r3-expansion-board.kicad_sch]
2022-10-26 rework user port
    [expansionport.kicad_sch, floppy_interfaces.kicad_sch, fpga-wukong.kicad_sch, joysticks.kicad_sch, mega65-r3-expansion-board.kicad.kicad_pcb, mega65-r3-expansion-board.kicad.kicad_sch, mega65-r3-expansion-board.kicad_sch, misc_ports.kicad_sch]
2022-10-26 reconnect everything and add PMOD and 34pin floppy connectors
    [mega65-r3-expansion-board.kicad.kicad_sch, multiplexorbus.kicad_sch, userport.kicad_sch, vga.kicad_sch]
2022-10-26 begin placing and routing
    [mega65-r3-expansion-board.kicad.kicad_pcb, mega65-r3-expansion-board.kicad.kicad_sch, multiplexorbus.kicad_sch, userport.kicad_sch]
2022-10-27 fix U30 VCC and footprint
    [mega65-r3-expansion-board.kicad.kicad_sch, multiplexorbus.kicad_sch]
2022-10-29 route many signals
    [mega65-r3-expansion-board.kicad.kicad_pcb]
2022-10-29 route many more signals
    [mega65-r3-expansion-board.kicad.kicad_pcb]
2022-10-30 yet more routing
    [mega65-r3-expansion-board.kicad.kicad_pcb, mega65-r3-expansion-board.kicad.kicad_sch, multiplexorbus.kicad_sch, power.kicad_sch, userport.kicad_sch, vga.kicad_sch]
2022-10-30 finish routing signals
    [mega65-r3-expansion-board.kicad.kicad_pcb]
2022-10-30 shrink board, resolve all DRC errors, add openhardware logo
    [mega65-r3-expansion-board.kicad.kicad_pcb]
2022-10-30 add github URL to silkscreen
    [mega65-r3-expansion-board.kicad.kicad_pcb]
2022-10-30 add silkscreen to FDD connectors. Tweak some tracks.
    [mega65-r3-expansion-board.kicad.kicad_pcb]
2022-10-30 finalise for PCBWay initial prototyping
    [mega65-r3-expansion-board.kicad.kicad_pcb]
2022-10-30 fix remaining problems
    [mega65-r3-expansion-board.kicad.kicad_pcb, mega65-r3-expansion-board.kicad.kicad_sch, power.kicad_sch]
2022-10-31 update master sheet for schematics
    [mega65-r3-expansion-board.kicad.kicad_sch, multiplexorbus.kicad_sch, power.kicad_sch, userport.kicad_sch, vga.kicad_sch]
2022-10-31 correct stale board ID
    [power.kicad_sch]
2022-10-31 begin working on bom.md
2022-11-01 put notch in correct place of userport connector
    [mega65-r3-expansion-board.kicad.kicad_pcb]
2022-11-01 replot after userport fix
    [mega65-r3-expansion-board.kicad.kicad_pcb]
2022-11-03 fix designation of 3.3V ICs
    [mega65-r3-expansion-board.kicad.kicad_pcb, mega65-r3-expansion-board.kicad.kicad_sch, multiplexorbus.kicad_sch, power.kicad_sch, userport.kicad_sch, vga.kicad_sch]
2022-11-07 add current limiting resistors to allow 74HC165 #1
    [mega65-r3-expansion-board.kicad.kicad_pcb, mega65-r3-expansion-board.kicad.kicad_sch, multiplexorbus.kicad_sch, power.kicad_sch, userport.kicad_sch, vga.kicad_sch]
2022-11-07 work on rerouting board to fit current limiting resistors #1
    [mega65-r3-expansion-board.kicad.kicad_pcb, mega65-r3-expansion-board.kicad.kicad_sch, multiplexorbus.kicad_sch, power.kicad_sch, userport.kicad_sch, vga.kicad_sch]
2022-11-07 continue routing current limiting resistors #1
2022-11-26 update footprint cache
2022-11-26 allow substitution of 6V regulator for one that is available
    [mega65-r3-expansion-board.kicad.kicad_sch, multiplexorbus.kicad_sch, power.kicad_sch, userport.kicad_sch, vga.kicad_sch]
2022-11-26 commit unsaved changes related to previous commit
    [mega65-r3-expansion-board.kicad.kicad_sch, userport.kicad_sch]
2022-11-26 Address #8, #6, #3
    [mega65-r3-expansion-board.kicad.kicad_sch, multiplexorbus.kicad_sch, power.kicad_sch, userport.kicad_sch, vga.kicad_sch]
2022-11-26 tweak ground pour for last commit
2022-11-27 fix #2 and generally tidy traces
2023-03-01 fix #9
    [mega65-r3-expansion-board.kicad.kicad_sch, multiplexorbus.kicad_sch, power.kicad_sch, userport.kicad_sch, vga.kicad_sch]
2023-04-03 pcbway revC order 20230404
2024-01-07 fix spi1_o -> sp1_o and route net
    [mega65-r3-expansion-board.kicad.kicad_sch, multiplexorbus.kicad_sch, power.kicad_sch, userport.kicad_sch, vga.kicad_sch]
2024-01-09 remove duplicate plumbing for CNT1
    [mega65-r3-expansion-board.kicad.kicad_sch, userport.kicad_sch]
2024-01-09 tidy up schematic trace
    [userport.kicad_sch]
2024-01-11 /PC2 is output only
    [mega65-r3-expansion-board.kicad.kicad_sch, userport.kicad_sch]
2024-01-11 remote more redundant nets
    [userport.kicad_sch]
2024-01-11 move JTAG headers to better align with PCB and tape port hole
    [mega65-r3-expansion-board.kicad.kicad_sch, userport.kicad_sch]
2024-01-12 add pin 1 markers for TE0790
2024-01-12 relocate TE0790 connector for better fit. Match M65 board depth
2024-01-12 add 3.3V zener to tape sense input
    [mega65-r3-expansion-board.kicad.kicad_sch, multiplexorbus.kicad_sch, power.kicad_sch, userport.kicad_sch, vga.kicad_sch]
2024-01-12 connect tape GND pin to GND
    [mega65-r3-expansion-board.kicad.kicad_sch, multiplexorbus.kicad_sch, userport.kicad_sch, vga.kicad_sch]
2024-01-12 add pullups for TAPE_SENSE and TAPE_READ
    [mega65-r3-expansion-board.kicad.kicad_sch, userport.kicad_sch]
2024-01-12 move vias away from silkscreen
2024-01-12 pull up tape inputs to 3.3V and get rid of zener diode
    [mega65-r3-expansion-board.kicad.kicad_sch, multiplexorbus.kicad_sch, userport.kicad_sch, vga.kicad_sch]
2024-01-13 add de-coupling cap to U1
    [mega65-r3-expansion-board.kicad.kicad_sch, userport.kicad_sch]
2024-01-13 add decoupling cap to U2
    [mega65-r3-expansion-board.kicad.kicad_sch, multiplexorbus.kicad_sch, userport.kicad_sch, vga.kicad_sch]
2024-01-13 add decoupling cap to U3
    [mega65-r3-expansion-board.kicad.kicad_sch, multiplexorbus.kicad_sch, userport.kicad_sch, vga.kicad_sch]
2024-01-13 add decoupling cap to U4
    [mega65-r3-expansion-board.kicad.kicad_sch, multiplexorbus.kicad_sch, userport.kicad_sch, vga.kicad_sch]
2024-01-13 add decoupling cap to U5
    [mega65-r3-expansion-board.kicad.kicad_sch, multiplexorbus.kicad_sch, userport.kicad_sch, vga.kicad_sch]
2024-01-13 add U6 and U7 decoupling caps
    [mega65-r3-expansion-board.kicad.kicad_sch, multiplexorbus.kicad_sch, userport.kicad_sch, vga.kicad_sch]
2024-01-13 add U8 decoupling cap
    [mega65-r3-expansion-board.kicad.kicad_sch, multiplexorbus.kicad_sch, userport.kicad_sch, vga.kicad_sch]
2024-01-13 add U9 U10 decoupling caps
    [mega65-r3-expansion-board.kicad.kicad_sch, multiplexorbus.kicad_sch, userport.kicad_sch, vga.kicad_sch]
2024-01-13 add U11 decoupling cap
    [mega65-r3-expansion-board.kicad.kicad_sch, userport.kicad_sch]
2024-01-13 remove old Zener diode info
2024-01-13 revert PCB size to original
2024-01-13 remove decoupling cap rear silkscreen. add 5V labels
    [mega65-r3-expansion-board.kicad.kicad_sch, multiplexorbus.kicad_sch, userport.kicad_sch, vga.kicad_sch]
2024-01-13 connect PA2_EN, make open-collector
    [mega65-r3-expansion-board.kicad.kicad_sch, userport.kicad_sch]
2024-01-13 move C1565 connector 0.5mm left
2024-01-13 correct hole positions
    [mega65-r3-expansion-board.kicad.kicad_sch, multiplexorbus.kicad_sch, power.kicad_sch, userport.kicad_sch, vga.kicad_sch]
2024-01-14 begin work on PMOD link PCB
    [pmod_connector_board.kicad_pcb, pmod_connector_board.kicad_sch]
2024-01-14 add board cut-out
    [pmod_connector_board.kicad_pcb, pmod_connector_board.kicad_sch]
2024-01-14 add GND and 3.3V planes
    [pmod_connector_board.kicad_pcb]
2024-01-14 fix pad numbering
    [pmod_connector_board.kicad_pcb]
2024-01-14 finish place and route. Reduce board size
    [pmod_connector_board.kicad_pcb]
2024-01-14 finish PMOD connector PCB
    [pmod_connector_board.kicad_pcb, pmod_connector_board.kicad_sch]
2024-01-14 use 3rd channel for video, not audio
    [mega65-r3-expansion-board.kicad.kicad_sch, multiplexorbus.kicad_sch, power.kicad_sch, userport.kicad_sch, vga.kicad_sch]
2024-01-14 move TE0790 relay socket nearer to MEGA65 board
2024-01-14 make 5V rail 1mm track
2024-01-14 branch 5V as much as possible
2024-01-14 branch 3.3V
2024-01-15 begin designing board to connect M65 to exp board
    [expansion_connector_board.kicad_pcb, expansion_connector_board.kicad_sch]
2024-01-15 update connector positions for bridge board
    [expansion_connector_board.kicad_pcb]
2024-01-15 complete electrical and cutout of bridge board
    [expansion_connector_board.kicad_pcb, expansion_connector_board.kicad_sch]
2024-01-15 trim board size
    [expansion_connector_board.kicad_pcb, expansion_connector_board.kicad_sch]
2024-01-15 export gerbers and final tidy up
    [expansion_connector_board.kicad_pcb, pmod_connector_board.kicad_pcb]
2024-01-22 correct PMOD placement on connector PCB
    [pmod_connector_board.kicad_pcb]
2024-01-22 fix connector placement on bridge board
    [expansion_connector_board.kicad_pcb, expansion_connector_board.kicad_sch]
2024-01-23 reduce connector board to 2-layer for faster fabrication
    [pmod_connector_board.kicad_pcb]
2024-01-23 add dimensional measurements to pmod connector
    [pmod_connector_board.kicad_pcb]
2024-01-23 reduce board size slightly
    [expansion_connector_board.kicad_pcb]
2024-02-03 commit unknown change that was hanging around
    [expansion_connector_board.kicad_pcb]
2024-02-03 switch to 2 pin resistor ladders
    [mega65-r3-expansion-board.kicad.kicad_sch, multiplexorbus.kicad_sch, power.kicad_sch, userport.kicad_sch, vga.kicad_sch]
2024-02-03 reduce video output impedence from 500 to 250 Ohms
    [mega65-r3-expansion-board.kicad.kicad_sch, vga.kicad_sch]
2024-02-03 revert JTAG footprints to having all pins
2024-02-03 tidy up some traces and remaining warnings
2024-02-04 move PMODs 1mm down. Expand board bottom to support PMODs
2024-02-04 move R21 away from floppy chassis
2024-02-04 finish moving PMODs and R21
    [mega65-r3-expansion-board.kicad.kicad_sch, vga.kicad_sch]
2024-02-04 flip J8 and relocate
    [expansion_connector_board.kicad_pcb]
2024-02-04 fix rel position of MEGA65 board side connectors
    [expansion_connector_board.kicad_pcb]
2024-02-04 fill-out size of bridge board to fit wifi etc
    [expansion_connector_board.kicad_pcb, expansion_connector_board.kicad_sch]
2024-02-04 work on various checking various measurements
    [expansion_connector_board.kicad_pcb]
2024-02-04 add lots of measurement marks for bridge board
    [expansion_connector_board.kicad_pcb]
2024-02-04 move PMODs on expansion board left 0.51mm
    [expansion_connector_board.kicad_pcb]
2024-02-04 update floppy header names to match underlying boards
    [expansion_connector_board.kicad_pcb, expansion_connector_board.kicad_sch]
2024-02-04 add ESP32 component libraries
2024-02-04 update to kicad 7. begin adding ESP32
    [expansion_connector_board.kicad_pcb, expansion_connector_board.kicad_sch]
2024-02-04 finish adding ESP32 to bridge board
    [expansion_connector_board.kicad_pcb, expansion_connector_board.kicad_sch]
2024-02-06 add more pins to peripheral header. Reorder
    [expansion_connector_board.kicad_pcb, expansion_connector_board.kicad_sch]
2024-02-18 add remaining connectors to bridge board
    [expansion_connector_board.kicad_pcb, expansion_connector_board.kicad_sch]
2024-02-23 add matched position ESP32 connector on expansion board
    [mega65-r3-expansion-board.kicad.kicad_sch, multiplexorbus.kicad_sch, power.kicad_sch, userport.kicad_sch, vga.kicad_sch]
2024-02-23 remove obsoleted note
    [vga.kicad_sch]
2024-02-23 plumb WIFI_EN line
    [multiplexorbus.kicad_sch]
2024-02-23 use ring clock for C1565 port
    [userport.kicad_sch]
2024-02-23 direct C1565_SERIO, C1565_LD outputs
    [multiplexorbus.kicad_sch, userport.kicad_sch]
2024-02-23 begin adding missing C1565 signal buffers
    [multiplexorbus.kicad_sch]
2024-02-24 fix design rule check errors and false alarms
    [mega65-r3-expansion-board.kicad.kicad_pcb]
2024-02-24 fix and finish routing 3.3V SERIO and related things
    [mega65-r3-expansion-board.kicad.kicad_pcb, multiplexorbus.kicad_sch, userport.kicad_sch]
2024-02-24 fatten 3.3V rail part of its length
    [mega65-r3-expansion-board.kicad.kicad_pcb]
2024-02-24 begin peeling out C1565 port to separate sheet
    [c1565.kicad_sch, mega65-r3-expansion-board.kicad.kicad_pcb, mega65-r3-expansion-board.kicad.kicad_sch, multiplexorbus.kicad_sch, userport.kicad_sch]
2024-02-25 tidy up C1565 port schematic and plumbing
    [c1565.kicad_sch]
2024-02-25 reroute 1565 clock, LD and 5V WIFI_EN line
    [c1565.kicad_sch, mega65-r3-expansion-board.kicad.kicad_pcb, multiplexorbus.kicad_sch, userport.kicad_sch]
2024-02-25 document WIFI_EN, tidy up a bit more
    [c1565.kicad_sch]
2024-02-25 import mini-din 9 footprint and symbol
2024-02-25 add A/V filter circuits and audio links to bridge board
    [c1565.kicad_sch, mega65-r3-expansion-board.kicad.kicad_pcb, multiplexorbus.kicad_sch, vga.kicad_sch]
2024-02-25 route filters for other video channels
    [mega65-r3-expansion-board.kicad.kicad_pcb]
2024-02-25 video filter routing and DRC good
    [mega65-r3-expansion-board.kicad.kicad_pcb]
2024-02-25 route L and R audio to A/V jack
    [mega65-r3-expansion-board.kicad.kicad_pcb]
2024-02-25 final tidy ups
    [mega65-r3-expansion-board.kicad.kicad_pcb, multiplexorbus.kicad_sch]
2024-02-25 add MEGA65 and open hardware logos etc
    [expansion_connector_board.kicad_pcb, expansion_connector_board.kicad_sch]
2024-02-25 add audio J19 pickup header
    [expansion_connector_board.kicad_pcb, expansion_connector_board.kicad_sch]
2024-02-25 begin working on C1565 PCB
    [external_drive_board.kicad_pcb, external_drive_board.kicad_sch]
2024-02-25 add more logic to C1565 board
    [external_drive_board.kicad_sch]
2024-02-25 add inverter and complete schematic
    [external_drive_board.kicad_sch]
2024-02-25 begin work on layout
    [external_drive_board.kicad_pcb, external_drive_board.kicad_sch]
2024-02-25 fix floating gate inputs
    [c1565.kicad_sch, mega65-r3-expansion-board.kicad.kicad_pcb, userport.kicad_sch]
2024-02-25 gerbers exported and uploaded to pcbway
    [expansion_connector_board.kicad_pcb, mega65-r3-expansion-board.kicad.kicad_pcb]
2024-02-28 add dipsw reading to M1565 via spare bit
    [external_drive_board.kicad_pcb, external_drive_board.kicad_sch, vga.kicad_sch]
2024-02-28 route +5V and GND on M1565 board
    [external_drive_board.kicad_pcb, external_drive_board.kicad_sch]
2024-02-29 more work on M1565 board
    [external_drive_board.kicad_pcb, external_drive_board.kicad_sch]
2024-03-22 more work on external drive board
    [external_drive_board.kicad_pcb]
2024-03-22 revF bridging board (fix 8pin header placement, enlarge thermal holes)
    [expansion_connector_board.kicad_pcb]
2024-03-29 finish M1565 initial board rev
    [external_drive_board.kicad_pcb, external_drive_board.kicad_sch]
2026-05-22 improve silk-screen for bridge board. Call it revF.2
    [expansion_connector_board.kicad_pcb]
2026-07-12 remove ESP32 and replace with PicoPi W and JTAG hijack for core loader
    [expansion_connector_board.kicad_pcb, expansion_connector_board.kicad_sch]
2026-07-13 rework bridge board for Pico Pi instead of ESP32
    [10067847-001RLF.step, 2-1825027-0.step, expansion_connector_board.kicad_pcb, expansion_connector_board.kicad_sch, mega65-r3-expansion-board.kicad.kicad_pcb]
2026-07-14 add bridge board revG BoM
2026-07-14 use hardware SPI pinout
    [expansion_connector_board.kicad_pcb, expansion_connector_board.kicad_sch]
2026-07-16 protect 3.3v from MEGA65 into Pico Pi and generl tidying
    [expansion_connector_board.kicad_pcb, expansion_connector_board.kicad_sch]
2026-10-11 Move the jtag base board version to a subdirectory
