MEGA65/mega65-r3-expansion-board/(notices)

Notices in the files:
external_drive_board/external_drive_board.kicad_pcb:
CC-BY-SA-4.0
pmod_connector_board/pmod_connector_board.kicad_pcb:
(C) Paul Gardner-Stephen 2024, CC-BY 4.0
